KirillYatsenko/tbd/PCB/README.md

Kiсad 9.0 is used

Board status:

STM32MP157 Reviews are required:
  Unit A -  MG Power symbol (Unit A) review done, One more look from another person is required.

  Unit B -

  Unit C -

  Unit D -

  Unit E -

  Unit F -
