KirillYatsenko/tbd/PCB/DOC/Seeed NPi - STM32MP157C v1.0_191212 (3).pdf

# Initial Release

03 | 1000M Ethernet

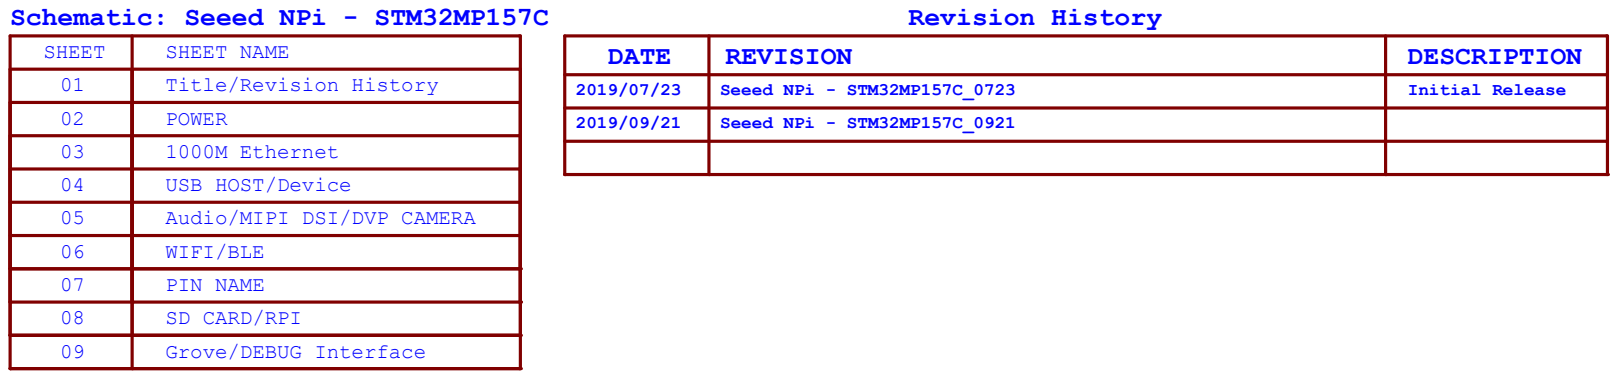
[picture p5: page 1]
Seeed NPi - STM32MP157C_0723; DESCRIPTION; DATE; Revision History; SHEET; SHEET NAME; REVISION; Schematic: Seeed NPi - STM32MP157C; Seeed NPi - STM32MP157C_0921; Title: Size:; Document Number:; Rev: Draw By:; Date:; Sheet:; https://www.seeedstudio.com A3; v1.01 weifeng; Monday, December 16, 2019; 9 Seeed NPi - STM32MP157C; 01 Title / Revision History Title: Size:

Title/Revision History
POWER

04 | USB HOST/Device
05 | Audio/MIPI DSI/DVP CAMERA
06 | WIFI/BLE
07 PIN NAME
08 SD CARD/RPI
09 Grove/DEBUG Interface

01 Title / Revision History

# Input Current:2A

# Output Current:3A

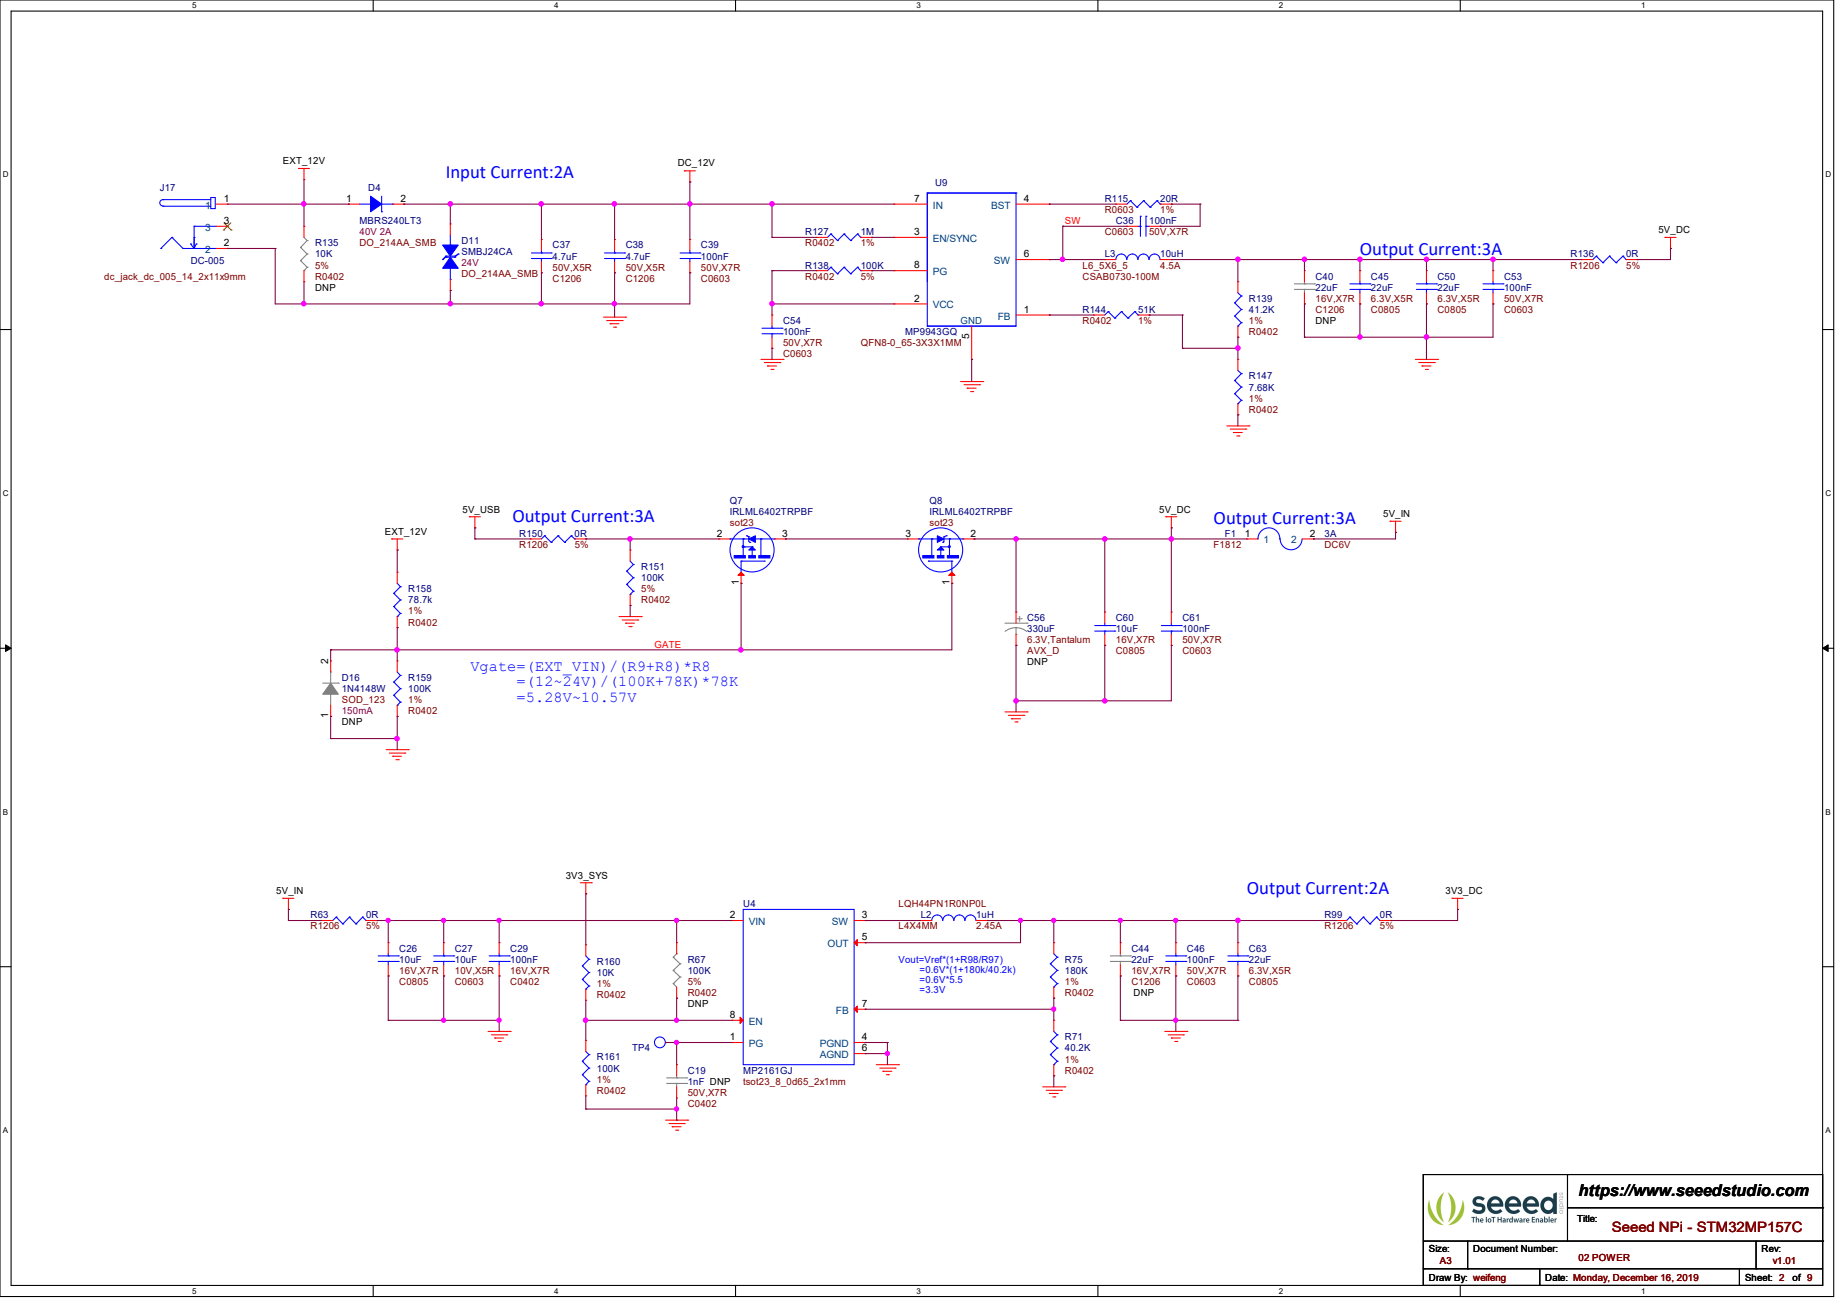
[picture p6: page 2]

# Pin33 PHY Address: 0 (Default) Dis 125MHz Output

# impedance. CLK125_EN:

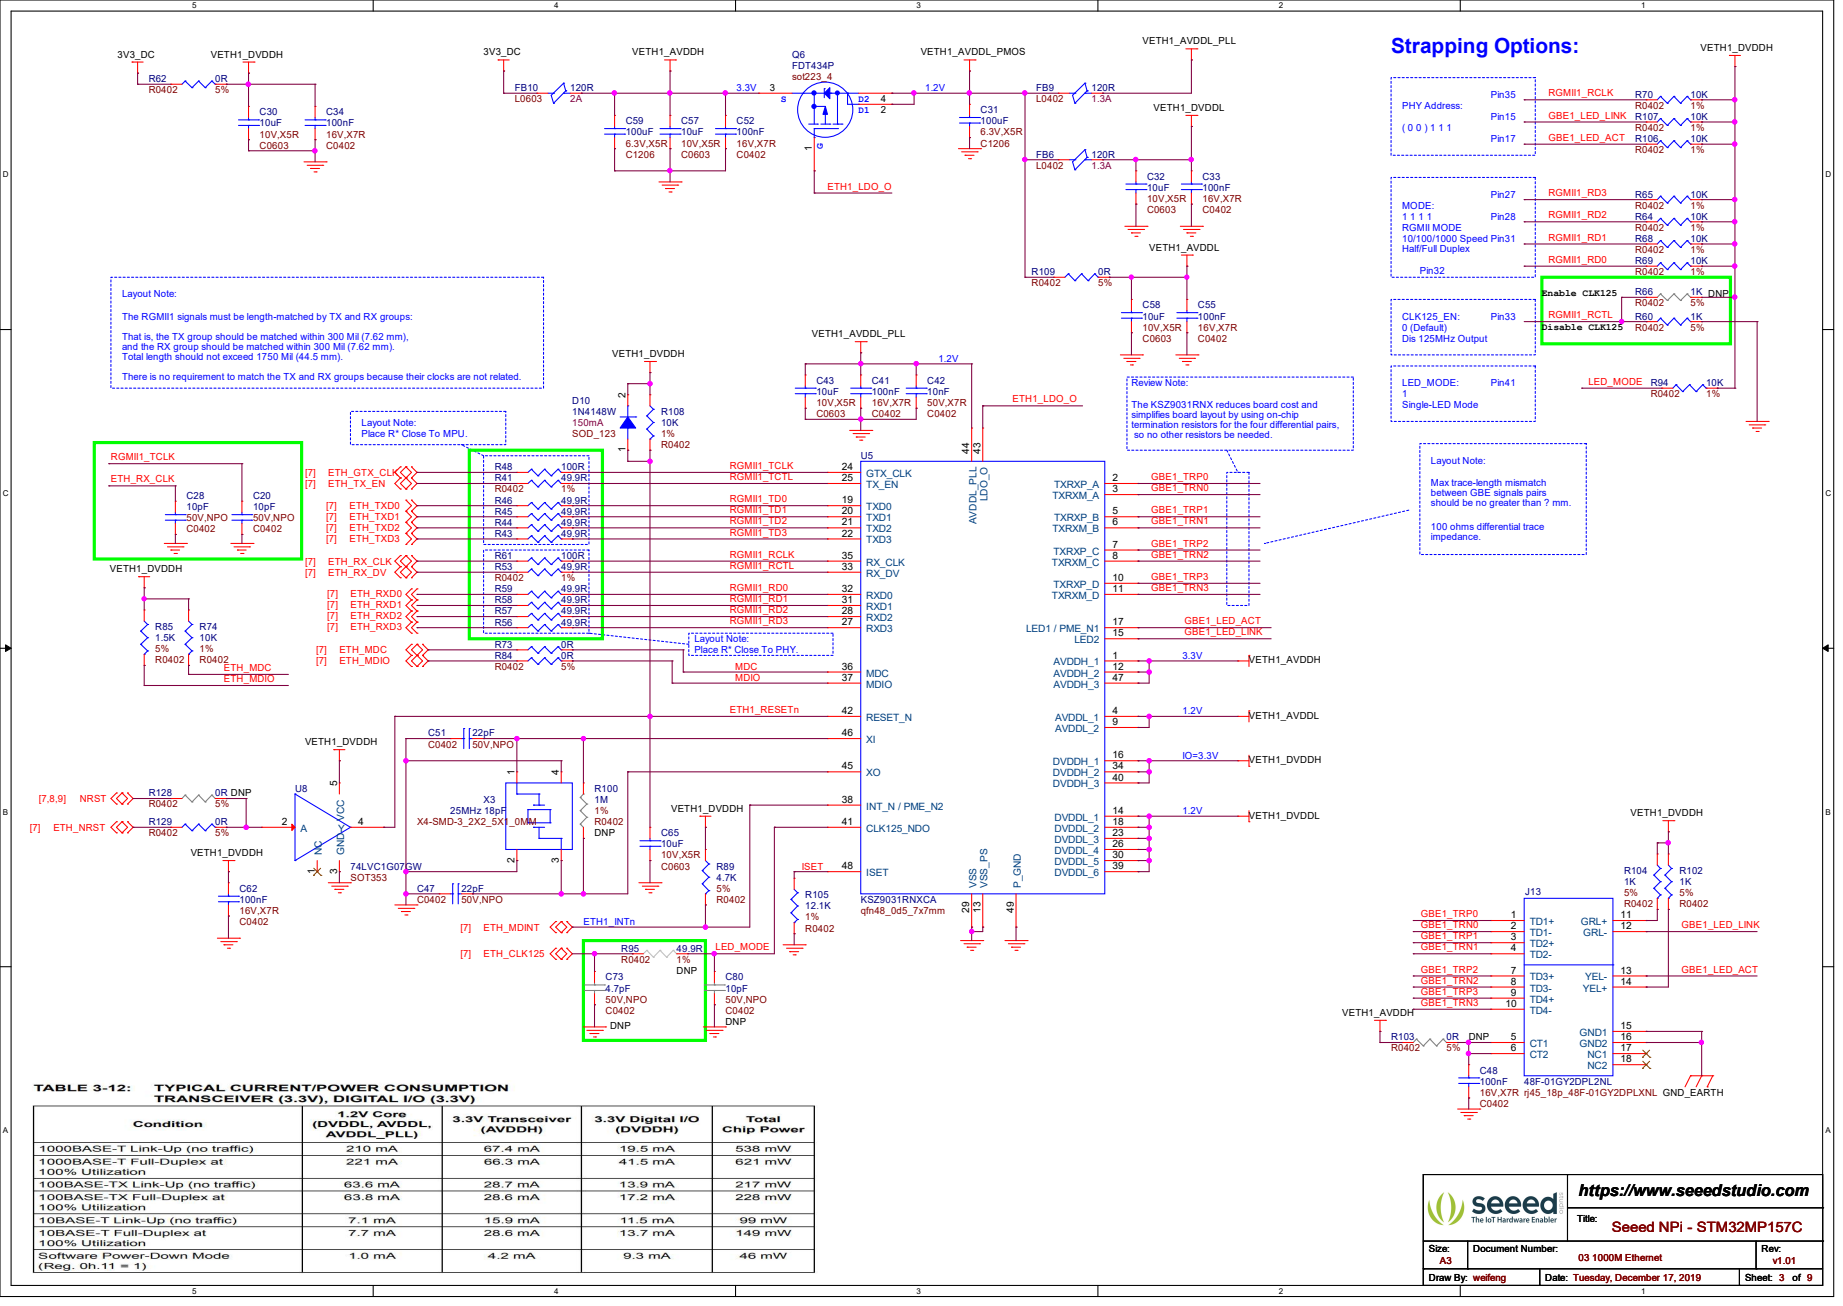
[picture p7: page 3]

LED_MODE: The KSZ9031RNX reduces board cost and

simplifies board layout by using on-chip
termination resistors for the four differential pairs,

between GBE signals pairs
should be no greater than ? mm.

# USB HOST

USB_A_Upper | USB_B_Lower

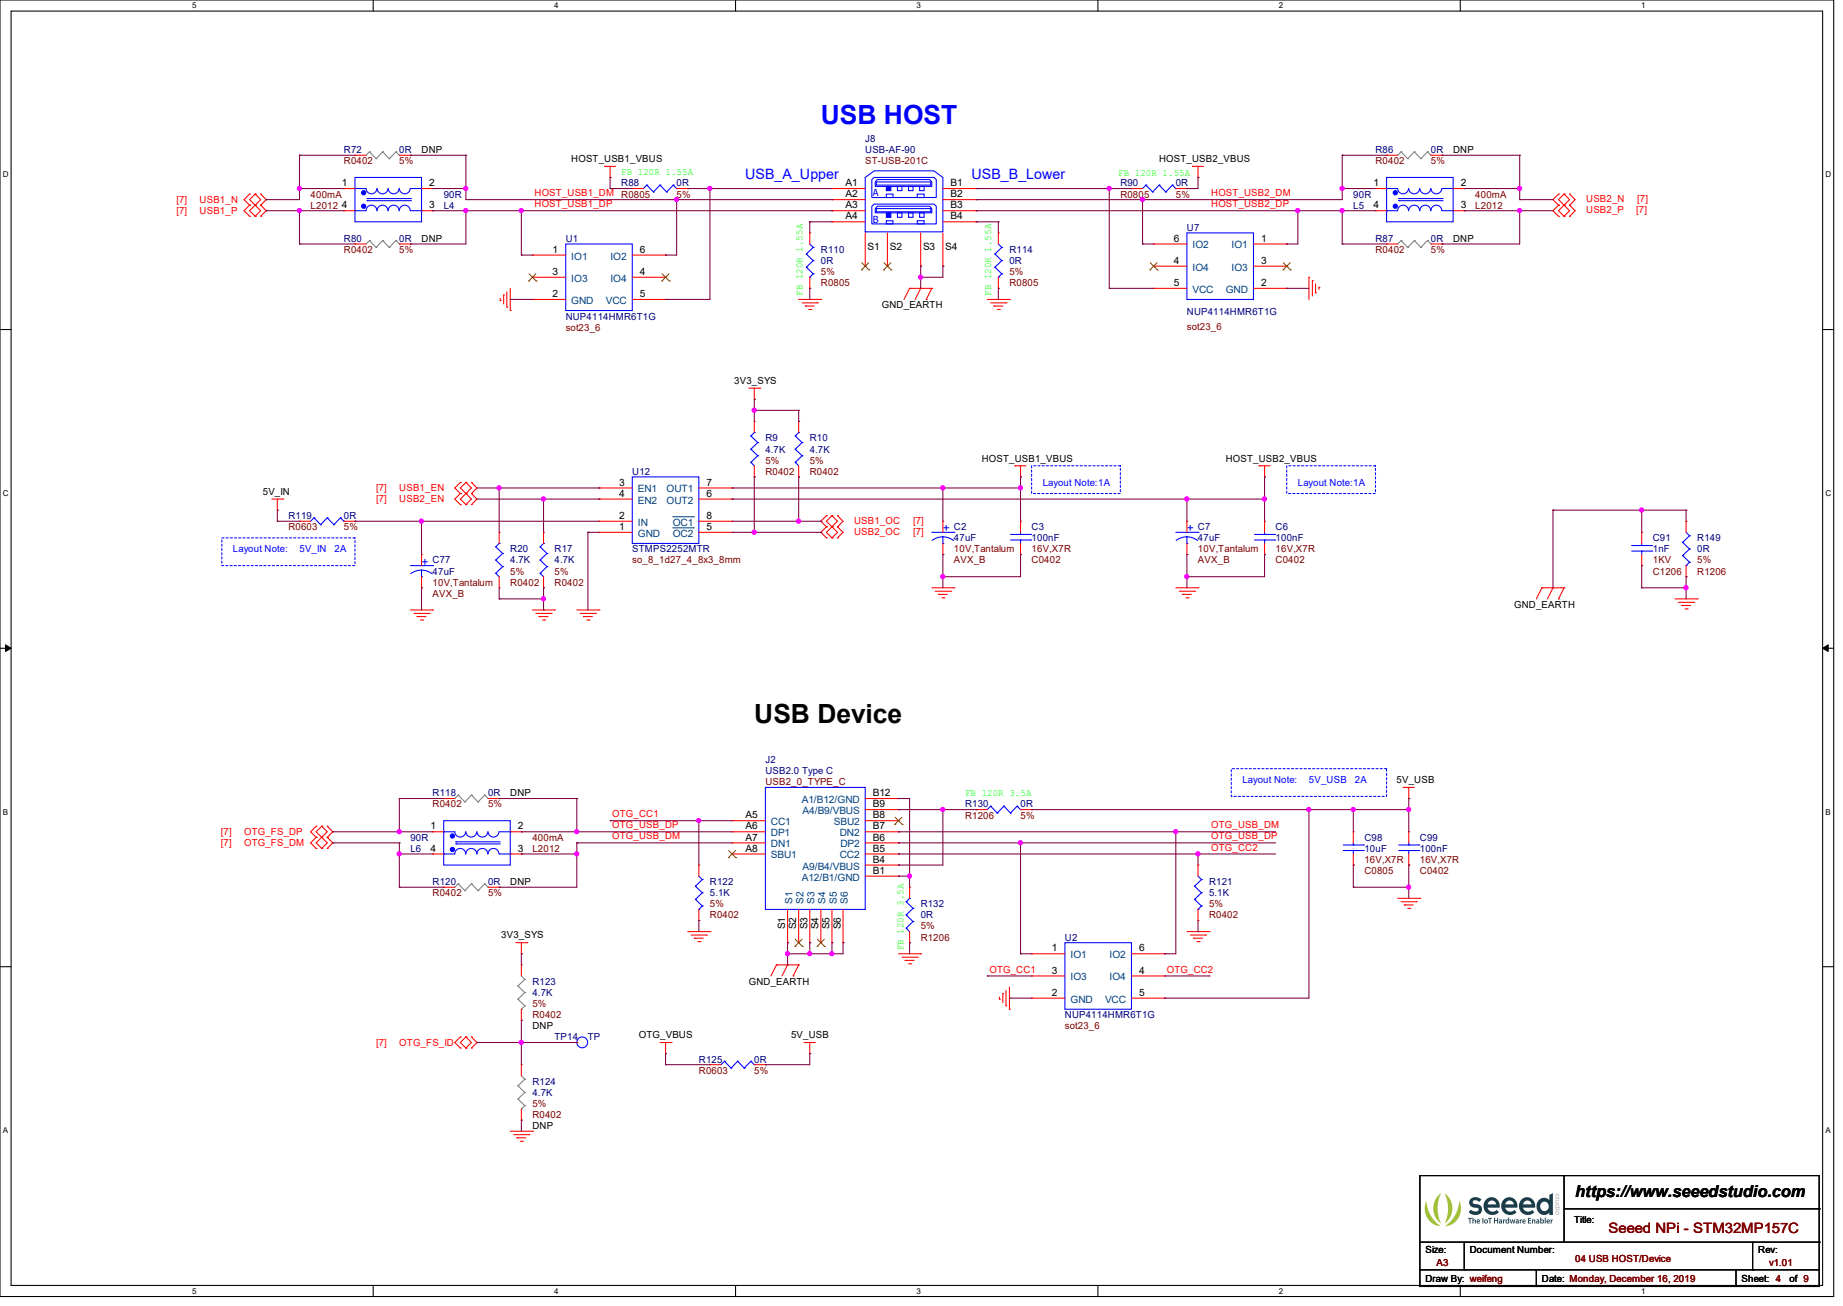
[picture p8: page 4]

# Serial Audio Interface (SAI)

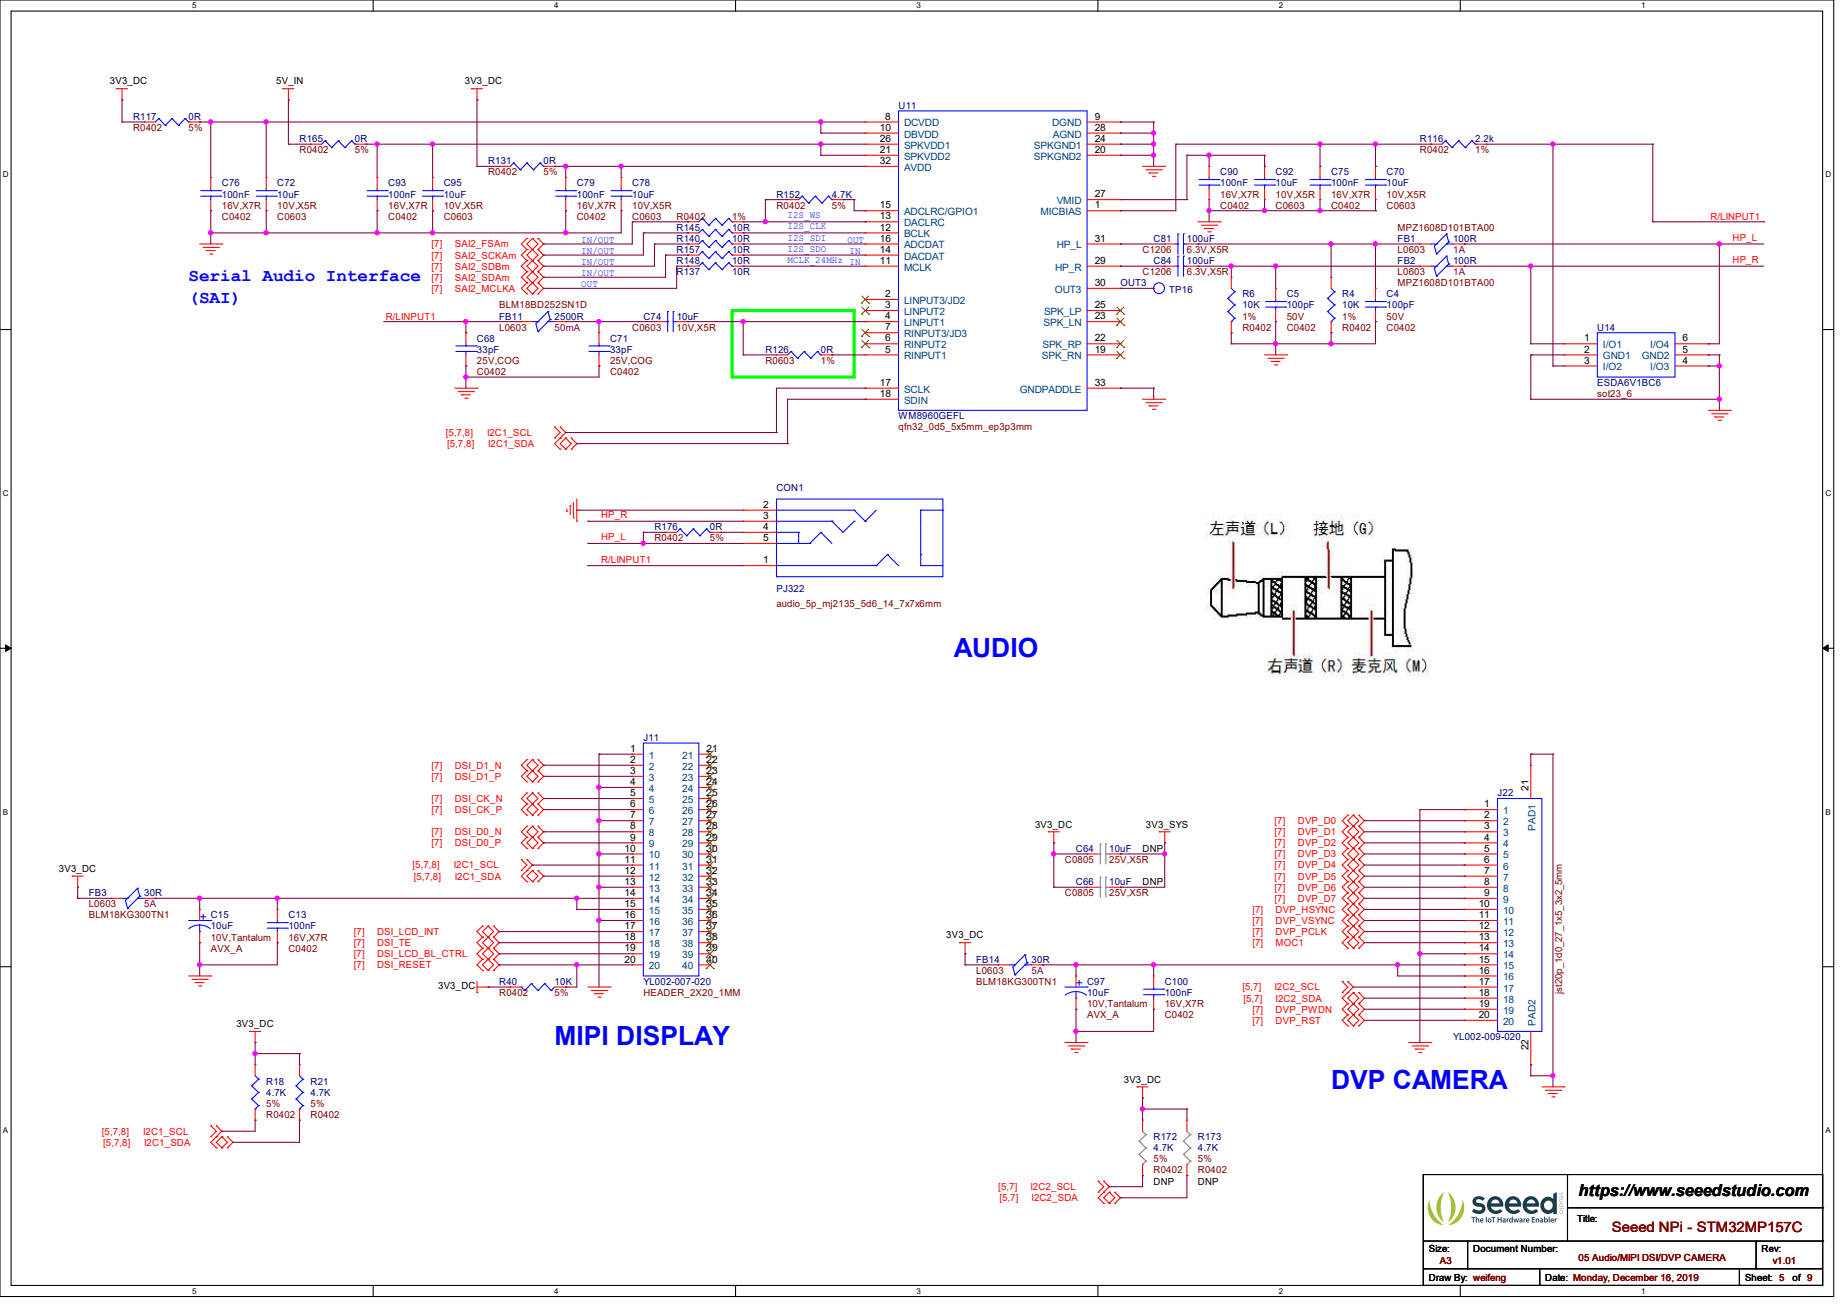
[picture p9: page 5]

U11 WM8960GEFL
DCVDD 8 DBVDD 10 SPKVDD1 26 SPKVDD2 21 AVDD 32 ADCLRC/GPIO1 15 DACLRC 13 BCLK 12 ADCDAT 16 DACDAT 14 MCLK 11

05 Audio/MIPI DSI/DVP CAMERA

# U3 AP6236 Module44-0_9-12X12X1_5MM

GND 1 | WL_BT_ANT 2 | GND_1 3 | FM_RX 4 | NC 5 | BT_WAKE 6 | BT_HOST_WAKE 7 | NC_1 8 | VBAT 9 | XTAL_IN 10 | XTAL_OUT 11 | WL_REG_ON 12 | WL_HOST_WAKE 13 | SDIO_DATA_2 14 | SDIO_DATA_3 15 | SDIO_DATA_CMD 16 | SDIO_DATA_CLK 17 | SDIO_DATA_0 18 | SDIO_DATA_1 19 | GND_2 20 | VIN_LDO_OUT 21 | VDDIO 22 | VIN_LDO | 23 LPO | 24 PCM_OUT | 25 PCM_CLK | 26 PCM_IN | 27 PCM_SYNC | 28 NC_2 | 29 NC_3 | 30 GND_3 | 31 NC_4 | 32 GND_4 | 33 BT_RST_N ³⁴ NC_5 35 GND_5 36 GPIO⁴ ³⁷ GPIO³ ³⁸ GPIO² ³⁹ GPIO¹ ⁴⁰ UART_RTS_N ⁴¹ UART_TXD ⁴² UART_RXD ⁴³ UART_CTS_N ⁴⁴ TP¹ ⁴⁵ TP² ⁴⁶ TP³ ⁴⁷ | FB7 | 120R

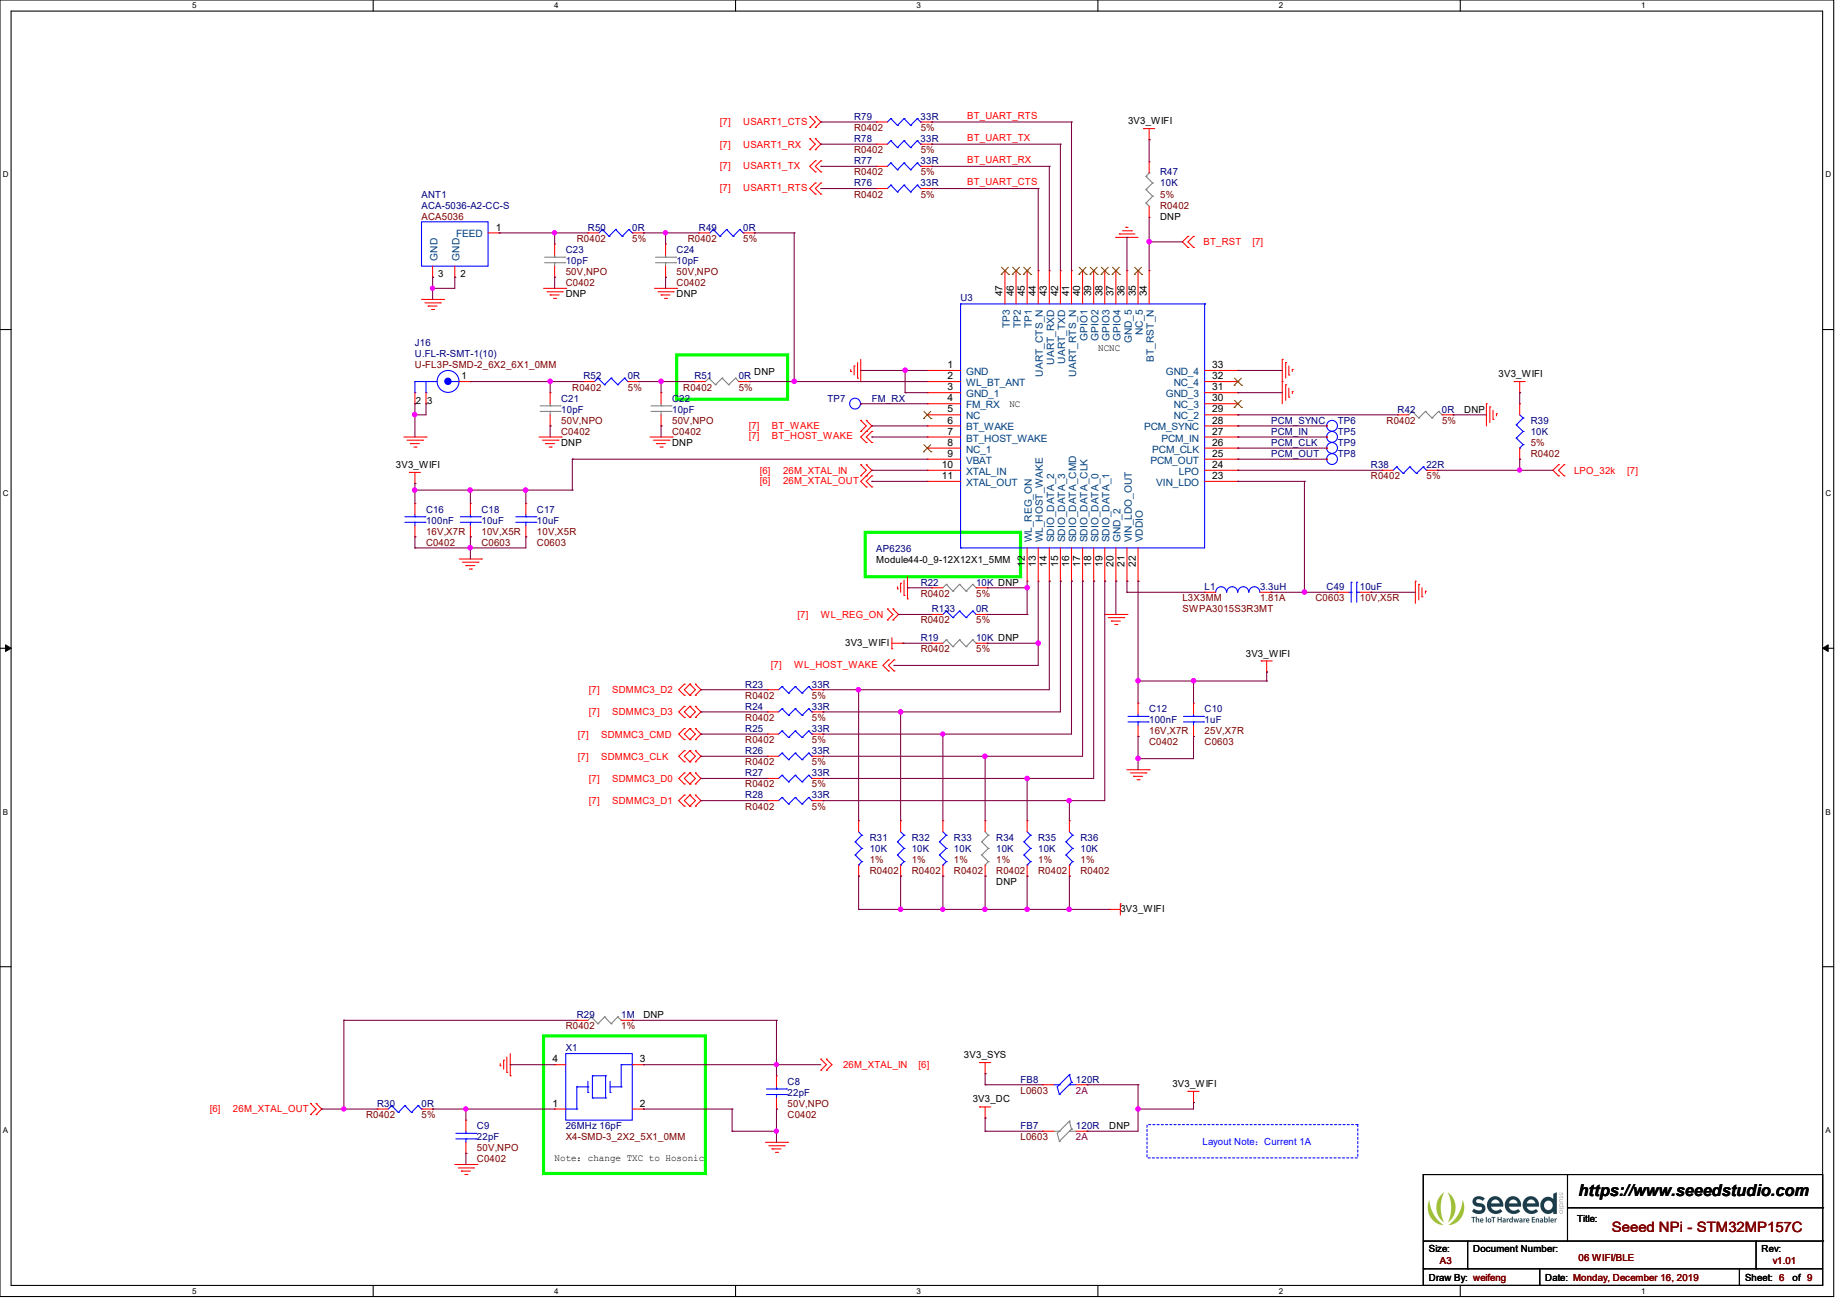
[picture p10: page 6]

Note：change TXC to Hosonic

# LTDC_G1HDMI_CEC

ETH_RX_DV [3] ETH_CLK125 [3] ETH_RX_CLK [3] ETH_GTX_CLK [3] ETH_TX_EN [3] ETH_MDC [3] ETH_MDIO [3] ETH_NRST [3] ETH_MDINT [3] DVP_D0 [5] DVP_D1 [5] DVP_D2 [5] DVP_D3 [5] DVP_D4 [5] DVP_D5 [5] DVP_D6 [5] DVP_D7 [5] DVP_HSYNC | [5] DVP_VSYNC | [5] DVP_PCLK [5] MOC1 [5] DVP_PWDN | [5]

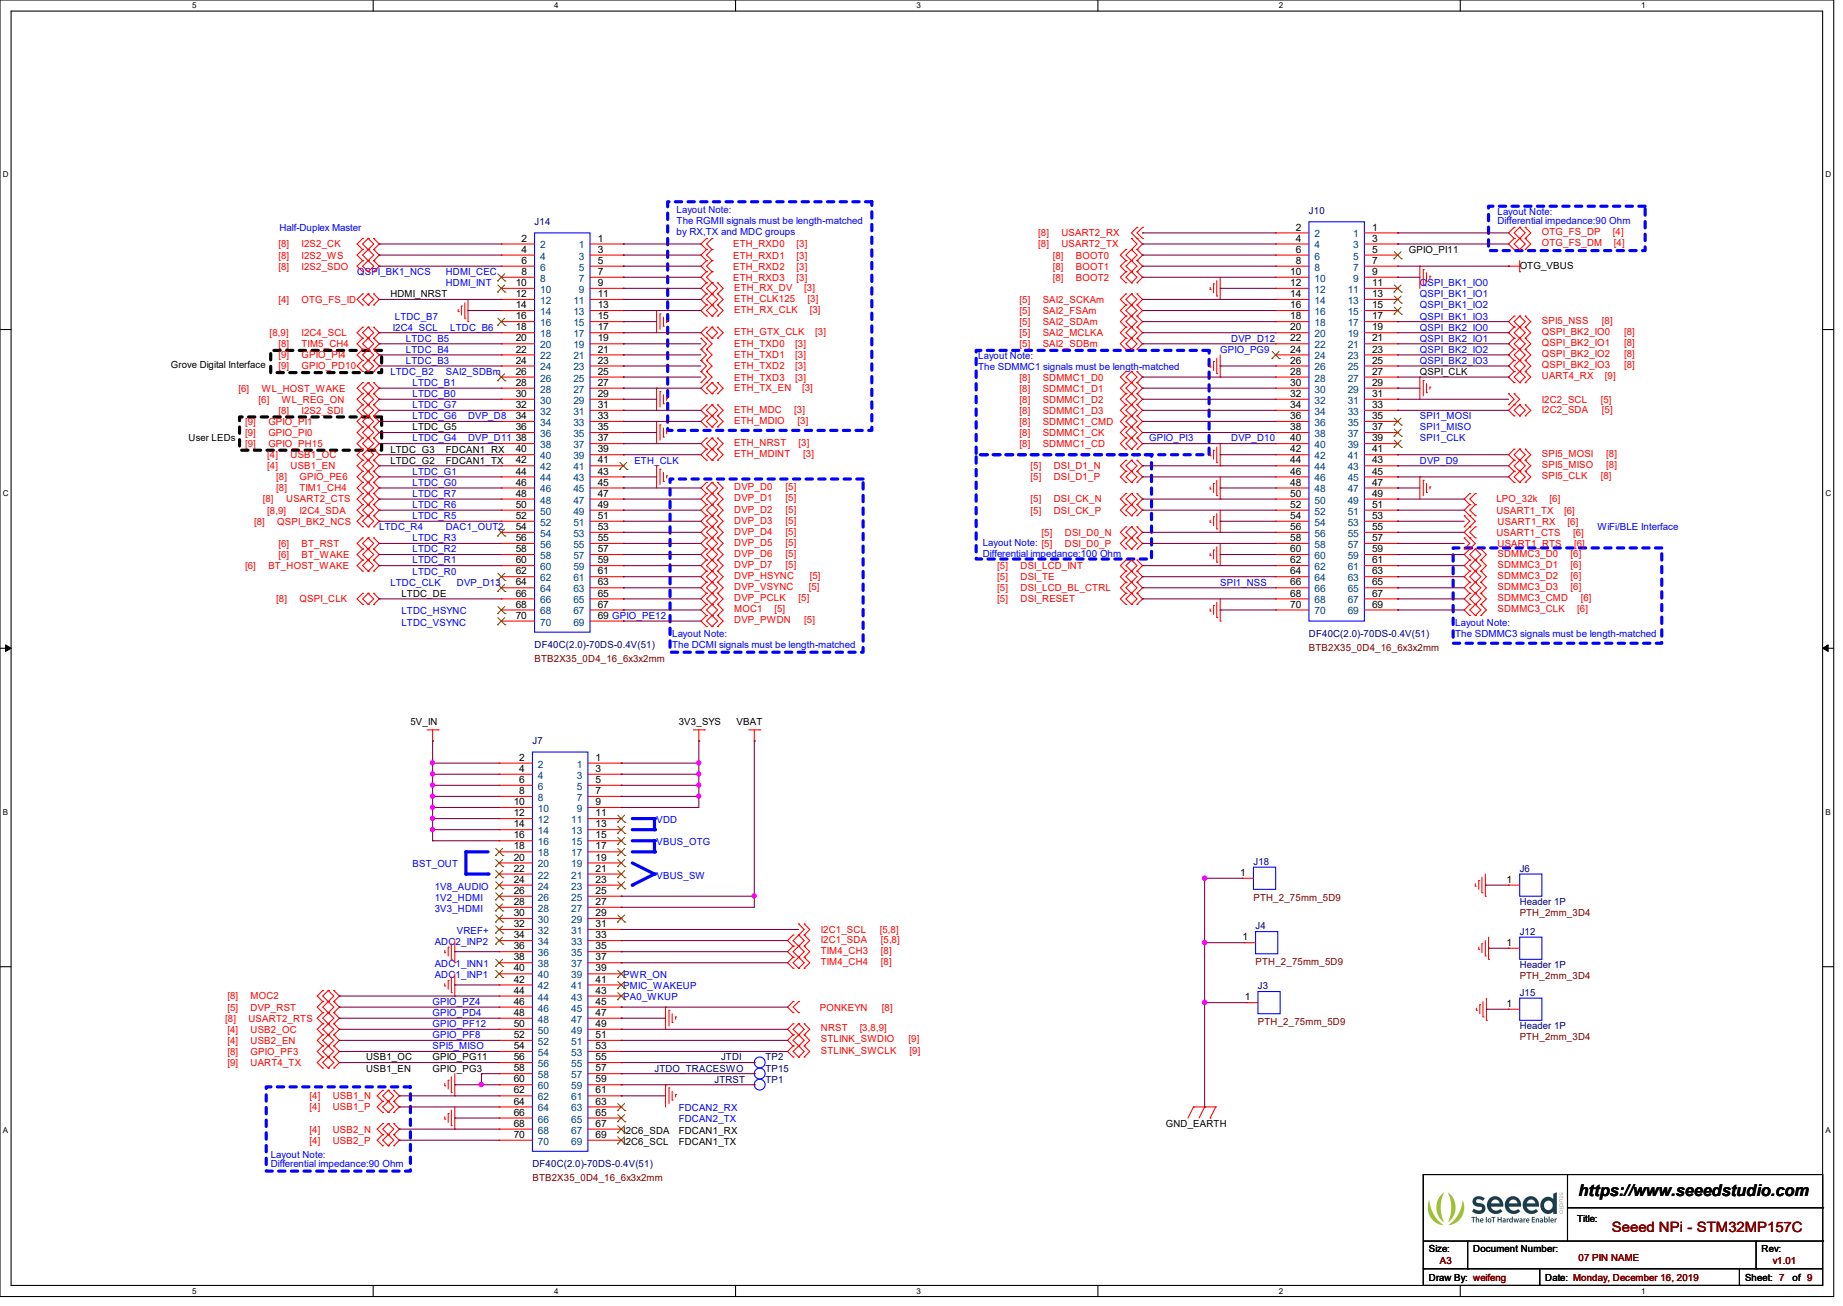
[picture p11: page 7]

Differential impedance:90 Ohm Layout Note: LTDC_B6

Layout Note:
The RGMII signals must be length-matched
by RX,TX and MDC groups
LTDC_G7DVP_D13 SAI2_SDBm
LTDC_B1
LTDC_B0

The SDMMC3 signals must be length-matched

The DCMI signals must be length-matched

# RPI Interface

# J19 Header 2x20 2.54mm

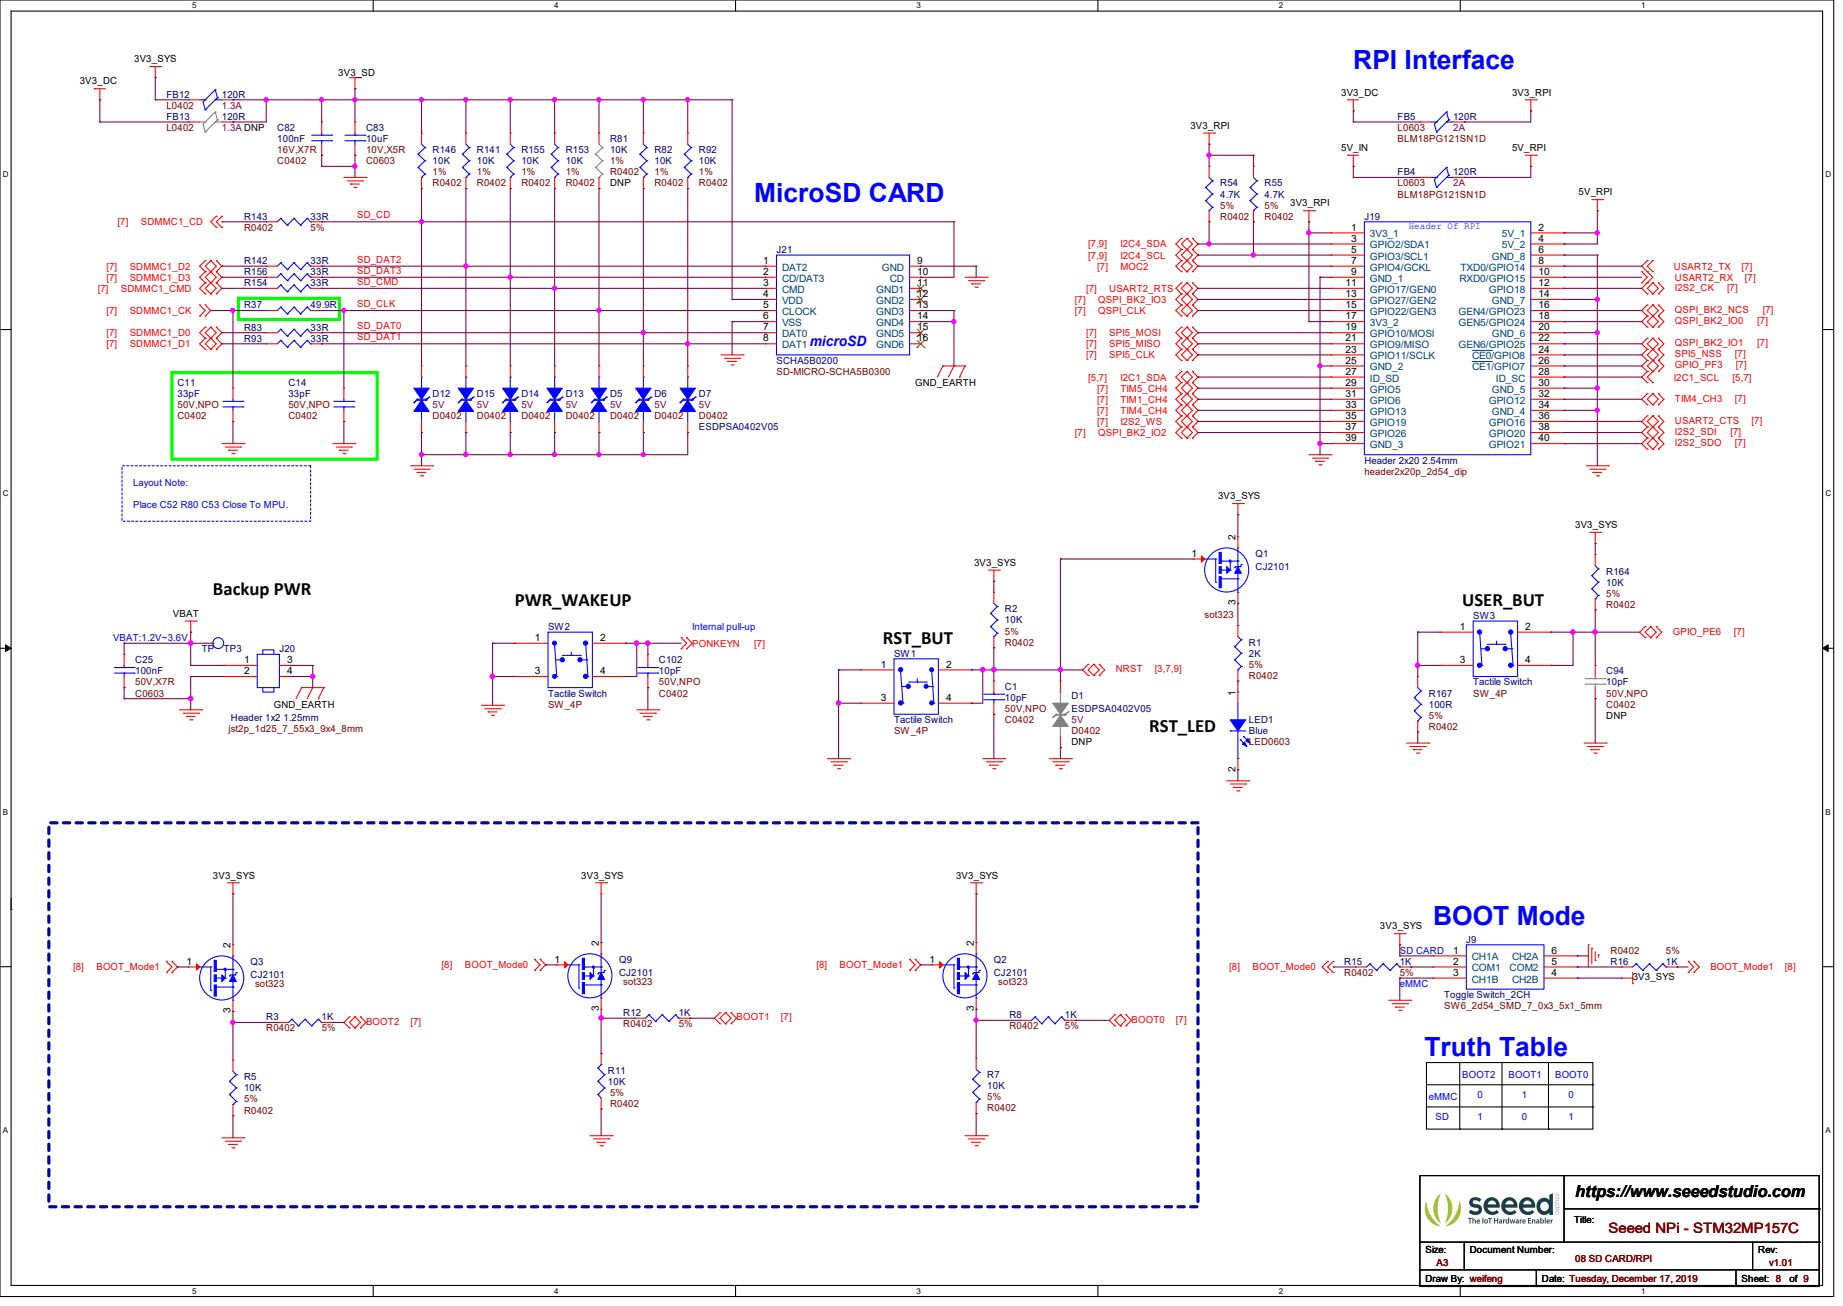
[picture p12: page 8]

MicroSD CARD Layout Note: Place C52 R80 C53 Close To MPU. VBAT:1.2V~3.6V

# USER_LED

USR1 | USR2 | USR0

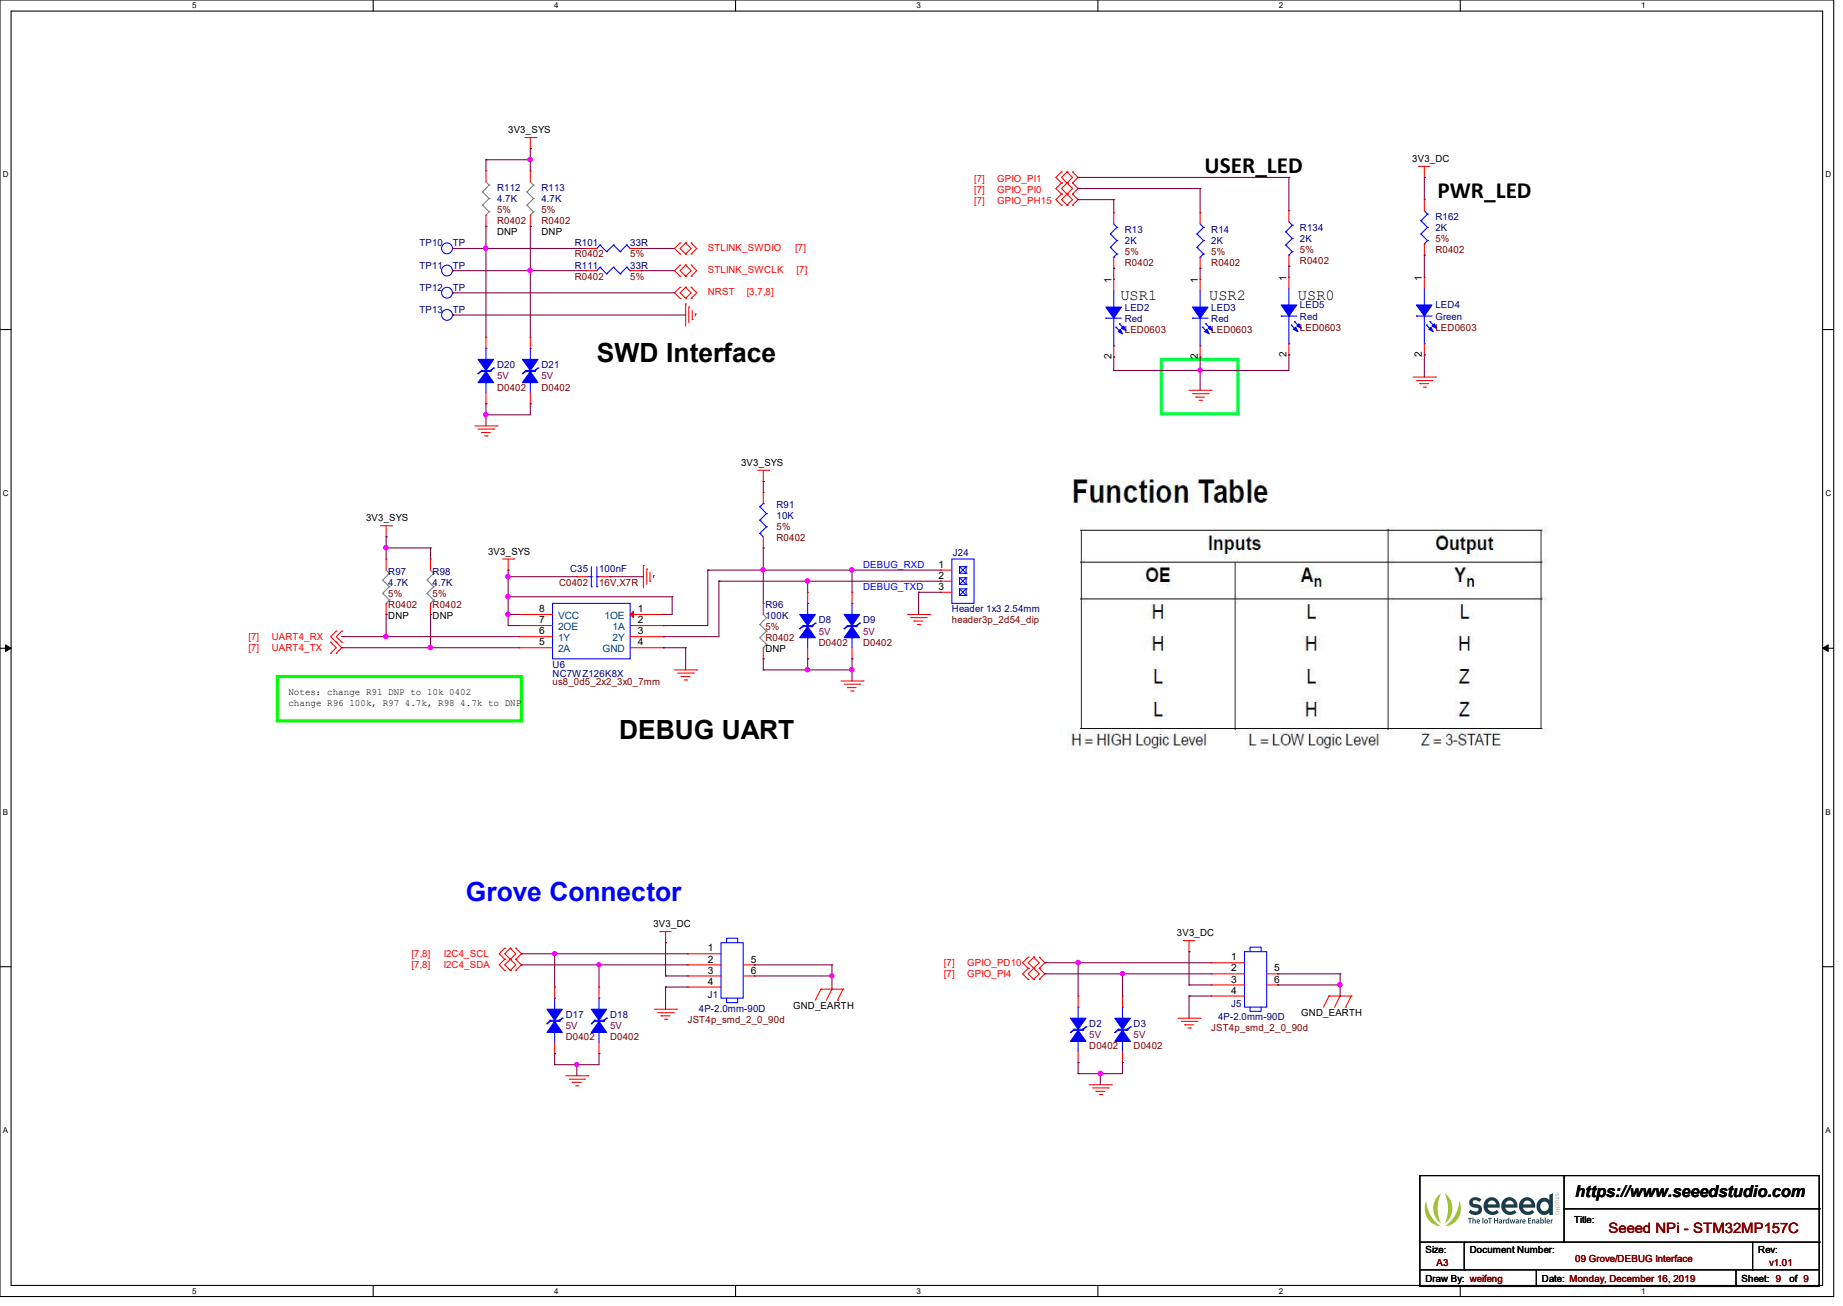
[picture p13: page 9]

Notes：change R91 DNP to 10k 0402
change R96 100k, R97 4.7k, R98 4.7k to DNP
