KirillYatsenko/tbd/PCB/DOC/Seeed SoM - STM32MP157C v1.0_191212 (1).pdf

# Initial Release

03

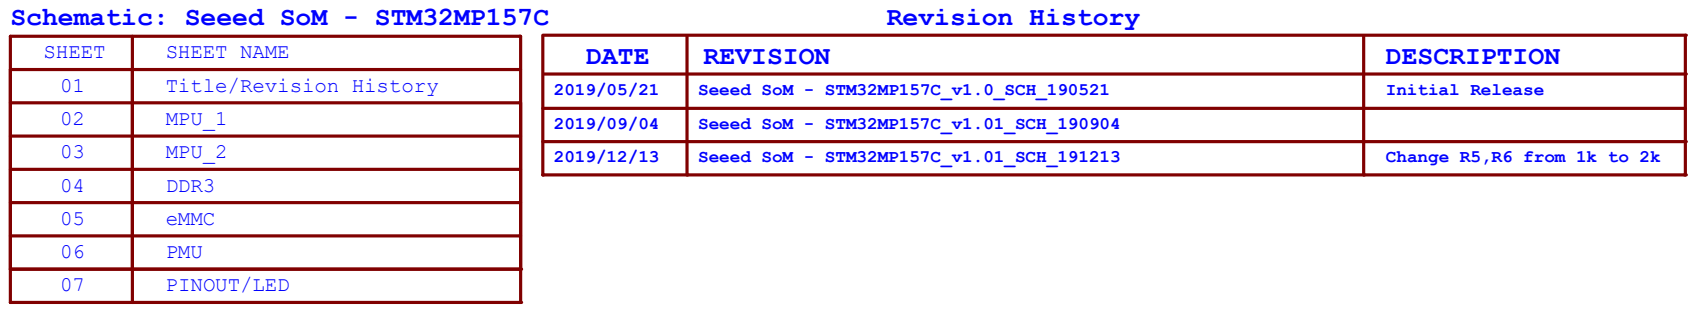
[picture p14: page 1]
Seeed SoM - STM32MP157C_v1.0_SCH_190521; DESCRIPTION; MPU_2; DATE; Title/Revision History; Revision History; SHEET; SHEET NAME; REVISION; Schematic: Seeed SoM - STM32MP157C; MPU_1; Seeed SoM - STM32MP157C_v1.01_SCH_190904; Seeed SoM - STM32MP157C_v1.01_SCH_191213; Change R5,R6 from 1k to 2k; Title: Size:; Document Number:; Rev: Draw By:; Date:; Sheet:; https://www.seeedstudio.com A3; v1.01 weifeng; Friday, December 13, 2019; 7 Seeed SoM - STM32MP157C; 01 Title / Revision History Title: Size:

04 | DDR3
05 | eMMC
06 | PMU
07 PINOUT/LED

01 Title / Revision History

I2S2_SDO | [7] DVP_D0 [7] SDMMC1_D0 [7] SDMMC1_D1 [7] SDMMC1_D2 [7] SDMMC1_D3 [7] SDMMC1_CK [7] SDMMC1_CMD [7] DVP_D5 [7] GPIO_PD4 | [7] SDMMC3_D2 [7] SDMMC3_D3 [7] LTDC_B7 [7] LTDC_B0 [7] LTDC_B3 [7] QSPI_BK1_IO0 | [7] QSPI_BK1_IO1 | [7] STLINK_SWDIO | [7] STLINK_SWCLK | [7] JTDI [7] JTDO_TRACESWO [7] JTRST [7]
ETH_RXD0 [7] ETH_RXD1 [7] FDCAN1_RX | [7] USART2_RX [7] ETH_TXD2 [7] FDCAN1_TX [7] DSI_TE [7]

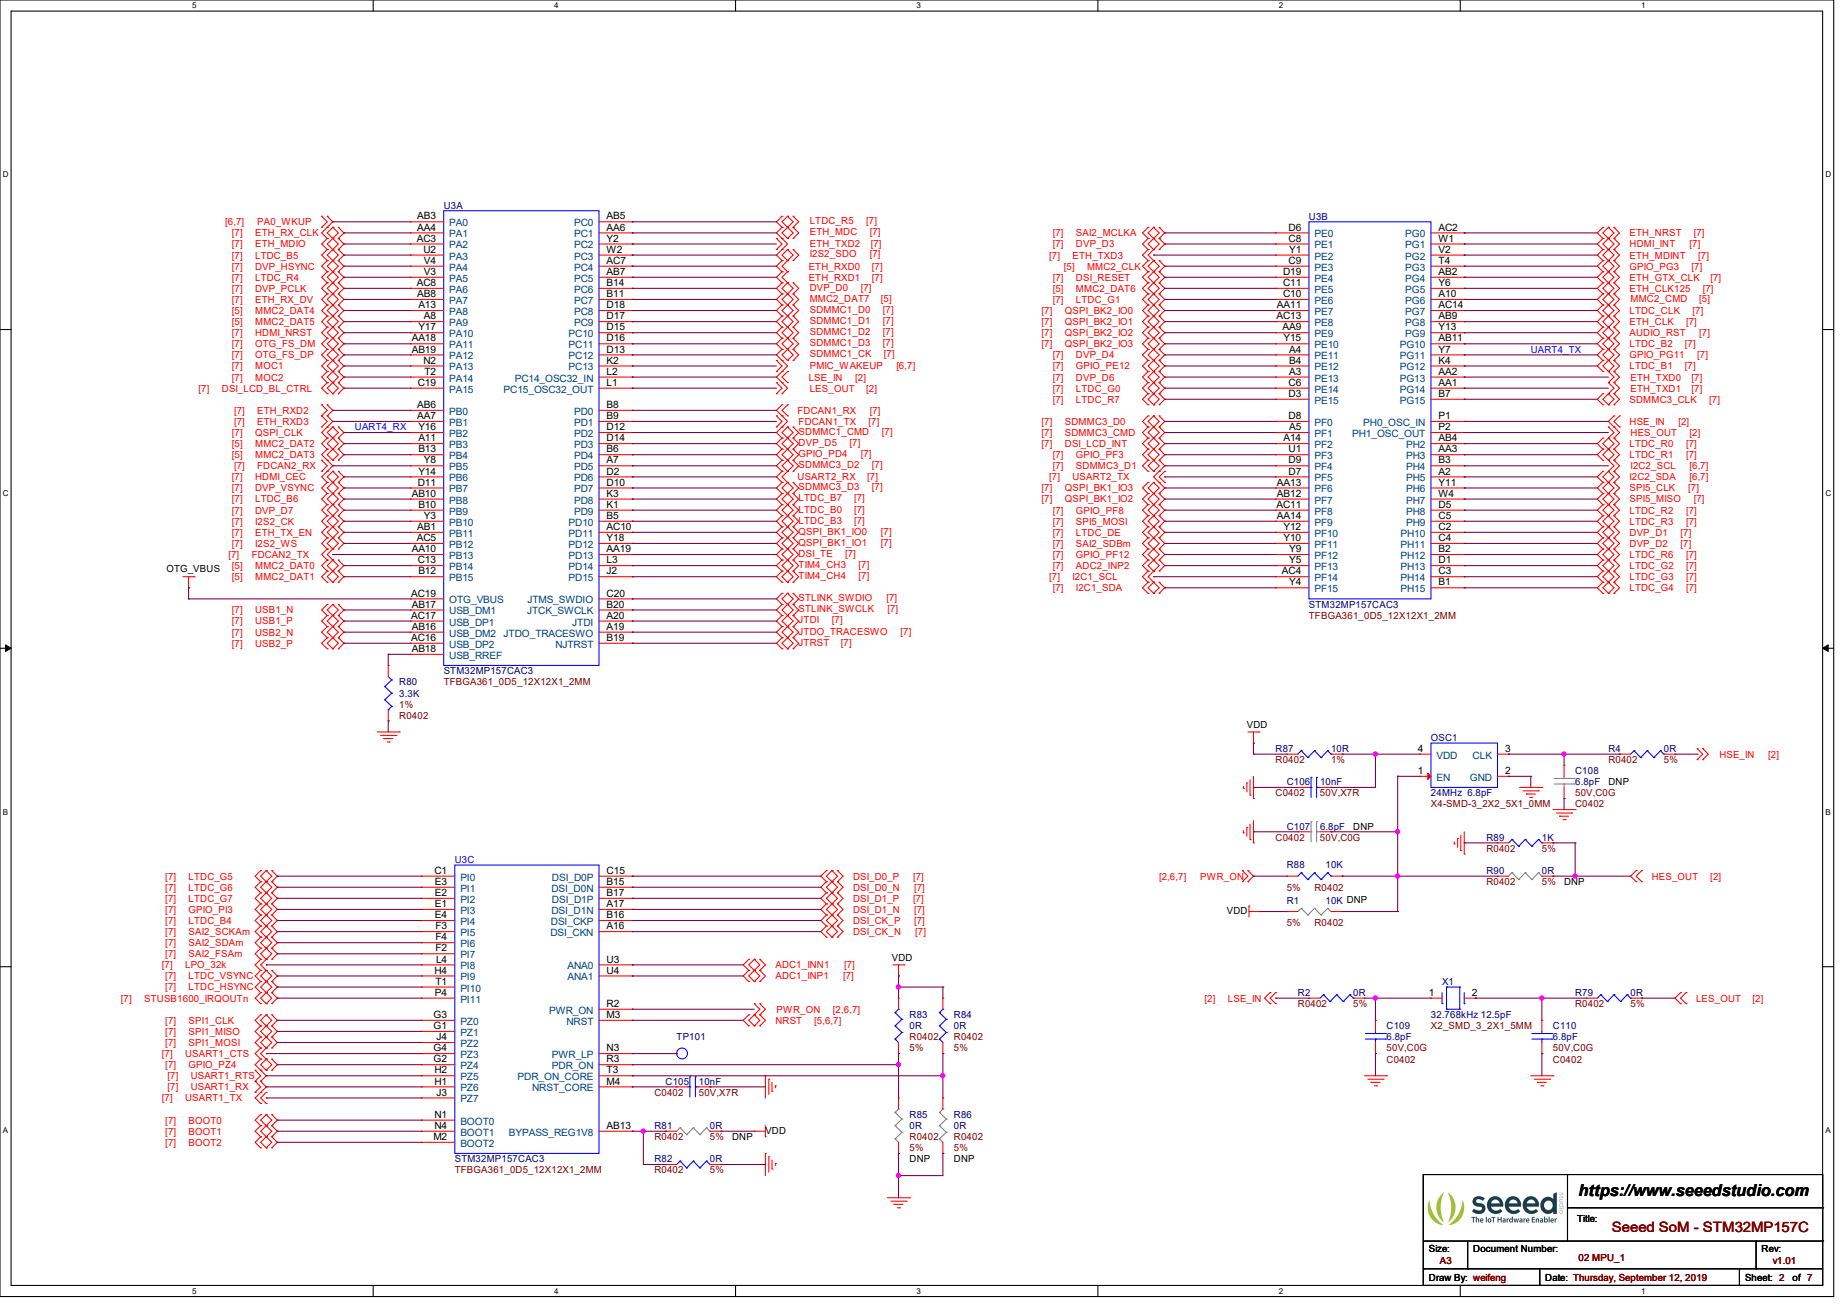
[picture p15: page 2]

VDDCORE1 1A2 VDDCORE2 1A4 VDDCORE3 1A6 VDDCORE4 1B1 VDDCORE5 1B3 VDDCORE6 1B5 VDDCORE7 1C2 VDDCORE8 1C4 VDDCORE9 1C6 VDDCORE10 1D1 VDDCORE11 1D3 VDDCORE12 1D5 VDDCORE13 1D7 VDDCORE14 1E2 VDDCORE15 1E4 VDDCORE16 1E6 VDDCORE17 1F5 VDDCORE18 1F7 VDDCORE19 1G6 VDDCORE20 1H7 VDD1 1F3 VDD2 1G4 VDD3 1H3 VDD4 1H5 VDD5 1J4 VDD6 1J6 VDDQ_DDR1 1A8 VDDQ_DDR2 1B7 VDDQ_DDR3 1B9 VDDQ_DDR4 1C8 VDDQ_DDR5 1D9 VDDQ_DDR6 1E8 VDDQ_DDR7 1F9 VDDQ_DDR8 1G8 VDDQ_DDR9 1H9 VDDQ_DDR10 1J8 VBAT 1F1 VDD_OTP 1J2 VDDA 1H1 VREF+ R4 VSSA 1H2 VDD_ANA 1G2 VDD_DSI B18 VDDA1V1_REG AB15 VDDA1V8_REG AB14 VDDA1V8_DSI C14 VDD1V2_DSI_PHY C17 VDD1V2_DSI_REG C18 VDD3V3_USBHS AA15 VDD3V3_USBFS AA17 VSS_USBHS AA16 VSS_DSI C16 VSS_ANA 1G1

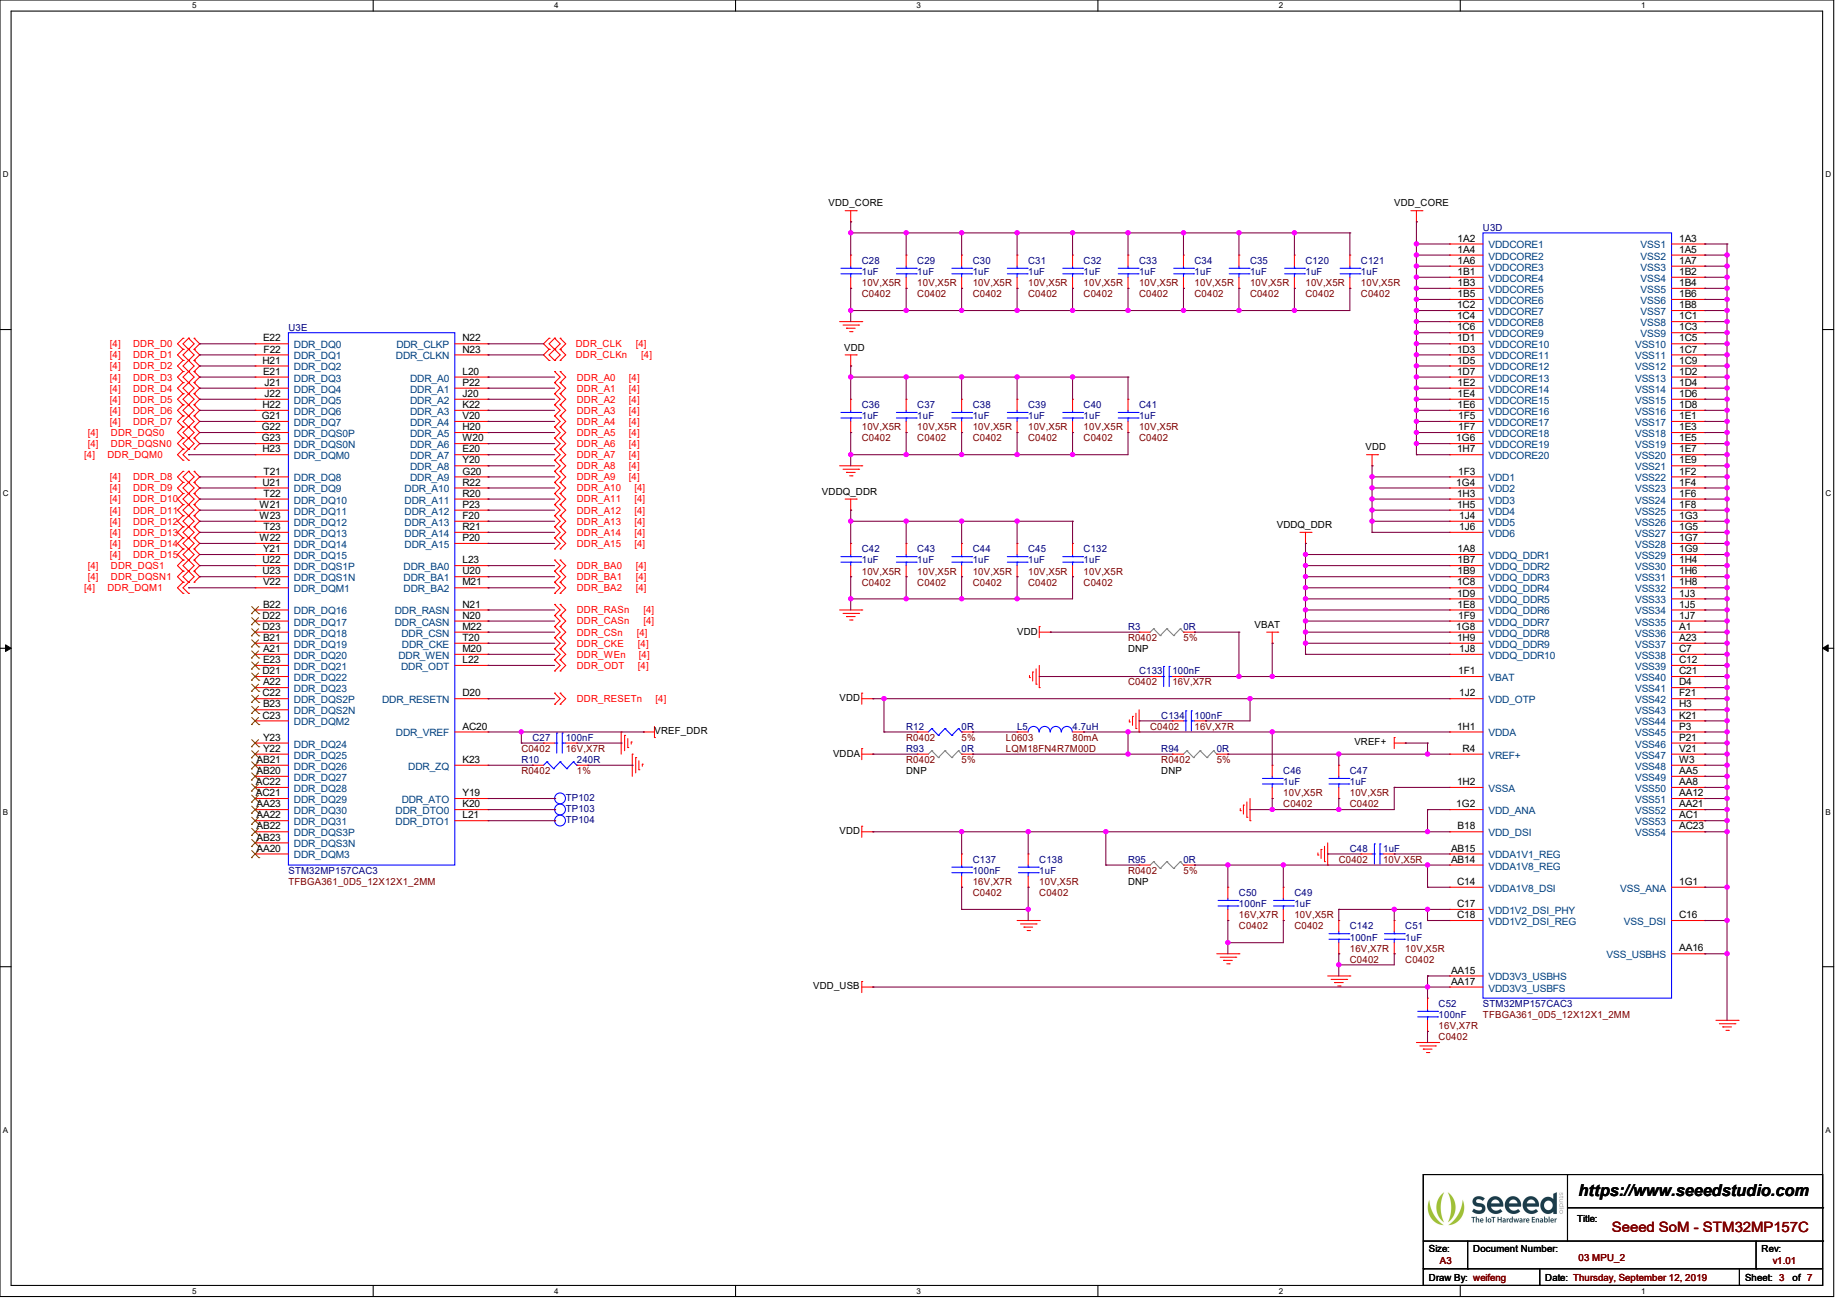
[picture p16: page 3]

# DDR3L SDRAM

CK J7 CKn K7 CKE K9 CSn L2 RASn J3 CASn K3 WEn L3 | A0 N3 A1 P7 A2 P3 A3 N2 A4 P8 A5 P2 A6 R8 A7 R2 A8 T8 A9 R3 A10 L7 A11 R7 A12 N7 A13 T3 A14 T7 BA0 M2 BA1 N8 BA2 M3 DQ0 E3 DQ1 F7 DQ2 F2 DQ3 F8 DQ4 H3 DQ5 H8 DQ6 G2 DQ7 H7 | ODT K1 VSS1 A9 VSS2 B3 VSS3 E1 VSS4 G8 VSSQ4 D8 VSSQ3 D1 VSSQ2 B9 VSSQ1 B1 VSSQ5 E2 VDDQ1 A1 VDDQ2 A8 VDDQ3 C1 VDDQ4 C9 VDDQ5 D2 | VDD1 B2 VDD2 G7 UDQSn B7 UDM D3

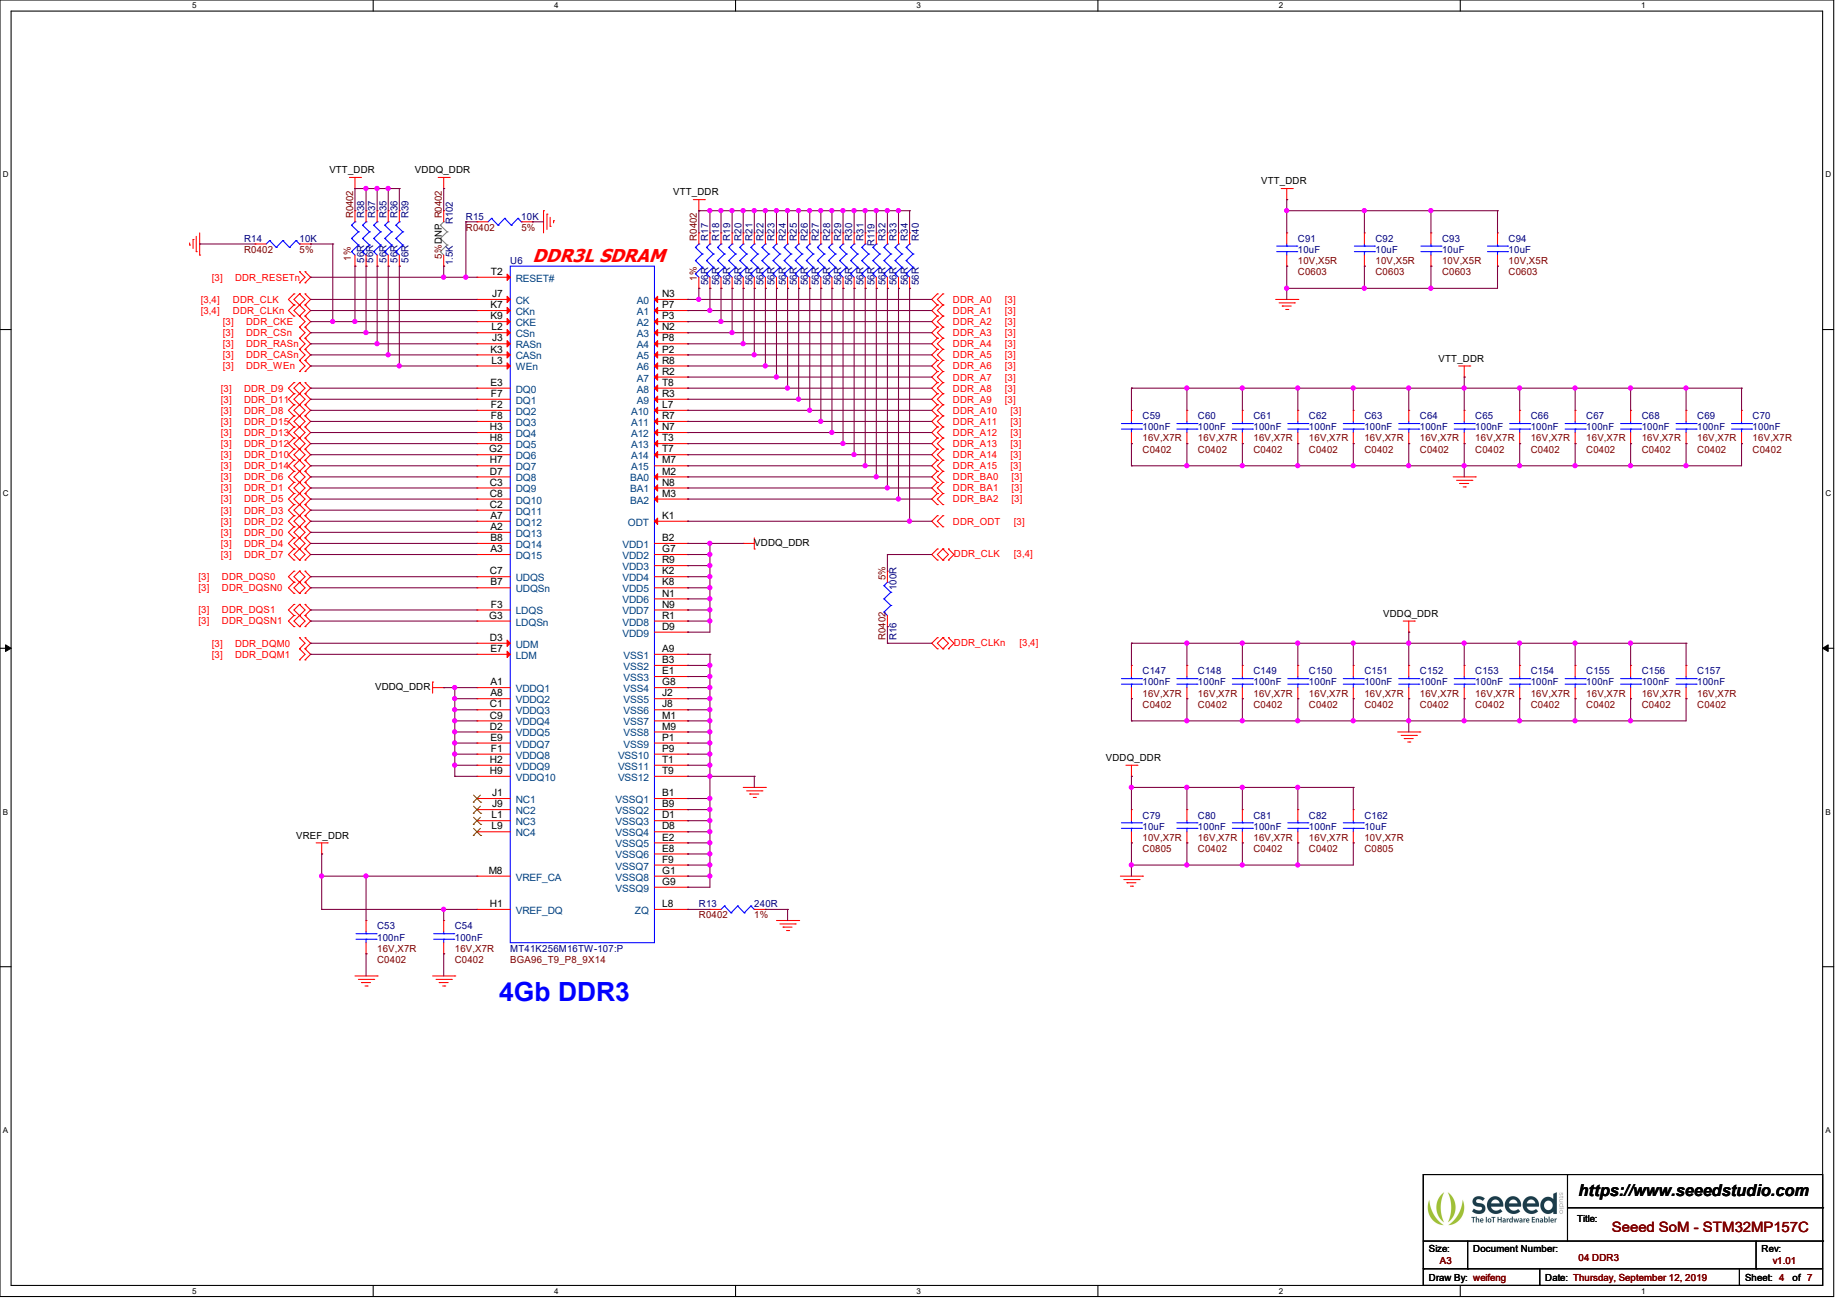
[picture p17: page 4]

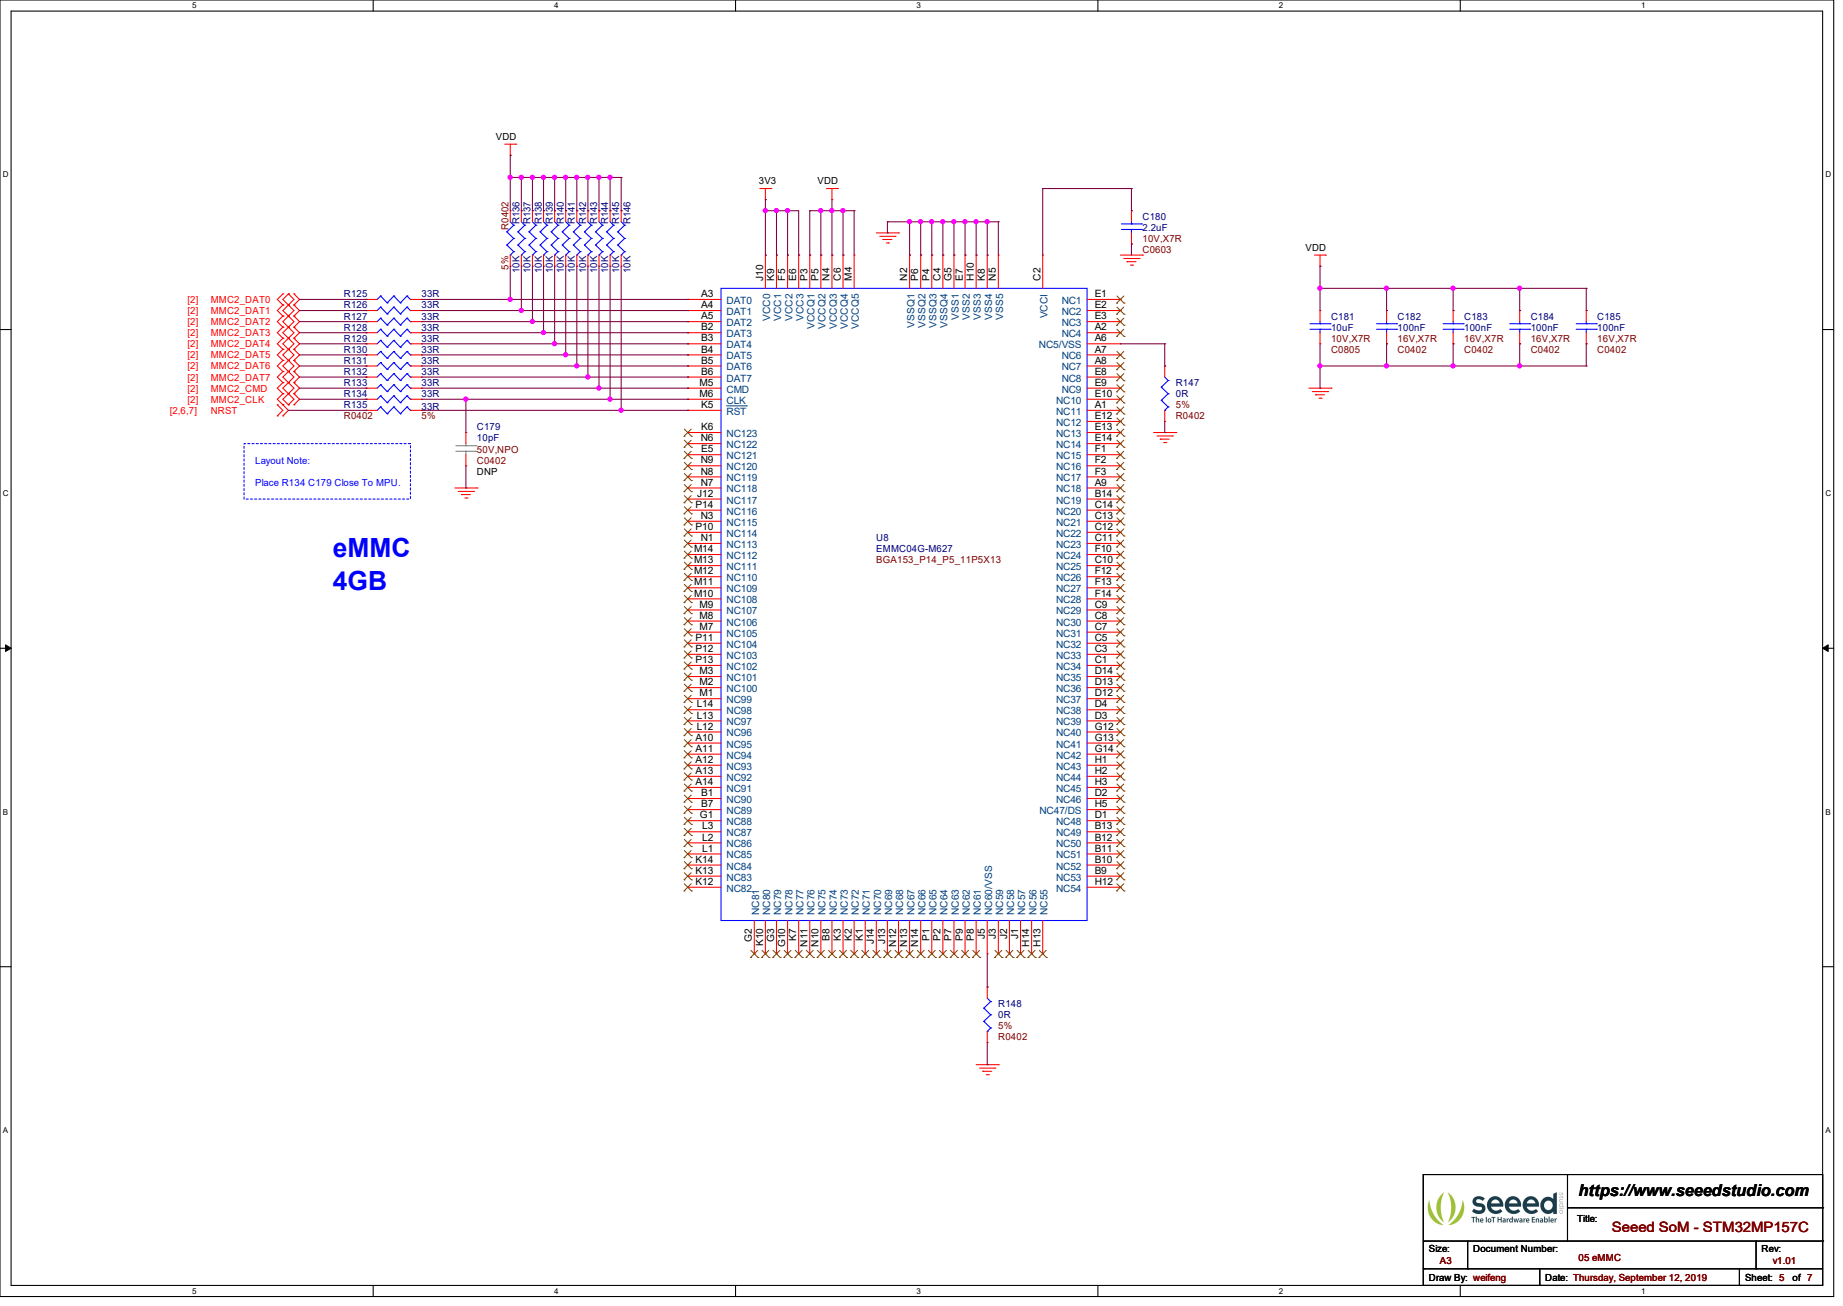
[picture p18: page 5]

eMMC Place R134 C179 Close To MPU.

## Defaut Output:1.2V

## Defaut Output:1.1V

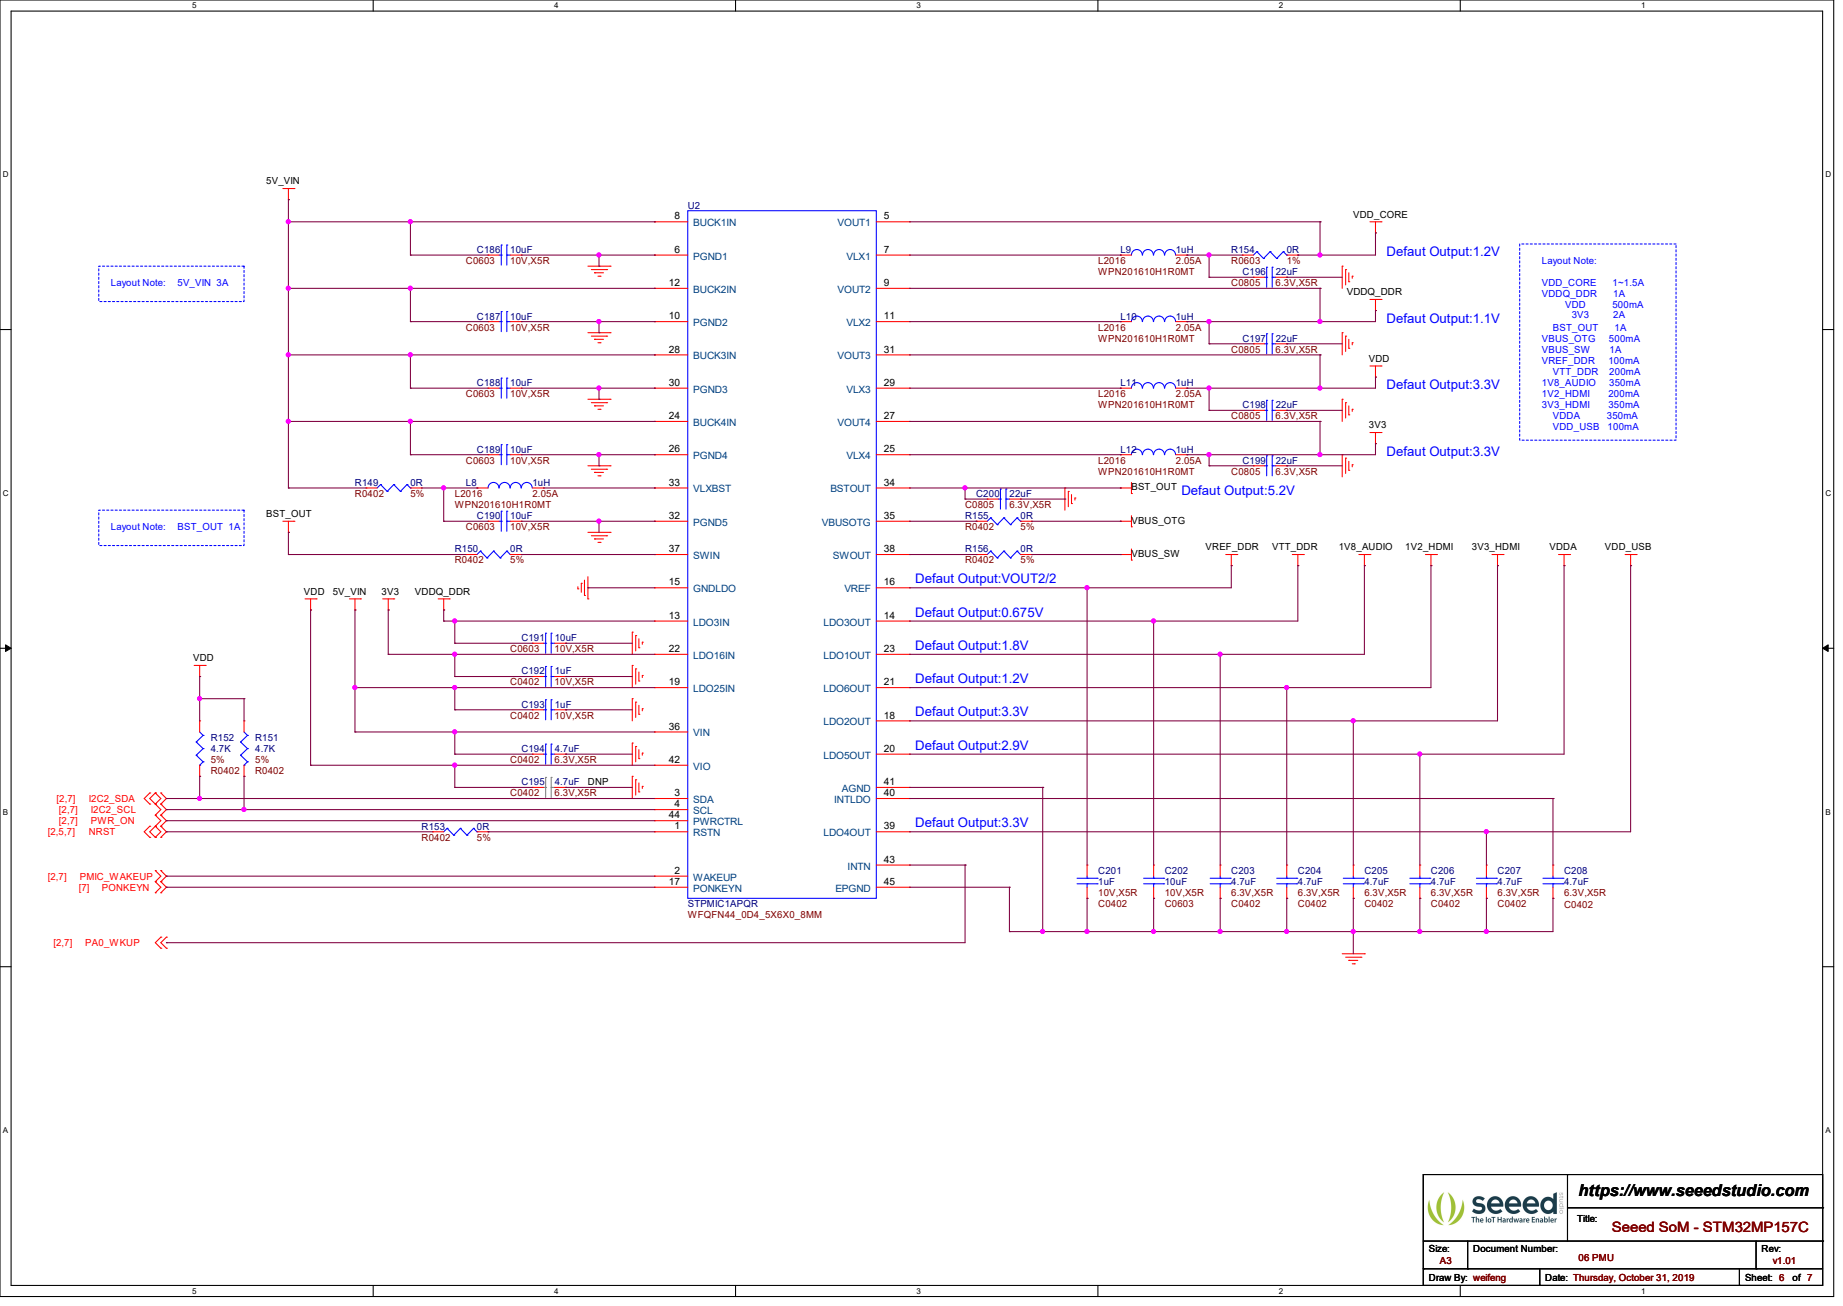
[picture p19: page 6]

VOUT1 5 VLX1 7 VOUT2 9 VLX2 11 VOUT3 31 VLX3 29 VOUT4 27 VLX4 25 BSTOUT 34 VBUSOTG 35 SWOUT 38 VREF 16

# I2C4_SCL DAC1_OUT2

# OTG_FS_ID QSPI_CLK

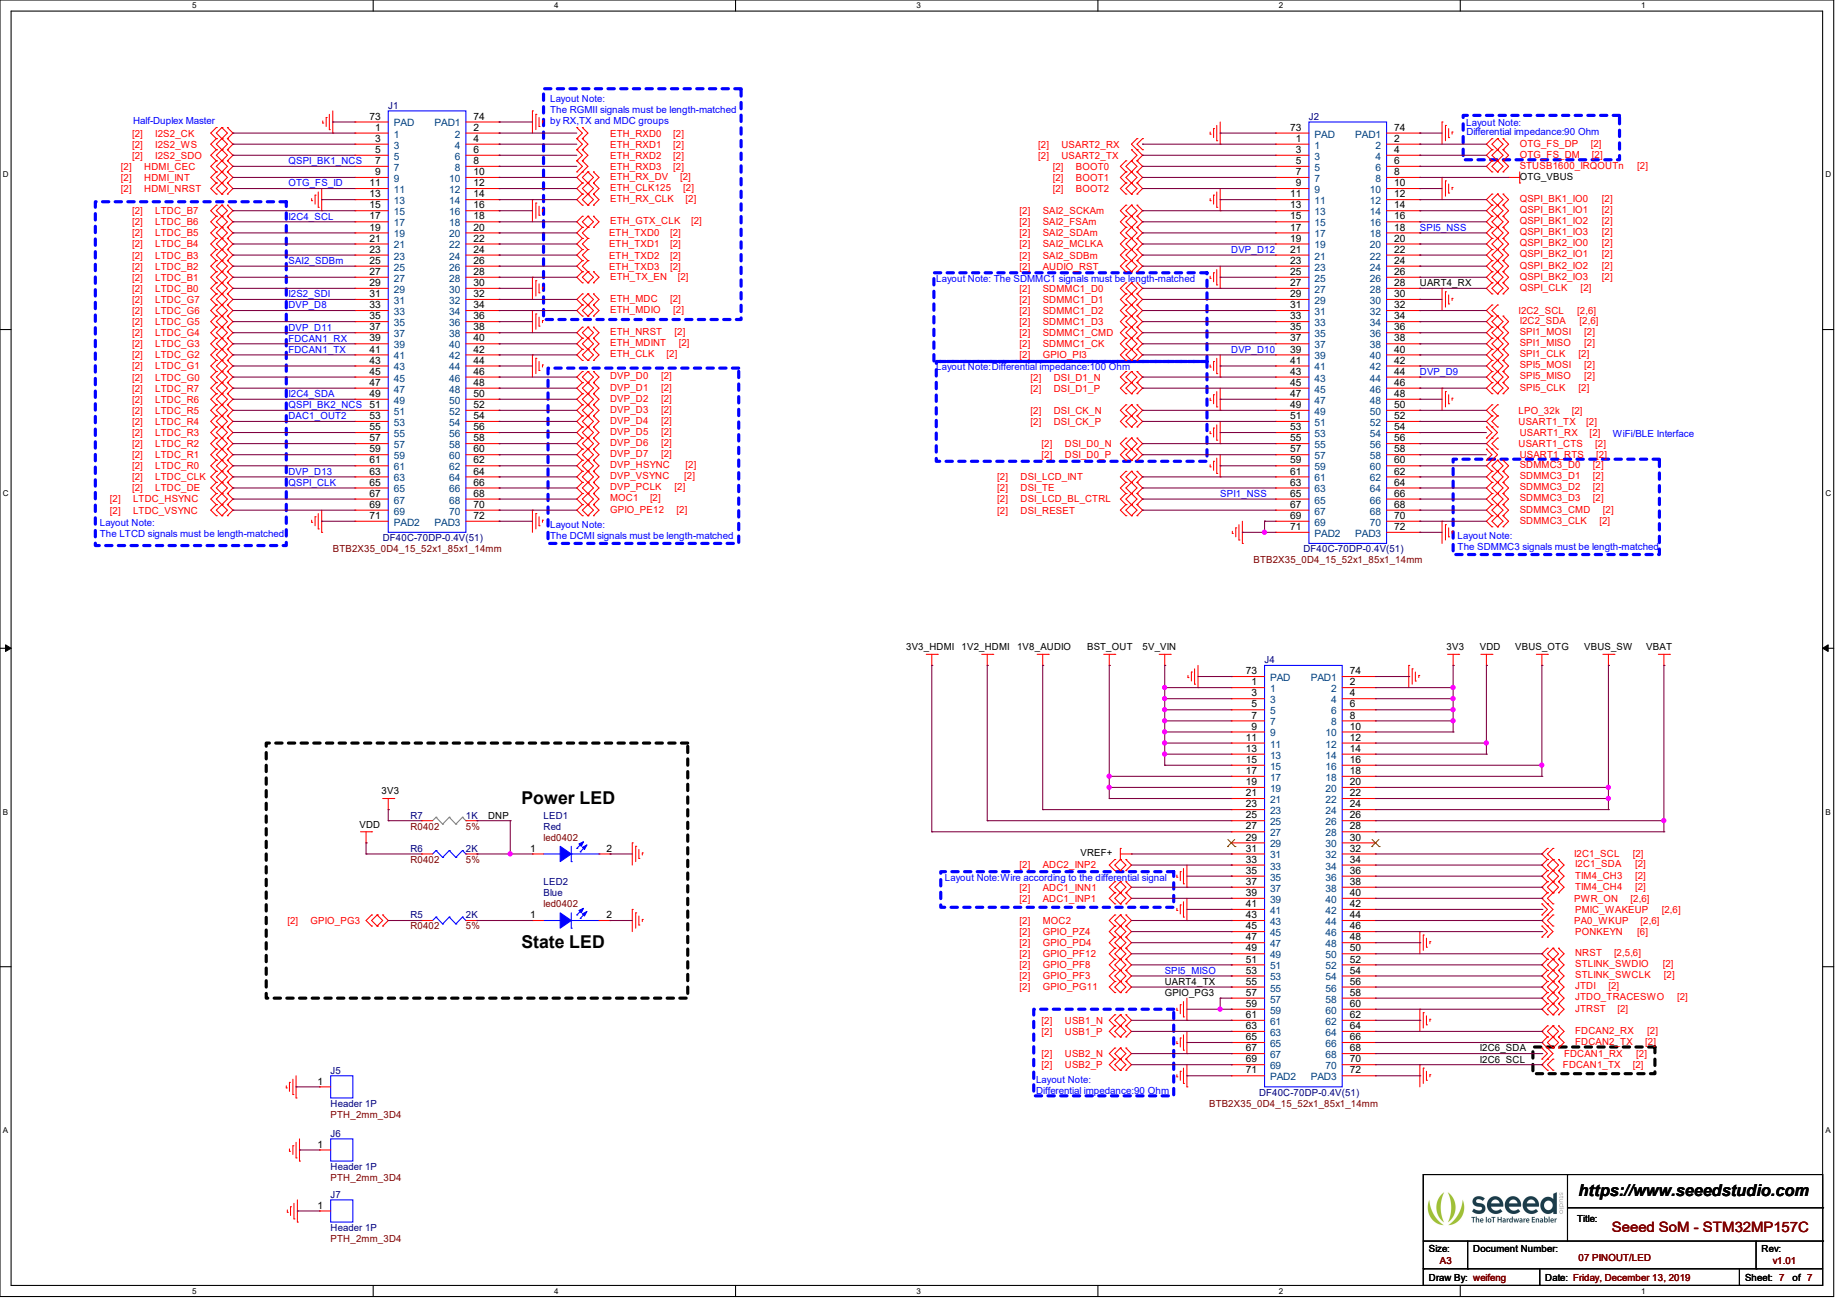
[picture p20: page 7]

Layout Note:
The RGMII signals must be length-matched
by RX,TX and MDC groups
ETH_GTX_CLK [2] ETH_TXD0 [2] ETH_TXD1 [2] ETH_TXD2 [2] ETH_TXD3 [2] ETH_RX_CLK [2] ETH_RXD0 [2] ETH_RXD1 [2] ETH_RXD2 [2] ETH_RXD3 [2] ETH_MDC [2] ETH_MDIO [2] ETH_NRST [2] ETH_MDINT [2] ETH_CLK125 [2] ETH_CLK [2] ETH_TX_EN [2] ETH_RX_DV [2]

Layout Note: The SDMMC1 signals must be length-matched

The DCMI signals must be length-matched

The SDMMC3 signals must be length-matched Layout Note:

Layout Note:Wire according to the differential signalUART4_TX
