KirillYatsenko/tbd/(list of files, drawings)

Other design files:
STM32_RAM_CUBE_PCB/1DDR3L_16bits.SchDoc
STM32_RAM_CUBE_PCB/eMMC.SchDoc
STM32_RAM_CUBE_PCB/Power_MPU.SchDoc
STM32_RAM_CUBE_PCB/Power_PMIC.SchDoc
STM32_RAM_CUBE_PCB/STM32_MPU_IOs.SchDoc
STM32_RAM_CUBE_PCB/STM32MP15XXAB_1DDR3Lx16-Project.SchDoc
STM32_RAM_CUBE_PCB/STM32MP15XXAB_1DDR3Lx16-Top.SchDoc
STM32_RAM_CUBE_PCB/STM32MP15XXAB_1DDR3Lx16.PrjPcb
STM32DEV BOARD_DK2/AUDIO.SchDoc
STM32DEV BOARD_DK2/DDR3_16bits.SchDoc
STM32DEV BOARD_DK2/DSI_LCD.SchDoc
STM32DEV BOARD_DK2/Ethernet.SchDoc
STM32DEV BOARD_DK2/GPIO_&_Arduino_ Connectors.SchDoc
STM32DEV BOARD_DK2/HDMI.SchDoc
STM32DEV BOARD_DK2/MB1272.PrjPcb
STM32DEV BOARD_DK2/MPU_12x12.SchDoc
STM32DEV BOARD_DK2/Peripherals.SchDoc
STM32DEV BOARD_DK2/Power_MPU.SchDoc
STM32DEV BOARD_DK2/Power_PMIC.SchDoc
STM32DEV BOARD_DK2/Project_Overview.SchDoc
STM32DEV BOARD_DK2/ST_LINK_V2-1.SCHDOC
STM32DEV BOARD_DK2/Top.SchDoc
STM32DEV BOARD_DK2/USB_Host_Hub&TypeC_DRP.SchDoc
STM32DEV BOARD_DK2/WLAN_BLUETOOTH.SchDoc
