KirillYatsenko/tbd/LCD_Adapter/LCD_Adapter/LCD_Adapter.kicad_pcb

## KiCad design LCD_Adapter/LCD_Adapter/LCD_Adapter.kicad_pcb (2025-06-14)

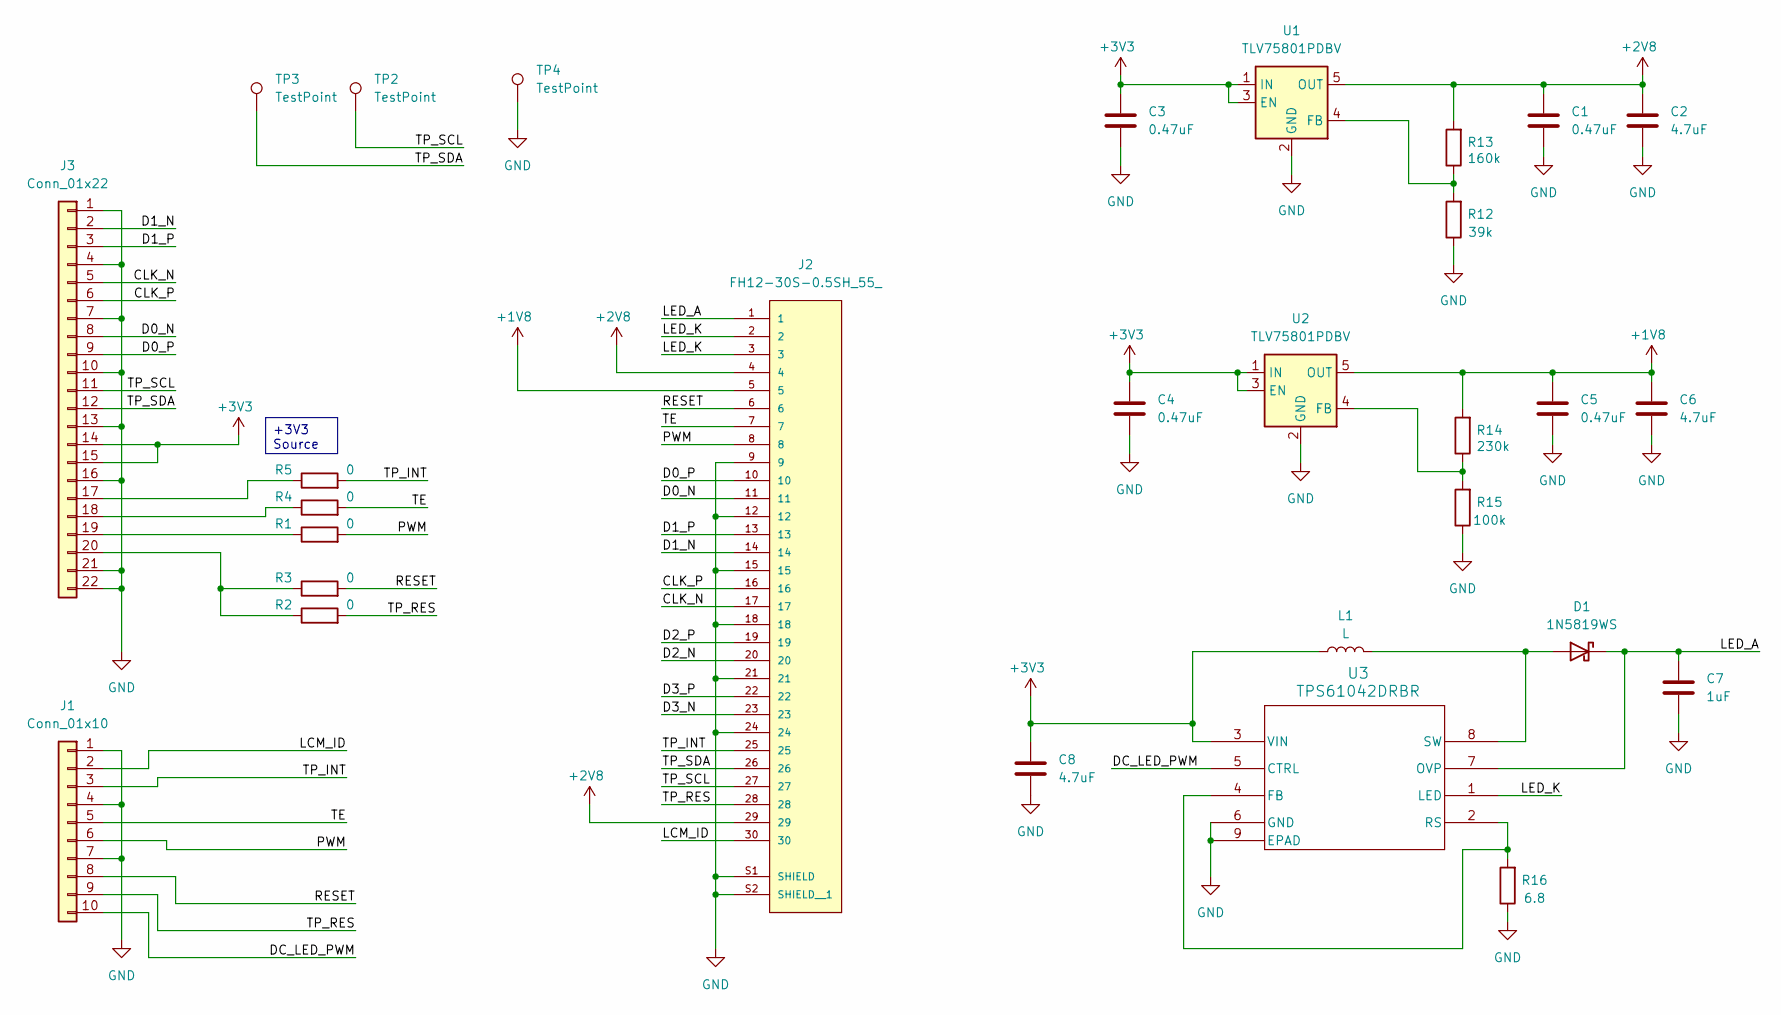
[picture p21: schematic LCD_Adapter.kicad_sch]

Parts:
C1, C3, C4, C5: 0.47uF; C_0603_1608Metric
C2, C6, C8: 4.7uF; C_0603_1608Metric
C7: 1uF; C_0603_1608Metric
D1: 1N5819WS; D_SOD-323
J1: Conn_01x10; PinHeader_1x10_P2.54mm_Vertical
J2: FH12-30S-0.5SH_55_; HIROSE_FH12-30S-0.5SH_55_
J3: Conn_01x22; FC-10A20P11H20; LCSC # C23397376
L1: L; L_1210_3225Metric; LCSC # C703083
R1, R2, R3, R4, R5: 0; R_0603_1608Metric
R12: 39k; R_0603_1608Metric
R13: 160k; R_0603_1608Metric
R14: 230k; R_0603_1608Metric
R15: 100k; R_0603_1608Metric
R16: 6.8; R_0603_1608Metric
TP2, TP3, TP4: TestPoint; TestPoint_Pad_D1.0mm
U1, U2: TLV75801PDBV; SOT-23-5
U3: TPS61042DRBR; DRB8_1P75X1P5

Connections:
+1V8: C5.1, C6.1, J2.5, R14.2, U2.5 (OUT)
+2V8: C1.1, C2.1, J2.4, J2.29, R13.2, U1.5 (OUT)
+3V3: C3.1, C4.1, C8.1, J3.14, J3.15, L1.1, U1.1 (IN), U1.3 (EN), U2.1 (IN), U2.3 (EN), U3.3 (VIN)
/ LED_A: C7.1, D1.1 (K), J2.1, U3.7 (OVP)
/ LED_K: J2.2, J2.3, U3.1 (LED)
/CLK_N: J2.17, J3.5
/CLK_P: J2.16, J3.6
/D0_N: J2.11, J3.8
/D0_P: J2.10, J3.9
/D1_N: J2.14, J3.2
/D1_P: J2.13, J3.3
/D2_N: J2.20
/D2_P: J2.19
/D3_N: J2.23
/D3_P: J2.22
/DC_LED_PWM: J1.10, U3.5 (CTRL)
/LCM_ID: J1.2, J2.30
/PWM: J1.6, J2.8, R1.2
/RESET: J1.8, J2.6, R3.2
/TE: J1.5, J2.7, R4.2
/TP_INT: J1.3, J2.25, R5.2
/TP_RES: J1.9, J2.28, R2.2
/TP_SCL: J2.27, J3.11, TP2.1
/TP_SDA: J2.26, J3.12, TP3.1
GND: C1.2, C2.2, C3.2, C4.2, C5.2, C6.2, C7.2, C8.2, J1.1, J1.4, J1.7, J2.9, J2.12, J2.15, J2.18, J2.21, J2.24, J2.S1 (SHIELD), J2.S2 (SHIELD__1), J3.1, J3.4, J3.7, J3.10, J3.13, J3.16, J3.21, J3.22, R12.1, R15.1, R16.1, TP4.1, U1.2 (GND), U2.2 (GND), U3.6 (GND), U3.9 (EPAD)
unnamed: D1.2 (A), L1.2, U3.8 (SW)
unnamed: J3.17, R5.1
unnamed: J3.18, R4.1
unnamed: J3.19, R1.1
unnamed: J3.20, R2.1, R3.1
unnamed: R12.2, R13.1, U1.4 (FB)
unnamed: R14.1, R15.2, U2.4 (FB)
unnamed: R16.2, U3.2 (RS), U3.4 (FB)

Notes on the sheet:
+3V3 Source

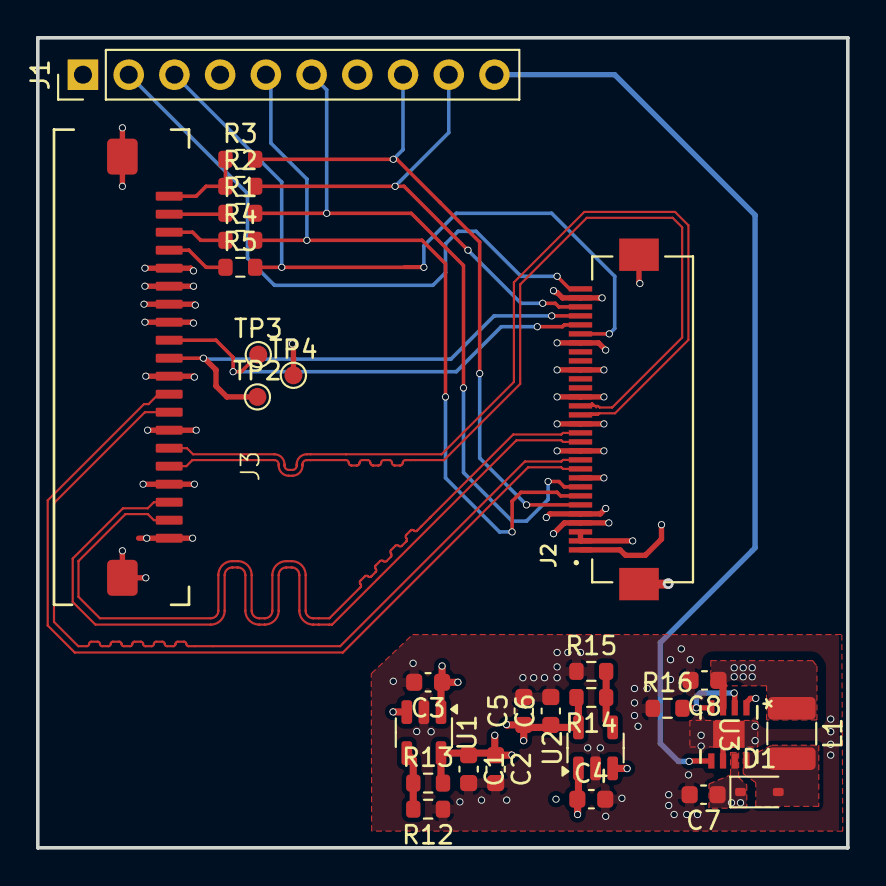
[picture p22: board LCD_Adapter.kicad_pcb from above]

Board: 4 copper layers, 45.0 x 45.0 mm, 29 parts (0 on the bottom side), 29 nets.
