KirillYatsenko/tbd/PCB/MPU_MOD.kicad_pcb

## KiCad design PCB/MPU_MOD.kicad_pcb (2025-06-10)

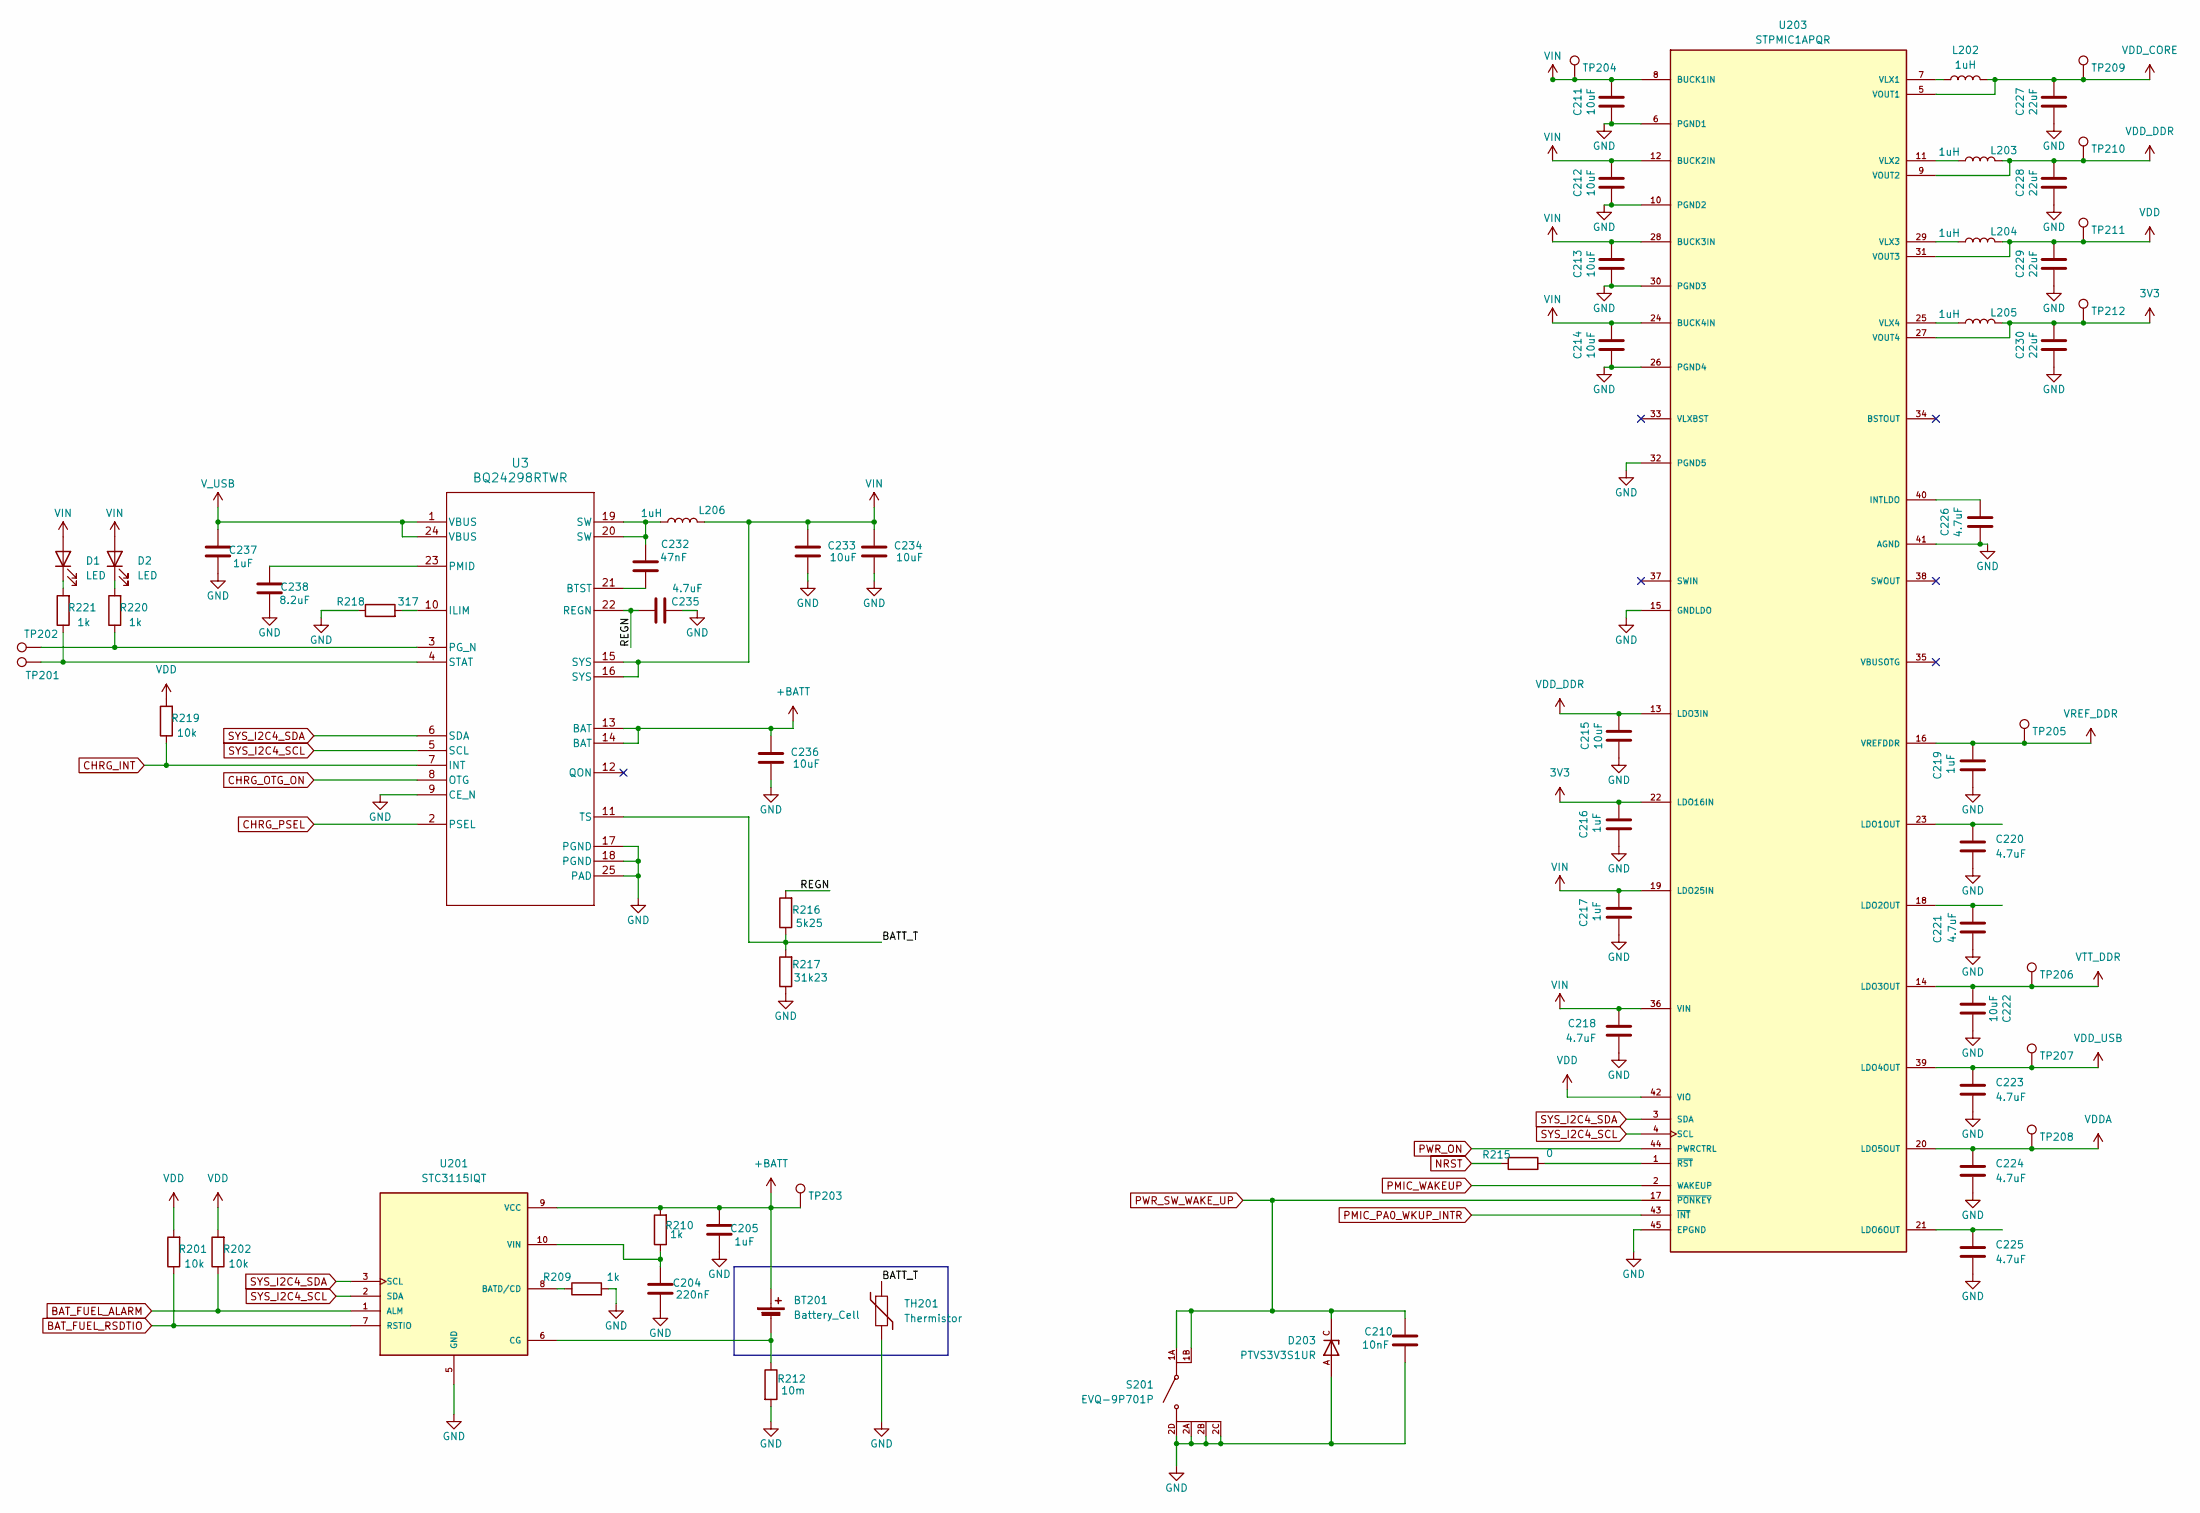
[picture p23: schematic PWR.kicad_sch]

Parts:
BT201: Battery_Cell; PinHeader_1x02_P1.00mm_Vertical
C204: 220nF; C_0402_1005Metric
C205, C216, C217, C219, C237: 1uF; C_0402_1005Metric; Mouser P/N 81-GRM155R61E105KA2D
C210: 10nF; C_0402_1005Metric; Mouser P/N 81-GRM155R71C103KA1J
C211, C212, C213, C214, C215, C222, C233, C234, C236: 10uF; C_0603_1608Metric; Mouser P/N 81-GRT188R61A106KE3D
C218, C220, C221, C223, C224, C225, C226, C235: 4.7uF; C_0402_1005Metric; Mouser P/N 81-GRM155R60J475ME7J
C227, C228, C229, C230: 22uF; C_0603_1608Metric; Mouser P/N 81-GRM188R60J226ME0J
C232: 47nF; C_0402_1005Metric
C238: 8.2uF; C_0402_1005Metric
D1, D2: LED; LED_0402_1005Metric
D203: PTVS3V3S1UR; TVS_PTVS3V3S1UR; PARTREV Rev. 3
L202, L203, L204, L205, L206: 1uH; L_1008_2520Metric; Mouser P/N 81-DFE252012P-1R0MP2
R201, R202, R219: 10k; R_0402_1005Metric; Mouser P/N 667-ERJ-3LWFR010V
R209, R210: 1k; R_0402_1005Metric; Mouser P/N 667-ERJ-3LWFR010V
R212: 10m; R_0603_1608Metric; Mouser P/N 667-ERJ-3LWFR010V
R215: 0; R_0402_1005Metric
R216: 5k25; R_0402_1005Metric
R217: 31k23; R_0402_1005Metric
R218: 317; R_0402_1005Metric
R220, R221: 1k; R_0402_1005Metric
S201: EVQ-9P701P; SW_EVQ-9P701P; PARTREV N/A
TH201: Thermistor; PinHeader_1x02_P1.00mm_Vertical
TP201, TP202, TP203, TP204, TP205, TP206, TP207, TP208, TP209, TP210, TP211, TP212: TestPoint; TP_0.5mm
U3: BQ24298RTWR; RTW0024H
U201: STC3115IQT; SON50P300X200X60-10N; PARTREV 9
U203: STPMIC1APQR; QFN40P600X500X80-45N; Mouser P/N 511-STPMIC1APQR

Connections:
3V3: C216.2, C230.2, L205.2, TP212.1, U203.22 (LDO16IN), U203.27 (VOUT4); also elsewhere on the board
+BATT: BT201.1 (+), C205.2, C236.2, R210.2, TP203.1, U3.13 (BAT), U3.14 (BAT), U201.9 (VCC)
/PWR/BATT_T: R216.1, R217.2, TH201.1, U3.11 (TS)
/PWR/REGN: C235.2, R216.2, U3.22 (REGN)
BAT_FUEL_ALARM: R202.1, U201.1 (ALM)
BAT_FUEL_RSDTIO: R201.1, U201.7 (RSTIO)
CHRG_INT: R219.1, U3.7 (INT)
CHRG_OTG_ON: U3.8 (OTG)
CHRG_PSEL: U3.2 (PSEL)
GND: C204.2, C205.1, C210.1, C211.1, C212.1, C213.1, C214.1, C215.1, C216.1, C217.1, C218.1, C219.1, C220.1, C221.1, C222.2, C223.1, C224.1, C225.1, C226.1, C227.1, C228.1, C229.1, C230.1, C233.1, C234.1, C235.1, C236.1, C237.1, C238.1, D203.A, R209.2, R212.2, R217.1, R218.1, S201.2A, S201.2B, S201.2C, S201.2D, TH201.2, U3.9 (CE_N), U3.17 (PGND), U3.18 (PGND), U3.25 (PAD), U201.5 (GND), U203.6 (PGND1), U203.10 (PGND2), U203.15 (GNDLDO), U203.26 (PGND4), U203.30 (PGND3), U203.32 (PGND5), U203.41 (AGND), U203.45 (EPGND); also elsewhere on the board
NRST: R215.2; also elsewhere on the board
unnamed: BT201.2 (-), R212.1, U201.6 (CG)
unnamed: C232.1, L206.1, U3.19 (SW), U3.20 (SW)
unnamed: D1.1 (K), R221.2
unnamed: D2.1 (K), R220.2
unnamed: C232.2, U3.21 (BTST)
unnamed: R218.2, U3.10 (ILIM)
unnamed: R220.1, TP202.1, U3.3 (PG_N)
unnamed: C238.2, U3.23 (PMID)
unnamed: R221.1, TP201.1, U3.4 (STAT)
unnamed: R209.1, U201.8 (BATD/CD)
unnamed: C204.1, R210.1, U201.10 (VIN)
unnamed: C226.2, U203.40 (INTLDO)
unnamed: C220.2, U203.23 (LDO1OUT)
unnamed: C221.2, U203.18 (LDO2OUT)
unnamed: C225.2, U203.21 (LDO6OUT)
unnamed: L202.1, U203.7 (VLX1)
unnamed: L203.1, U203.11 (VLX2)
unnamed: L204.1, U203.29 (VLX3)
unnamed: L205.1, U203.25 (VLX4)
unnamed: R215.1, U203.1 (~RST)
PMIC_PA0_WKUP_INTR: U203.43 (~INT); also elsewhere on the board
PMIC_WAKEUP: U203.2 (WAKEUP)
PWR_ON: U203.44 (PWRCTRL); also elsewhere on the board
PWR_SW_WAKE_UP: C210.2, D203.C, S201.1A, S201.1B, U203.17 (~PONKEY); also elsewhere on the board
SYS_I2C4_SCL: U3.5 (SCL), U201.2 (SDA), U203.4 (SCL); also elsewhere on the board
SYS_I2C4_SDA: U3.6 (SDA), U201.3 (SCL), U203.3 (SDA); also elsewhere on the board
VDD: C229.2, L204.2, R201.2, R202.2, R219.2, TP211.1, U203.31 (VOUT3), U203.42 (VIO); also elsewhere on the board
VDDA: C224.2, TP208.1, U203.20 (LDO5OUT)
VDD_CORE: C227.2, L202.2, TP209.1, U203.5 (VOUT1); also elsewhere on the board
VDD_DDR: C215.2, C228.2, L203.2, TP210.1, U203.9 (VOUT2), U203.13 (LDO3IN); also elsewhere on the board
VDD_USB: C223.2, TP207.1, U203.39 (LDO4OUT); also elsewhere on the board
VIN: C211.2, C212.2, C213.2, C214.2, C217.2, C218.2, C233.2, C234.2, D1.2 (A), D2.2 (A), L206.2, TP204.1, U3.15 (SYS), U3.16 (SYS), U203.8 (BUCK1IN), U203.12 (BUCK2IN), U203.19 (LDO25IN), U203.24 (BUCK4IN), U203.28 (BUCK3IN), U203.36 (VIN)
VREF_DDR: C219.2, TP205.1, U203.16 (VREFDDR); also elsewhere on the board
VTT_DDR: C222.1, TP206.1, U203.14 (LDO3OUT); also elsewhere on the board
V_USB: C237.2, U3.1 (VBUS), U3.24 (VBUS); also elsewhere on the board

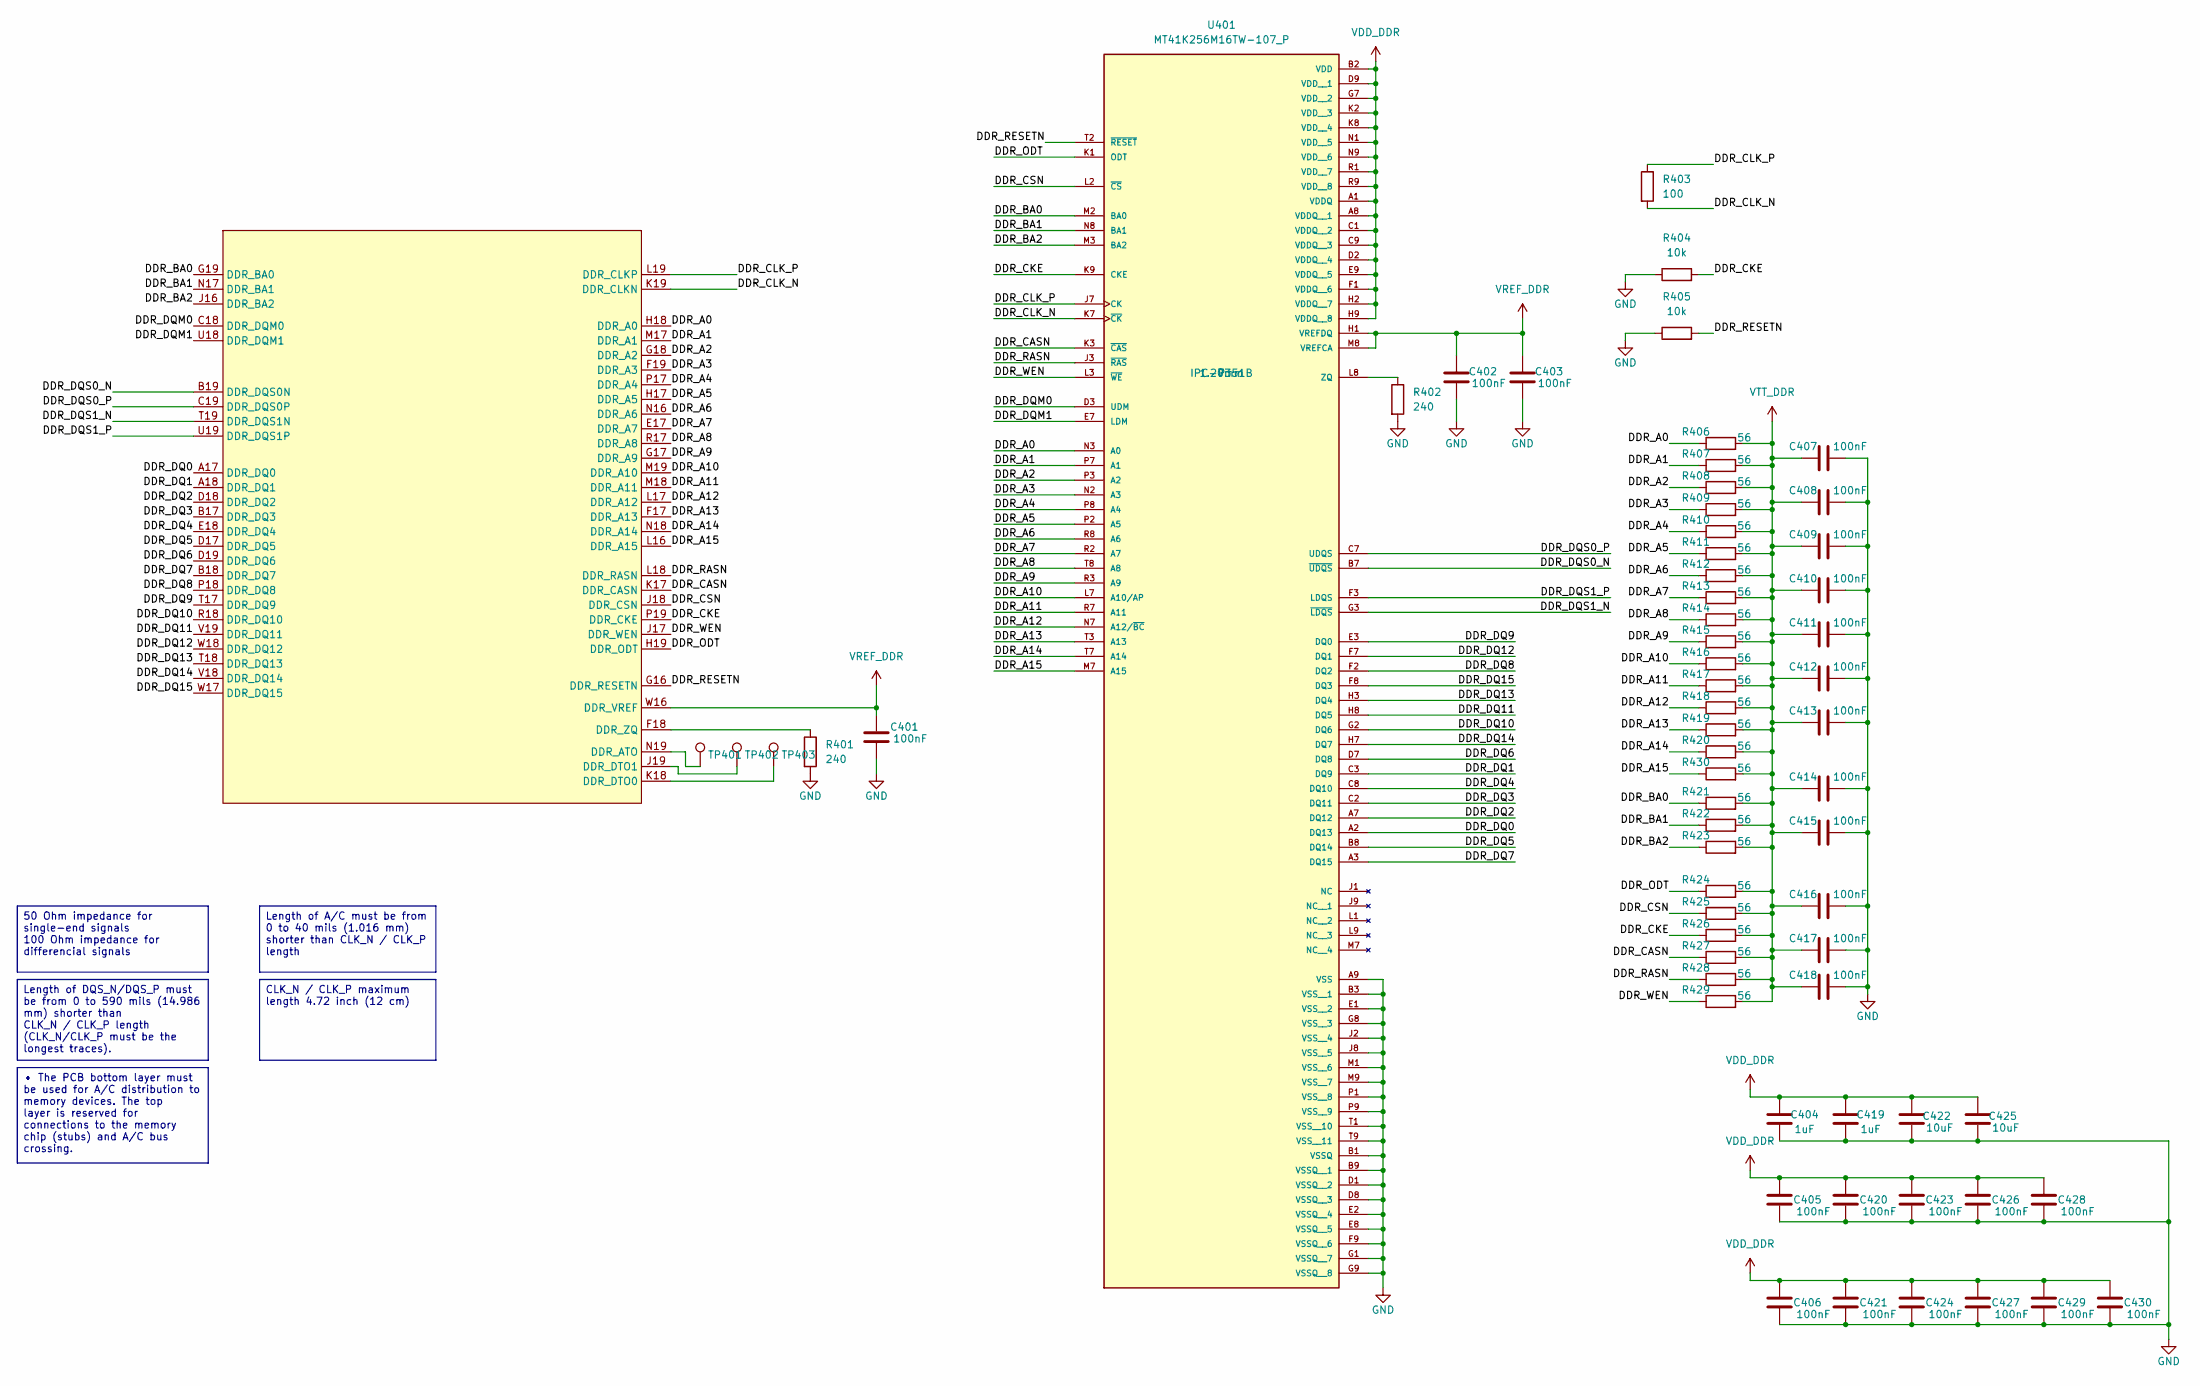
[picture p24: schematic DDR.kicad_sch]

Parts:
C401, C402, C403, C405, C406, C407, C408, C409, C410, C411, C412, C413, C414, C415, C416, C417, C418, C420, C421, C423, C424, C426, C427, C428, C429, C430: 100nF; C_0402_1005Metric; Mouser P/N 81-GRM155R61E104KA7J
C404, C419: 1uF; C_0402_1005Metric; Mouser P/N 81-GRM155R61E105KA2D
C422, C425: 10uF; C_0603_1608Metric; Mouser P/N 81-GRT188R61A106KE3D
R401, R402: 240; R_0402_1005Metric
R403: 100; R_0402_1005Metric
R404, R405: 10k; R_0402_1005Metric
R406, R407, R408, R409, R410, R411, R412, R413, R414, R415, R416, R417, R418, R419, R420, R421, R422, R423, R424, R425, R426, R427, R428, R429, R430: 56; R_0402_1005Metric
TP401, TP402, TP403: TestPoint; TP_0.5mm
U301: STM32MP157FABx; ST_LFBGA-354_16x16mm_Layout19x19_P0.8mm
U401: MT41K256M16TW-107_P; BGA96C80P9X16_1400X800X120; Mouser P/N 340-265846-TRAY

Connections:
/DDR/DDR_A0: R406.1, U301.H18 (DDR_A0), U401.N3 (A0)
/DDR/DDR_A1: R407.1, U301.M17 (DDR_A1), U401.P7 (A1)
/DDR/DDR_A2: R408.1, U301.G18 (DDR_A2), U401.P3 (A2)
/DDR/DDR_A3: R409.1, U301.F19 (DDR_A3), U401.N2 (A3)
/DDR/DDR_A4: R410.1, U301.P17 (DDR_A4), U401.P8 (A4)
/DDR/DDR_A5: R411.1, U301.H17 (DDR_A5), U401.P2 (A5)
/DDR/DDR_A6: R412.1, U301.N16 (DDR_A6), U401.R8 (A6)
/DDR/DDR_A7: R413.1, U301.E17 (DDR_A7), U401.R2 (A7)
/DDR/DDR_A8: R414.1, U301.R17 (DDR_A8), U401.T8 (A8)
/DDR/DDR_A9: R415.1, U301.G17 (DDR_A9), U401.R3 (A9)
/DDR/DDR_A10: R416.1, U301.M19 (DDR_A10), U401.L7 (A10/AP)
/DDR/DDR_A11: R417.1, U301.M18 (DDR_A11), U401.R7 (A11)
/DDR/DDR_A12: R418.1, U301.L17 (DDR_A12), U401.N7 (A12/~BC)
/DDR/DDR_A13: R419.1, U301.F17 (DDR_A13), U401.T3 (A13)
/DDR/DDR_A14: R420.1, U301.N18 (DDR_A14), U401.T7 (A14)
/DDR/DDR_A15: R430.1, U301.L16 (DDR_A15), U401.M7 (A15)
/DDR/DDR_BA0: R421.1, U301.G19 (DDR_BA0), U401.M2 (BA0)
/DDR/DDR_BA1: R422.1, U301.N17 (DDR_BA1), U401.N8 (BA1)
/DDR/DDR_BA2: R423.1, U301.J16 (DDR_BA2), U401.M3 (BA2)
/DDR/DDR_CASN: R427.1, U301.K17 (DDR_CASN), U401.K3 (~CAS)
/DDR/DDR_CKE: R404.2, R426.1, U301.P19 (DDR_CKE), U401.K9 (CKE)
/DDR/DDR_CLK_N: R403.2, U301.K19 (DDR_CLKN), U401.K7 (~CK)
/DDR/DDR_CLK_P: R403.1, U301.L19 (DDR_CLKP), U401.J7 (CK)
/DDR/DDR_CSN: R425.1, U301.J18 (DDR_CSN), U401.L2 (~CS)
/DDR/DDR_DQ0: U301.A17 (DDR_DQ0), U401.A2 (DQ13)
/DDR/DDR_DQ1: U301.A18 (DDR_DQ1), U401.C3 (DQ9)
/DDR/DDR_DQ2: U301.D18 (DDR_DQ2), U401.A7 (DQ12)
/DDR/DDR_DQ3: U301.B17 (DDR_DQ3), U401.C2 (DQ11)
/DDR/DDR_DQ4: U301.E18 (DDR_DQ4), U401.C8 (DQ10)
/DDR/DDR_DQ5: U301.D17 (DDR_DQ5), U401.B8 (DQ14)
/DDR/DDR_DQ6: U301.D19 (DDR_DQ6), U401.D7 (DQ8)
/DDR/DDR_DQ7: U301.B18 (DDR_DQ7), U401.A3 (DQ15)
/DDR/DDR_DQ8: U301.P18 (DDR_DQ8), U401.F2 (DQ2)
/DDR/DDR_DQ9: U301.T17 (DDR_DQ9), U401.E3 (DQ0)
/DDR/DDR_DQ10: U301.R18 (DDR_DQ10), U401.G2 (DQ6)
/DDR/DDR_DQ11: U301.V19 (DDR_DQ11), U401.H8 (DQ5)
/DDR/DDR_DQ12: U301.W18 (DDR_DQ12), U401.F7 (DQ1)
/DDR/DDR_DQ13: U301.T18 (DDR_DQ13), U401.H3 (DQ4)
/DDR/DDR_DQ14: U301.V18 (DDR_DQ14), U401.H7 (DQ7)
/DDR/DDR_DQ15: U301.W17 (DDR_DQ15), U401.F8 (DQ3)
/DDR/DDR_DQM0: U301.C18 (DDR_DQM0), U401.D3 (UDM)
/DDR/DDR_DQM1: U301.U18 (DDR_DQM1), U401.E7 (LDM)
/DDR/DDR_DQS0_N: U301.B19 (DDR_DQS0N), U401.B7 (~UDQS)
/DDR/DDR_DQS0_P: U301.C19 (DDR_DQS0P), U401.C7 (UDQS)
/DDR/DDR_DQS1_N: U301.T19 (DDR_DQS1N), U401.G3 (~LDQS)
/DDR/DDR_DQS1_P: U301.U19 (DDR_DQS1P), U401.F3 (LDQS)
/DDR/DDR_ODT: R424.1, U301.H19 (DDR_ODT), U401.K1 (ODT)
/DDR/DDR_RASN: R428.1, U301.L18 (DDR_RASN), U401.J3 (~RAS)
/DDR/DDR_RESETN: R405.2, U301.G16 (DDR_RESETN), U401.T2 (~RESET)
/DDR/DDR_WEN: R429.1, U301.J17 (DDR_WEN), U401.L3 (~WE)
GND: C401.1, C402.2, C403.2, C404.2, C405.1, C406.1, C407.2, C408.2, C409.2, C410.2, C411.2, C412.2, C413.2, C414.2, C415.2, C416.2, C417.2, C418.2, C419.2, C420.1, C421.1, C422.1, C423.1, C424.1, C425.1, C426.1, C427.1, C428.1, C429.1, C430.1, R401.2, R402.2, R404.1, R405.1, U401.A9 (VSS), U401.B1 (VSSQ), U401.B3 (VSS__1), U401.B9 (VSSQ__1), U401.D1 (VSSQ__2), U401.D8 (VSSQ__3), U401.E1 (VSS__2), U401.E2 (VSSQ__4), U401.E8 (VSSQ__5), U401.F9 (VSSQ__6), U401.G1 (VSSQ__7), U401.G8 (VSS__3), U401.G9 (VSSQ__8), U401.J2 (VSS__4), U401.J8 (VSS__5), U401.M1 (VSS__6), U401.M9 (VSS__7), U401.P1 (VSS__8), U401.P9 (VSS__9), U401.T1 (VSS__10), U401.T9 (VSS__11); also elsewhere on the board
unnamed: TP401.1, U301.N19 (DDR_ATO)
unnamed: TP403.1, U301.K18 (DDR_DTO0)
unnamed: TP402.1, U301.J19 (DDR_DTO1)
unnamed: R401.1, U301.F18 (DDR_ZQ)
unnamed: R402.1, U401.L8 (ZQ)
VDD_DDR: C404.1, C405.2, C406.2, C419.1, C420.2, C421.2, C422.2, C423.2, C424.2, C425.2, C426.2, C427.2, C428.2, C429.2, C430.2, U401.A1 (VDDQ), U401.A8 (VDDQ__1), U401.B2 (VDD), U401.C1 (VDDQ__2), U401.C9 (VDDQ__3), U401.D2 (VDDQ__4), U401.D9 (VDD__1), U401.E9 (VDDQ__5), U401.F1 (VDDQ__6), U401.G7 (VDD__2), U401.H2 (VDDQ__7), U401.H9 (VDDQ__8), U401.K2 (VDD__3), U401.K8 (VDD__4), U401.N1 (VDD__5), U401.N9 (VDD__6), U401.R1 (VDD__7), U401.R9 (VDD__8); also elsewhere on the board
VREF_DDR: C401.2, C402.1, C403.1, U301.W16 (DDR_VREF), U401.H1 (VREFDQ), U401.M8 (VREFCA); also elsewhere on the board
VTT_DDR: C407.1, C408.1, C409.1, C410.1, C411.1, C412.1, C413.1, C414.1, C415.1, C416.1, C417.1, C418.1, R406.2, R407.2, R408.2, R409.2, R410.2, R411.2, R412.2, R413.2, R414.2, R415.2, R416.2, R417.2, R418.2, R419.2, R420.2, R421.2, R422.2, R423.2, R424.2, R425.2, R426.2, R427.2, R428.2, R429.2, R430.2; also elsewhere on the board

Notes on the sheet:
Length of DQS_N/DQS_P must be from 0 to 590 mils (14.986 mm) shorter than CLK_N / CLK_P length (CLK_N/CLK_P must be the longest traces).
• The PCB bottom layer must be used for A/C distribution to memory devices. The top layer is reserved for connections to the memory chip (stubs) and A/C bus crossing.
CLK_N / CLK_P maximum length 4.72 inch (12 cm)
50 Ohm impedance for single-end signals 100 Ohm impedance for differencial signals
Length of A/C must be from 0 to 40 mils (1.016 mm) shorter than CLK_N / CLK_P length

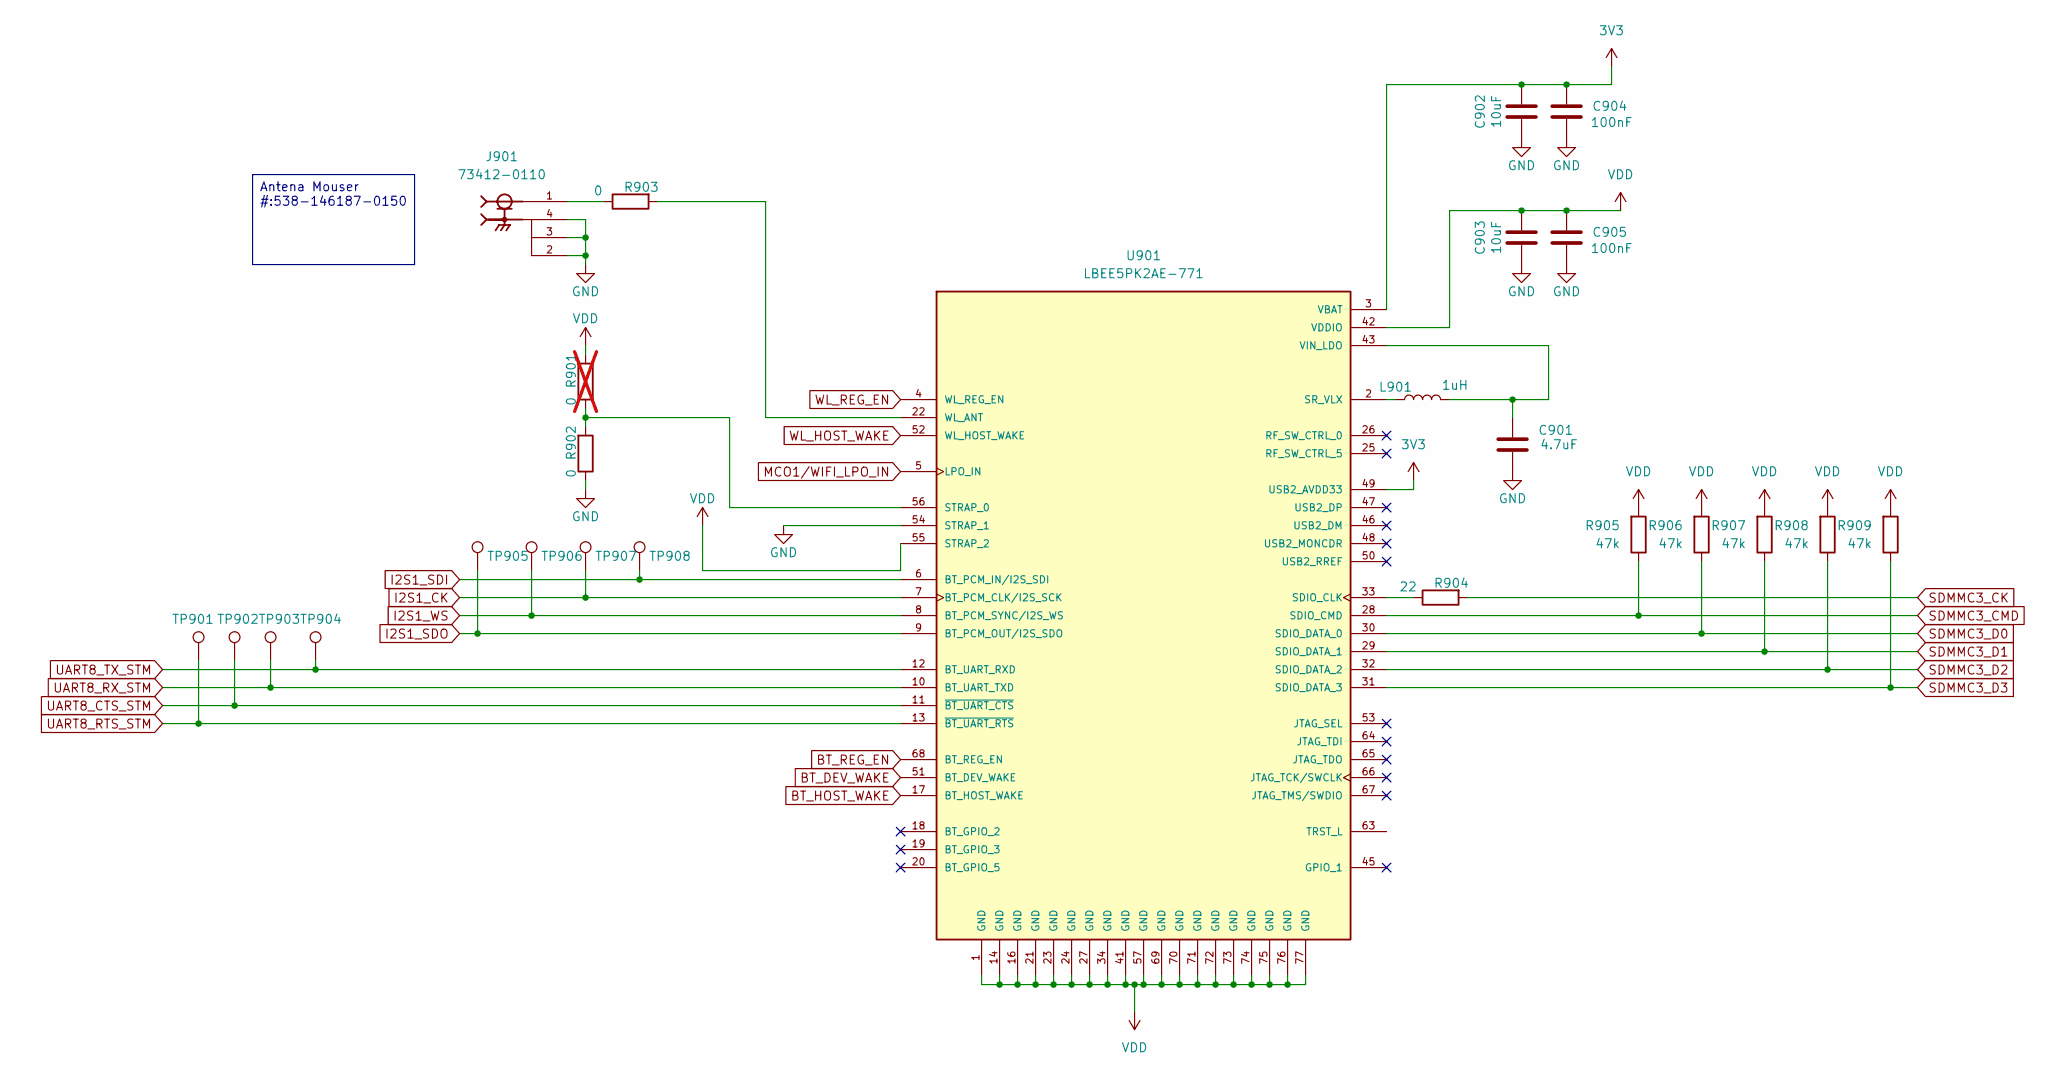
[picture p25: schematic WIFI_BLE.kicad_sch]

Parts:
C901: 4.7uF; C_0402_1005Metric; Mouser P/N 81-GRM155R60J475ME7J
C902, C903: 10uF; C_0603_1608Metric; Mouser P/N 81-GRT188R61A106KE3D
C904, C905: 100nF; C_0402_1005Metric; Mouser P/N 81-GRM155R61E104KA7J
J901: 73412-0110; MOLEX_73412-0110; PARTREV D
L901: 1uH; L_Murata_DFE201610P; Mouser P/N 81-DFE201612E-2R2MP2
R901: 0; R_0402_1005Metric; not fitted
R902, R903: 0; R_0402_1005Metric
R904: 22; R_0402_1005Metric
R905, R906, R907, R908, R909: 47k; R_0402_1005Metric
TP901, TP902, TP903, TP904, TP905, TP906, TP907, TP908: TestPoint; TP_0.5mm
U901: LBEE5PK2AE-771; XCVR_LBEE5PK2AE-771; PARTREV E

Connections:
3V3: C902.2, C904.2, U901.3 (VBAT), U901.49 (USB2_AVDD33); also elsewhere on the board
BT_DEV_WAKE: U901.51 (BT_DEV_WAKE)
BT_HOST_WAKE: U901.17 (BT_HOST_WAKE)
BT_REG_EN: U901.68 (BT_REG_EN)
GND: C901.1, C902.1, C903.1, C904.1, C905.1, J901.2, J901.3, J901.4, R902.1, U901.54 (STRAP_1); also elsewhere on the board
I2S1_CK: TP907.1, U901.7 (BT_PCM_CLK/I2S_SCK); also elsewhere on the board
I2S1_SDI: TP908.1, U901.6 (BT_PCM_IN/I2S_SDI); also elsewhere on the board
I2S1_SDO: TP905.1, U901.9 (BT_PCM_OUT/I2S_SDO); also elsewhere on the board
I2S1_WS: TP906.1, U901.8 (BT_PCM_SYNC/I2S_WS); also elsewhere on the board
MCO1/WIFI_LPO_IN: U901.5 (LPO_IN)
unnamed: J901.1, R903.1
unnamed: R904.1, U901.33 (SDIO_CLK)
unnamed: L901.1, U901.2 (SR_VLX)
unnamed: R901.1, R902.2, U901.56 (STRAP_0)
unnamed: C901.2, L901.2, U901.43 (VIN_LDO)
unnamed: R903.2, U901.22 (WL_ANT)
SDMMC3_CK: R904.2; also elsewhere on the board
SDMMC3_CMD: R905.1, U901.28 (SDIO_CMD); also elsewhere on the board
SDMMC3_D0: R906.1, U901.30 (SDIO_DATA_0); also elsewhere on the board
SDMMC3_D1: R907.1, U901.29 (SDIO_DATA_1); also elsewhere on the board
SDMMC3_D2: R908.1, U901.32 (SDIO_DATA_2); also elsewhere on the board
SDMMC3_D3: R909.1, U901.31 (SDIO_DATA_3); also elsewhere on the board
UART8_CTS_STM: TP902.1, U901.11 (~BT_UART_CTS); also elsewhere on the board
UART8_RTS_STM: TP901.1, U901.13 (~BT_UART_RTS); also elsewhere on the board
UART8_RX_STM: TP903.1, U901.10 (BT_UART_TXD); also elsewhere on the board
UART8_TX_STM: TP904.1, U901.12 (BT_UART_RXD); also elsewhere on the board
VDD: C903.2, C905.2, R901.2, R905.2, R906.2, R907.2, R908.2, R909.2, U901.1 (GND), U901.14 (GND), U901.16 (GND), U901.21 (GND), U901.23 (GND), U901.24 (GND), U901.27 (GND), U901.34 (GND), U901.41 (GND), U901.42 (VDDIO), U901.55 (STRAP_2), U901.57 (GND), U901.69 (GND), U901.70 (GND), U901.71 (GND), U901.72 (GND), U901.73 (GND), U901.74 (GND), U901.75 (GND), U901.76 (GND), U901.77 (GND); also elsewhere on the board
WL_HOST_WAKE: U901.52 (WL_HOST_WAKE)
WL_REG_EN: U901.4 (WL_REG_EN)

Notes on the sheet:
Antena Mouser #:538-146187-0150
