KirillYatsenko/tbd/PCB/MPU_MOD.kicad_pcb

## KiCad design PCB/MPU_MOD.kicad_pcb (continued)

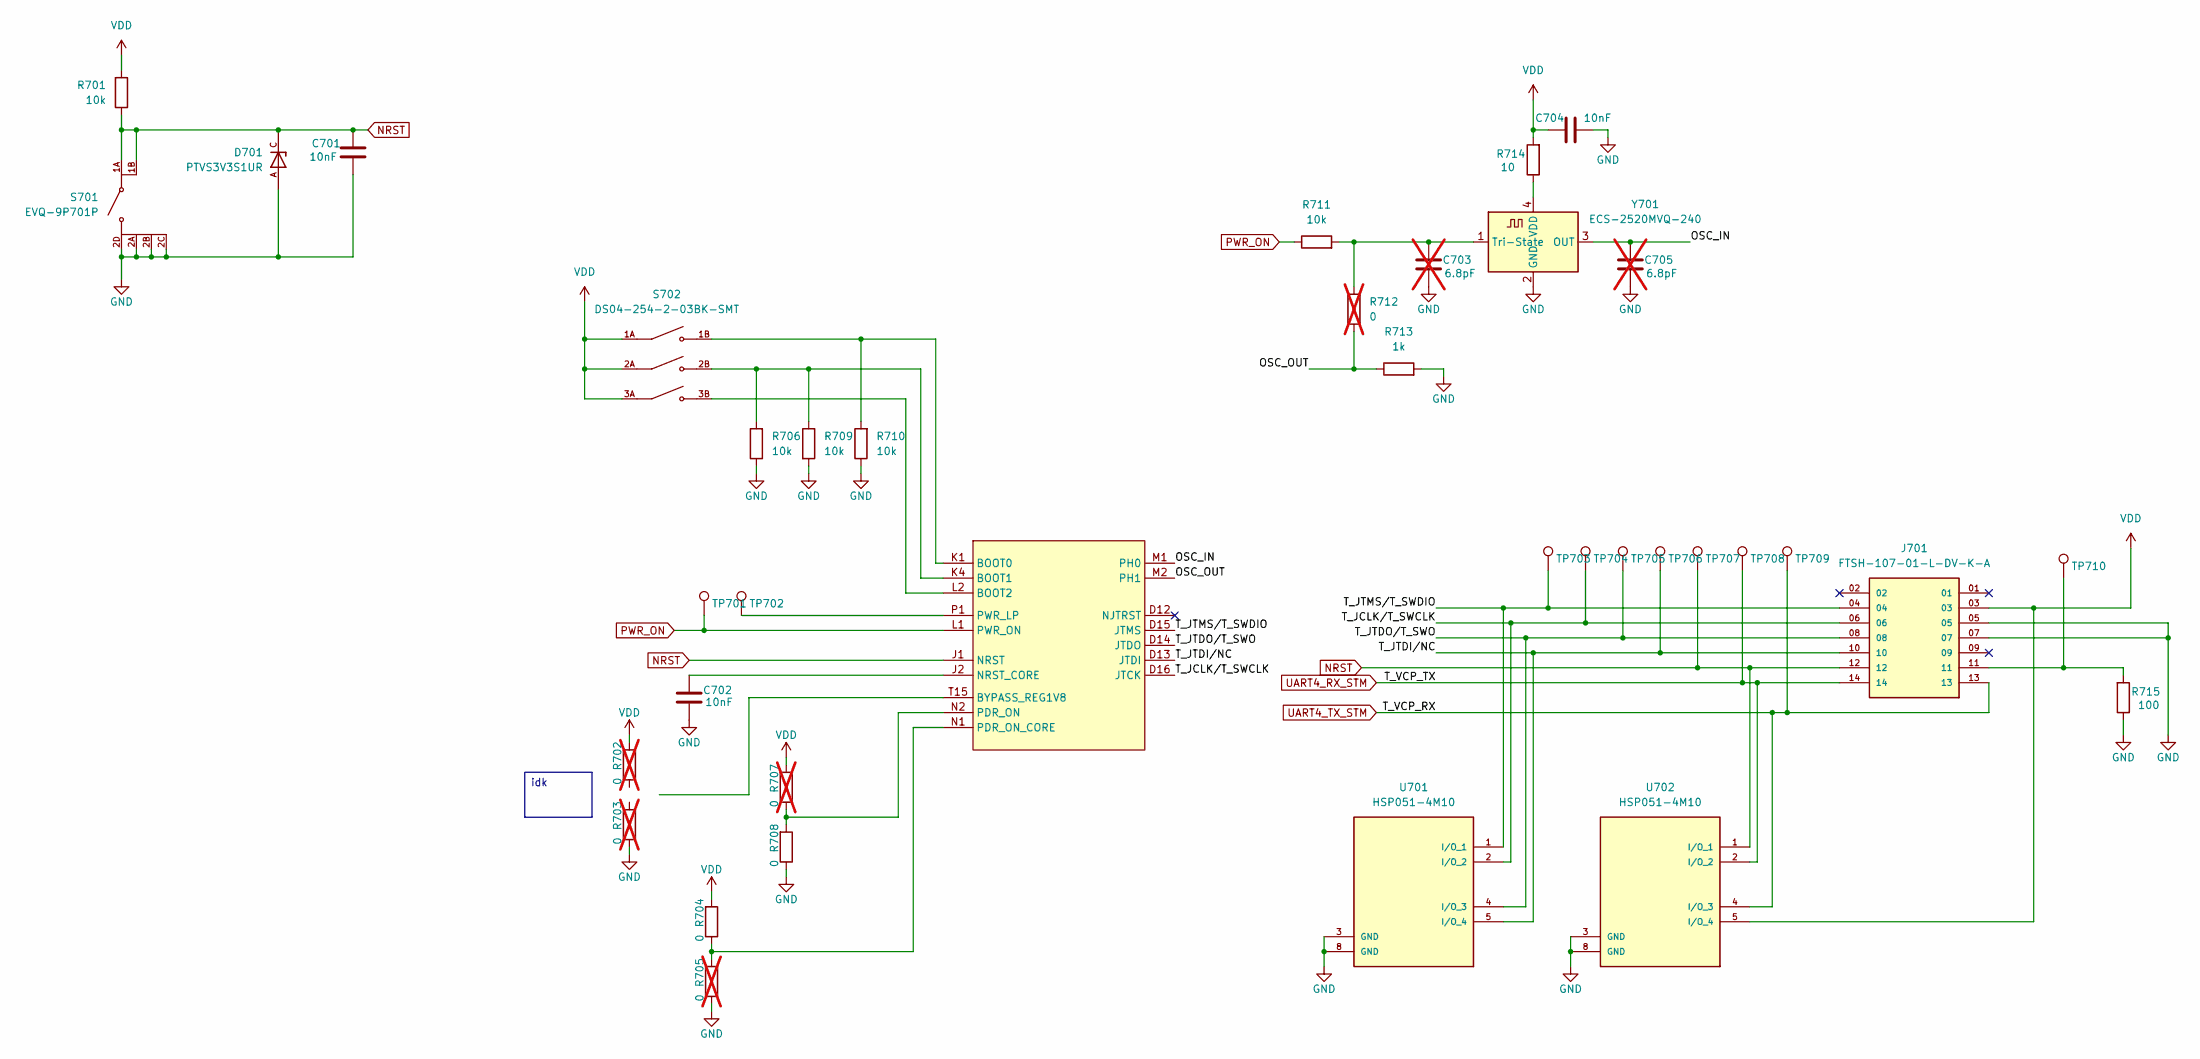
[picture p26: schematic RCC_BOOT_RST_DEBUG.kicad_sch]

Parts:
C701, C702, C704: 10nF; C_0402_1005Metric; Mouser P/N 81-GRM155R71C103KA1J
C703, C705: 6.8pF; C_0402_1005Metric; not fitted
D701: PTVS3V3S1UR; TVS_PTVS3V3S1UR; PARTREV Rev. 3
J701: FTSH-107-01-L-DV-K-A; SAMTEC_FTSH-107-01-L-DV-K-A; PARTREV H
R701, R706, R709, R710, R711: 10k; R_0402_1005Metric
R702, R703, R705, R707, R712: 0; R_0402_1005Metric; not fitted
R704, R708: 0; R_0402_1005Metric
R713: 1k; R_0402_1005Metric
R714: 10; R_0402_1005Metric
R715: 100; R_0402_1005Metric
S701: EVQ-9P701P; SW_EVQ-9P701P; PARTREV N/A
S702: DS04-254-2-03BK-SMT; SW_DS04-254-2-03BK-SMT; PARTREV V0.0
TP701, TP702, TP703, TP704, TP705, TP706, TP707, TP708, TP709, TP710: TestPoint; TP_0.5mm
U301: STM32MP157FABx; ST_LFBGA-354_16x16mm_Layout19x19_P0.8mm
U701, U702: HSP051-4M10; IC_HSP051-4M10; Mouser P/N 511-HSP051-4M10
Y701: ECS-2520MVQ-240; Oscillator_SMD_ECS_2520MV-xxx-xx-4Pin_2.5x2.0mm; Mouser P/N 520-E2520MVQ240BSTR

Connections:
/RCC_BOOT_RST_DEBUG/OSC_IN: C705.2, U301.M1 (PH0), Y701.3 (OUT)
/RCC_BOOT_RST_DEBUG/OSC_OUT: R712.1, R713.1, U301.M2 (PH1)
/RCC_BOOT_RST_DEBUG/T_JCLK/T_SWCLK: J701.06, TP704.1, U301.D16 (JTCK), U701.2 (I/O_2), U701.9 (NC)
/RCC_BOOT_RST_DEBUG/T_JTDI/NC: J701.10, TP706.1, U301.D13 (JTDI), U701.5 (I/O_4), U701.6 (NC)
/RCC_BOOT_RST_DEBUG/T_JTDO/T_SWO: J701.08, TP705.1, U301.D14 (JTDO), U701.4 (I/O_3), U701.7 (NC)
/RCC_BOOT_RST_DEBUG/T_JTMS/T_SWDIO: J701.04, TP703.1, U301.D15 (JTMS), U701.1 (I/O_1), U701.10 (NC)
GND: C701.1, C702.1, C703.1, C704.2, C705.1, D701.A, J701.05, J701.07, R703.1, R705.1, R706.1, R708.1, R709.2, R710.1, R713.2, R715.1, S701.2A, S701.2B, S701.2C, S701.2D, U701.3 (GND), U701.8 (GND), U702.3 (GND), U702.8 (GND), Y701.2 (GND); also elsewhere on the board
NRST: C701.2, D701.C, J701.12, R701.1, S701.1A, S701.1B, TP707.1, U301.J1 (NRST), U702.1 (I/O_1), U702.10 (NC); also elsewhere on the board
unnamed: J701.11, R715.2, TP710.1
unnamed: R710.2, S702.1B, U301.K1 (BOOT0)
unnamed: R706.2, R709.1, S702.2B, U301.K4 (BOOT1)
unnamed: S702.3B, U301.L2 (BOOT2)
unnamed: C702.2, U301.J2 (NRST_CORE)
unnamed: R707.1, R708.2, U301.N2 (PDR_ON)
unnamed: R704.1, R705.2, U301.N1 (PDR_ON_CORE)
unnamed: TP702.1, U301.P1 (PWR_LP)
unnamed: C703.2, R711.2, R712.2, Y701.1 (Tri-State)
unnamed: R714.1, Y701.4 (VDD)
PWR_ON: R711.1, TP701.1, U301.L1 (PWR_ON); also elsewhere on the board
UART4_RX_STM: J701.14, TP708.1, U702.2 (I/O_2), U702.9 (NC); also elsewhere on the board
UART4_TX_STM: J701.13, TP709.1, U702.4 (I/O_3), U702.7 (NC); also elsewhere on the board
VDD: C704.1, J701.03, R701.2, R702.2, R704.2, R707.2, R714.2, S702.1A, S702.2A, S702.3A, U702.5 (I/O_4), U702.6 (NC); also elsewhere on the board

Notes on the sheet:
idk

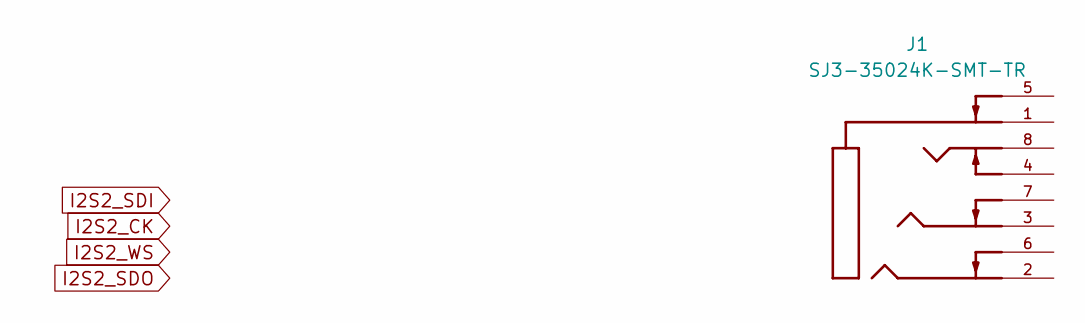
[picture p27: schematic DAC.kicad_sch]

Parts:
J1: SJ3-35024K-SMT-TR; SAMESKY_SJ3-35024K-SMT-TR; PARTREV 1.0

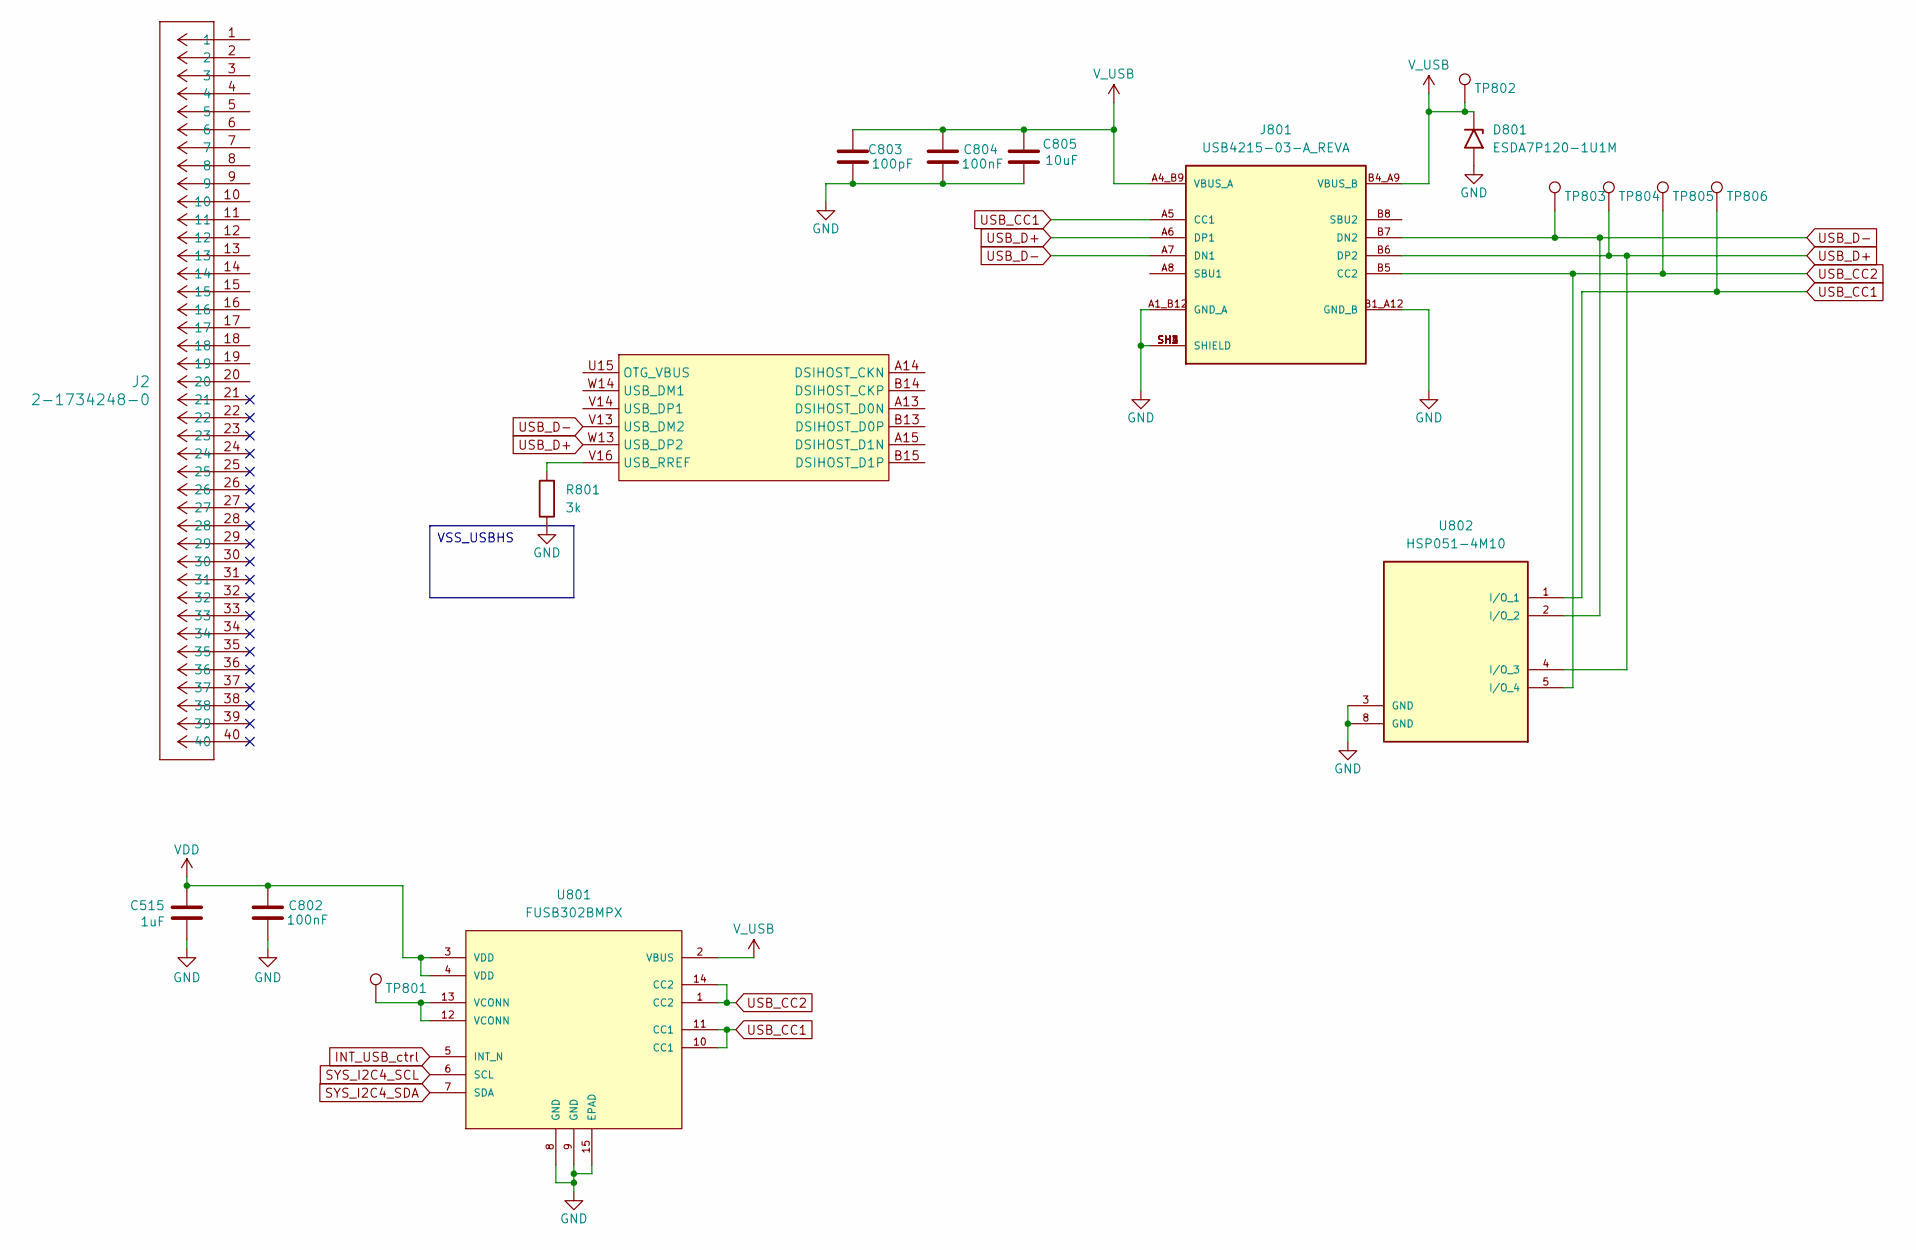
[picture p28: schematic HS_intrf.kicad_sch]

Parts:
C515: 1uF; C_0402_1005Metric; Mouser P/N 81-GRM155R61E105KA2D
C802, C804: 100nF; C_0402_1005Metric; Mouser P/N 81-GRM155R61E104KA7J
C803: 100pF; C_0402_1005Metric
C805: 10uF; C_0603_1608Metric; Mouser P/N 81-GRT188R61A106KE3D
D801: ESDA7P120-1U1M; DIODE_ESDA7P120-1U1M_STM
J2: 2-1734248-0; CONN_2-1734248-0_TYCO
J801: USB4215-03-A_REVA; GCT_USB4215-03-A_REVA; PARTREV A
R801: 3k; R_0402_1005Metric
TP801, TP802, TP803, TP804, TP805, TP806: TestPoint; TP_0.5mm
U301: STM32MP157FABx; ST_LFBGA-354_16x16mm_Layout19x19_P0.8mm
U801: FUSB302BMPX; MLP14_2P5X2P5_ONS; MANUFACTURER_PART_NUMBER FUSB302BMPX
U802: HSP051-4M10; IC_HSP051-4M10; Mouser P/N 511-HSP051-4M10

Connections:
GND: C515.2, C802.1, C803.2, C804.1, C805.1, D801.2 (A2), J801.A1_B12 (GND_A), J801.B1_A12 (GND_B), J801.SH1 (SHIELD), J801.SH2 (SHIELD), J801.SH3 (SHIELD), J801.SH4 (SHIELD), R801.1, U801.8 (GND), U801.9 (GND), U801.15 (EPAD), U802.3 (GND), U802.8 (GND); also elsewhere on the board
INT_USB_ctrl: U801.5 (INT_N)
unnamed: TP801.1, U801.12 (VCONN), U801.13 (VCONN)
unnamed: R801.2, U301.V16 (USB_RREF)
SYS_I2C4_SCL: U801.6 (SCL); also elsewhere on the board
SYS_I2C4_SDA: U801.7 (SDA); also elsewhere on the board
USB_CC1: J801.A5 (CC1), TP806.1, U801.10 (CC1), U801.11 (CC1), U802.1 (I/O_1), U802.10 (NC)
USB_CC2: J801.B5 (CC2), TP805.1, U801.1 (CC2), U801.14 (CC2), U802.5 (I/O_4), U802.6 (NC)
USB_D+: J801.A6 (DP1), J801.B6 (DP2), TP804.1, U301.W13 (USB_DP2), U802.4 (I/O_3), U802.7 (NC)
USB_D-: J801.A7 (DN1), J801.B7 (DN2), TP803.1, U301.V13 (USB_DM2), U802.2 (I/O_2), U802.9 (NC)
VDD: C515.1, C802.2, U801.3 (VDD), U801.4 (VDD); also elsewhere on the board
V_USB: C803.1, C804.2, C805.2, D801.1 (A1), J801.A4_B9 (VBUS_A), J801.B4_A9 (VBUS_B), TP802.1, U801.2 (VBUS); also elsewhere on the board

Notes on the sheet:
VSS_USBHS

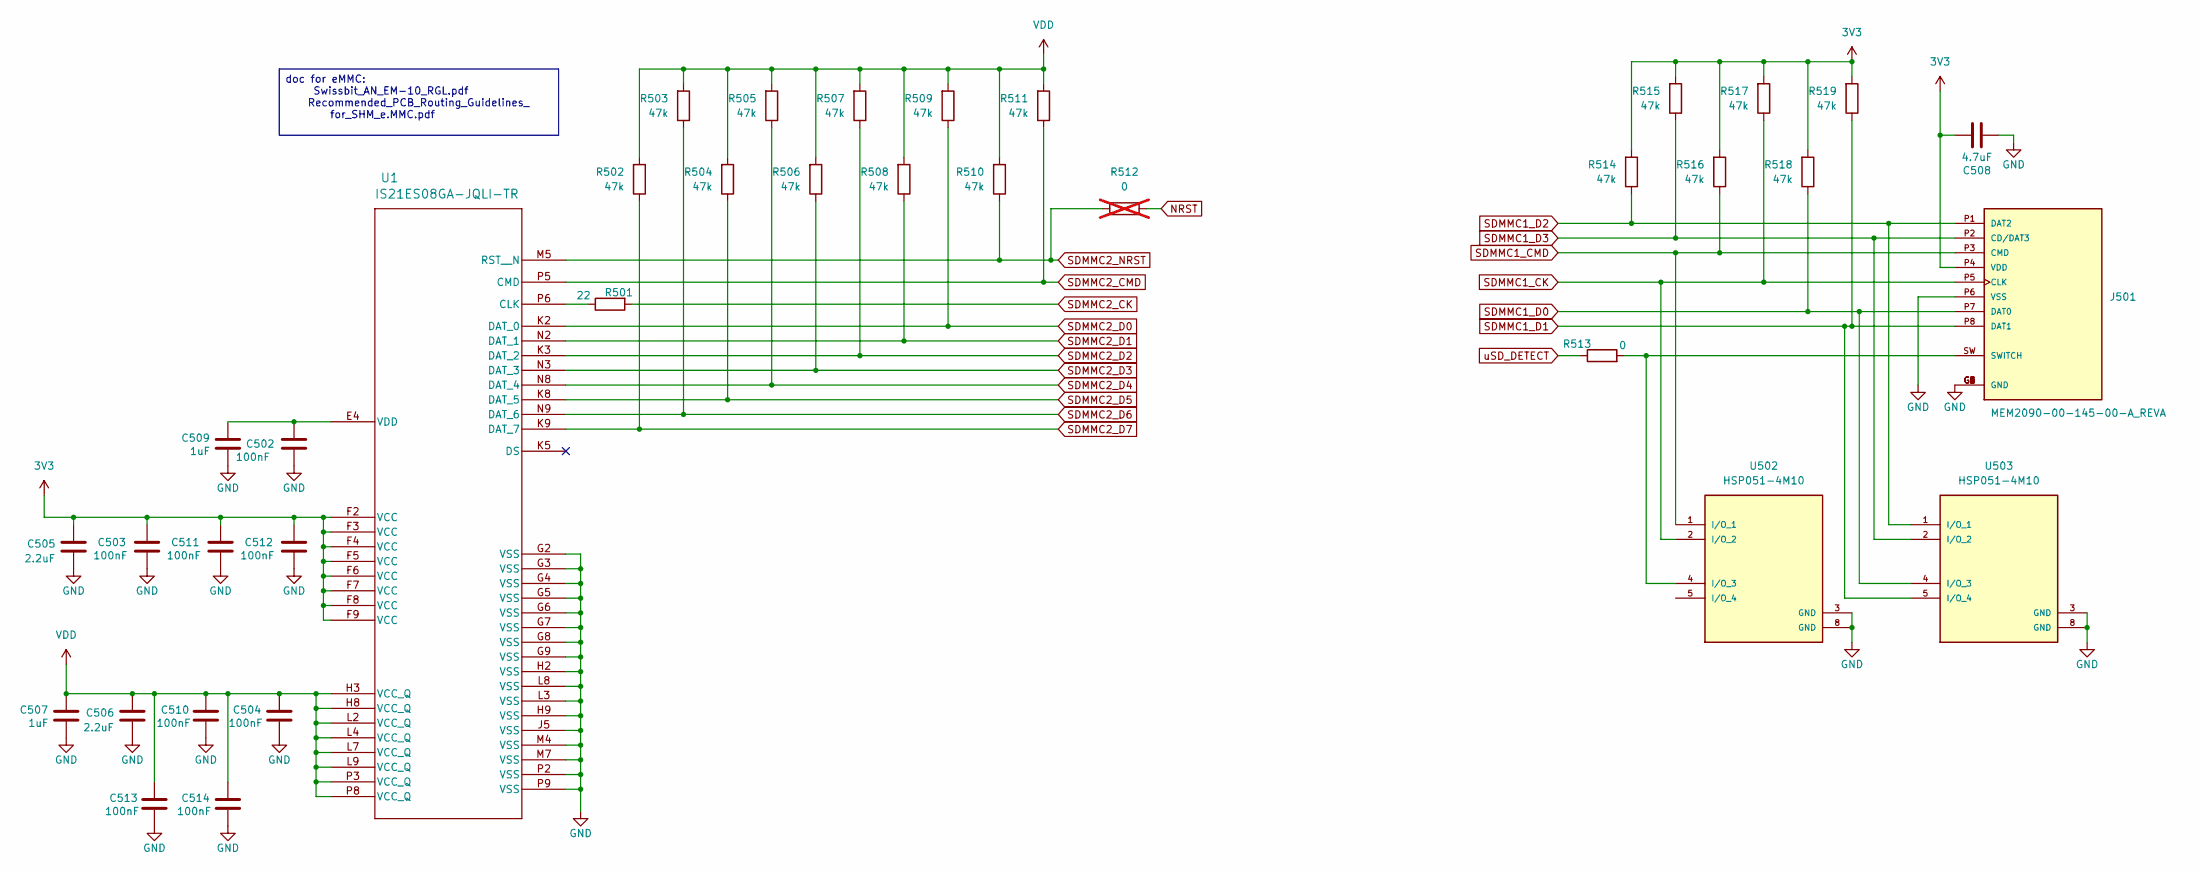
[picture p29: schematic FLASH_SD.kicad_sch]

Parts:
C502, C503, C504, C510, C511, C512, C513, C514: 100nF; C_0402_1005Metric; Mouser P/N 81-GRM155R61E104KA7J
C505, C506: 2.2uF; C_0402_1005Metric; Mouser P/N 81-GRT153R60J225ME3D
C507, C509: 1uF; C_0402_1005Metric; Mouser P/N 81-GRM155R61E105KA2D
C508: 4.7uF; C_0402_1005Metric; Mouser P/N 81-GRM155R60J475ME7J
J501: MEM2090-00-145-00-A_REVA; GCT_MEM2090-00-145-00-A_REVA; Mouser P/N 640-MEM20900014500A
R501: 22; R_0402_1005Metric
R502, R503, R504, R505, R506, R507, R508, R509, R510, R511, R514, R515, R516, R517, R518, R519: 47k; R_0402_1005Metric
R512: 0; R_0402_1005Metric; not fitted
R513: 0; R_0402_1005Metric
U1: IS21ES08GA-JQLI-TR; FBGA100_ISI
U502, U503: HSP051-4M10; IC_HSP051-4M10; Mouser P/N 511-HSP051-4M10

Connections:
3V3: C503.2, C505.1, C508.2, C511.2, C512.2, J501.P4 (VDD), R514.2, R515.2, R516.2, R517.2, R518.2, R519.2, U1.F2 (VCC), U1.F3 (VCC), U1.F4 (VCC), U1.F5 (VCC), U1.F6 (VCC), U1.F7 (VCC), U1.F8 (VCC), U1.F9 (VCC); also elsewhere on the board
GND: C502.1, C503.1, C504.1, C505.2, C506.2, C507.2, C508.1, C509.2, C510.1, C511.1, C512.1, C513.1, C514.1, J501.G1 (GND), J501.G2 (GND), J501.G3 (GND), J501.G4 (GND), J501.G5 (GND), J501.G6 (GND), J501.P6 (VSS), U1.G2 (VSS), U1.G3 (VSS), U1.G4 (VSS), U1.G5 (VSS), U1.G6 (VSS), U1.G7 (VSS), U1.G8 (VSS), U1.G9 (VSS), U1.H2 (VSS), U1.H9 (VSS), U1.J5 (VSS), U1.L3 (VSS), U1.L8 (VSS), U1.M4 (VSS), U1.M7 (VSS), U1.P2 (VSS), U1.P9 (VSS), U502.3 (GND), U502.8 (GND), U503.3 (GND), U503.8 (GND); also elsewhere on the board
NRST: R512.1; also elsewhere on the board
unnamed: J501.SW (SWITCH), R513.2, U502.4 (I/O_3), U502.7 (NC)
unnamed: R501.1, U1.P6 (CLK)
unnamed: C502.2, C509.1, U1.E4 (VDD)
unnamed: U502.5 (I/O_4), U502.6 (NC)
SDMMC1_CK: J501.P5 (CLK), R517.1, U502.2 (I/O_2), U502.9 (NC); also elsewhere on the board
SDMMC1_CMD: J501.P3 (CMD), R516.1, U502.1 (I/O_1), U502.10 (NC); also elsewhere on the board
SDMMC1_D0: J501.P7 (DAT0), R518.1, U503.4 (I/O_3), U503.7 (NC); also elsewhere on the board
SDMMC1_D1: J501.P8 (DAT1), R519.1, U503.5 (I/O_4), U503.6 (NC); also elsewhere on the board
SDMMC1_D2: J501.P1 (DAT2), R514.1, U503.1 (I/O_1), U503.10 (NC); also elsewhere on the board
SDMMC1_D3: J501.P2 (CD/DAT3), R515.1, U503.2 (I/O_2), U503.9 (NC); also elsewhere on the board
SDMMC2_CK: R501.2; also elsewhere on the board
SDMMC2_CMD: R511.1, U1.P5 (CMD); also elsewhere on the board
SDMMC2_D0: R509.1, U1.K2 (DAT_0); also elsewhere on the board
SDMMC2_D1: R508.1, U1.N2 (DAT_1); also elsewhere on the board
SDMMC2_D2: R507.1, U1.K3 (DAT_2); also elsewhere on the board
SDMMC2_D3: R506.1, U1.N3 (DAT_3); also elsewhere on the board
SDMMC2_D4: R505.1, U1.N8 (DAT_4); also elsewhere on the board
SDMMC2_D5: R504.1, U1.K8 (DAT_5); also elsewhere on the board
SDMMC2_D6: R503.1, U1.N9 (DAT_6); also elsewhere on the board
SDMMC2_D7: R502.1, U1.K9 (DAT_7); also elsewhere on the board
SDMMC2_NRST: R510.1, R512.2, U1.M5 (RST__N)
VDD: C504.2, C506.1, C507.1, C510.2, C513.2, C514.2, R502.2, R503.2, R504.2, R505.2, R506.2, R507.2, R508.2, R509.2, R510.2, R511.2, U1.H3 (VCC_Q), U1.H8 (VCC_Q), U1.L2 (VCC_Q), U1.L4 (VCC_Q), U1.L7 (VCC_Q), U1.L9 (VCC_Q), U1.P3 (VCC_Q), U1.P8 (VCC_Q); also elsewhere on the board
uSD_DETECT: R513.1; also elsewhere on the board

Notes on the sheet:
doc for eMMC: Swissbit_AN_EM-10_RGL.pdf Recommended_PCB_Routing_Guidelines_ for_SHM_e.MMC.pdf

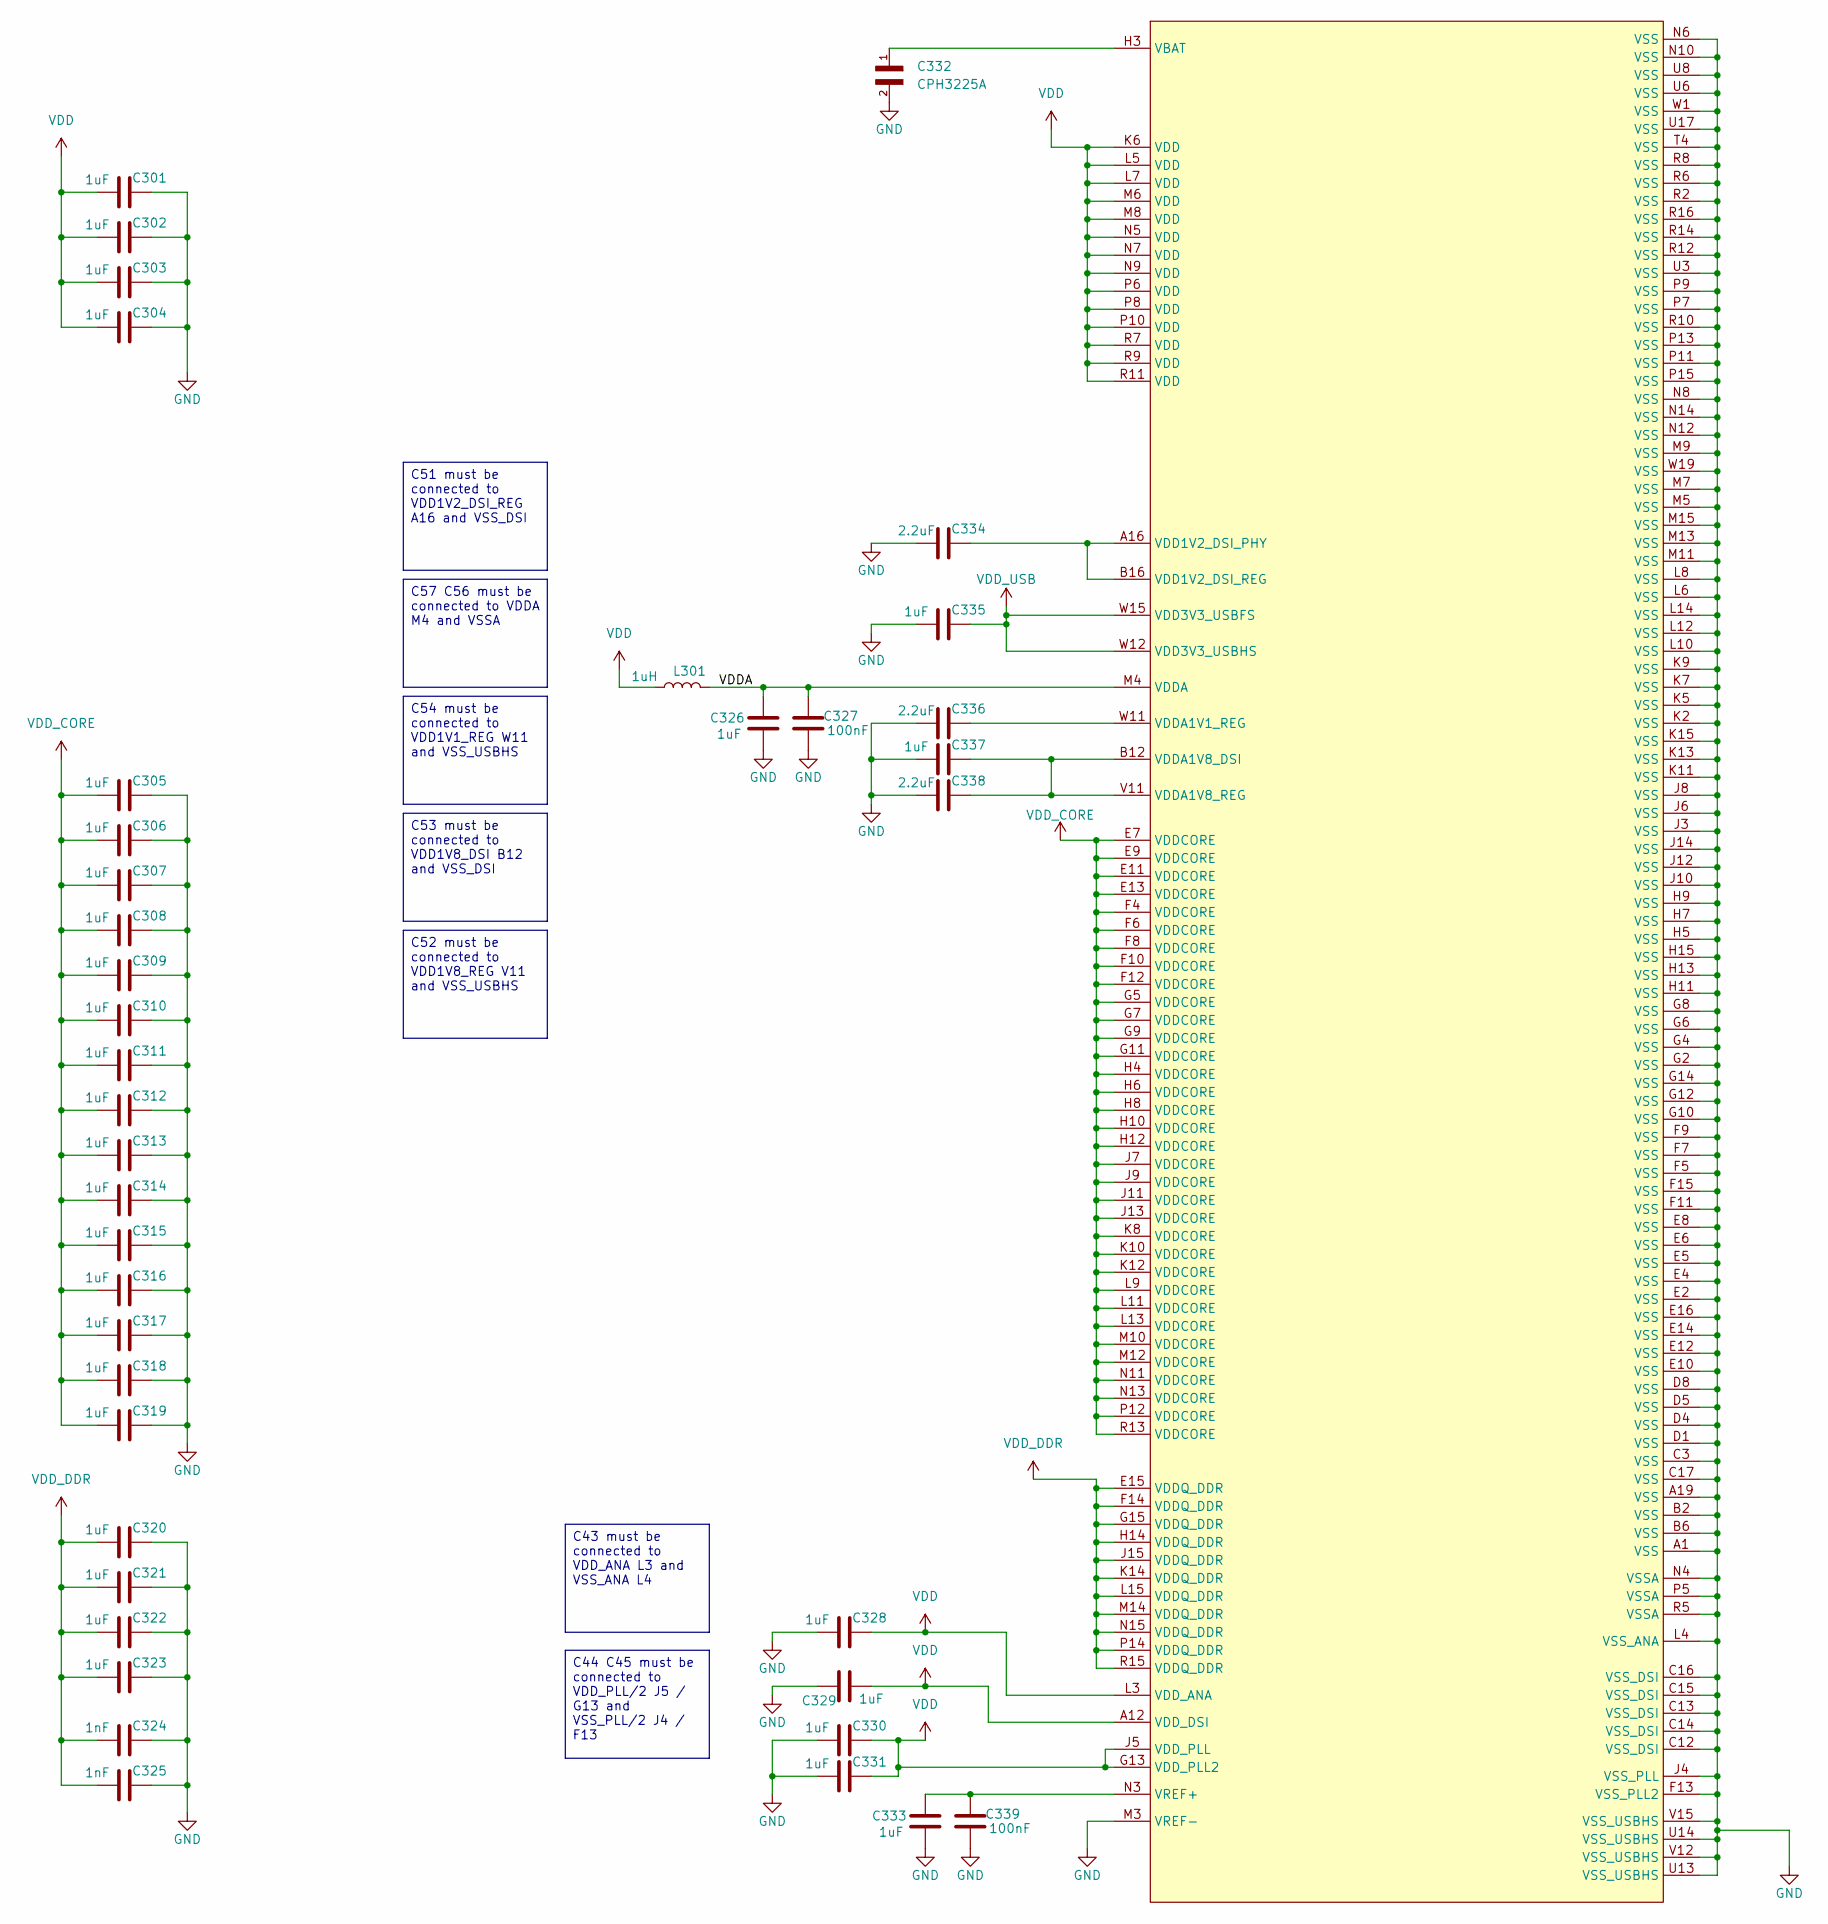
[picture p30: schematic MPU_PWR.kicad_sch]

Parts:
C301, C302, C303, C304, C305, C306, C307, C308, C309, C310, C311, C312, C313, C314, C315, C316, C317, C318, C319, C320, C321, C322, C323, C326, C328, C329, C330, C331, C333, C335, C337: 1uF; C_0402_1005Metric; Mouser P/N 81-GRM155R61E105KA2D
C324, C325: 1nF; C_0402_1005Metric; Mouser P/N 81-GRM155R70J102KA1D
C327, C339: 100nF; C_0402_1005Metric; Mouser P/N 81-GRM155R61E104KA7J
C332: CPH3225A; CAPCP3225X100N
C334, C336, C338: 2.2uF; C_0402_1005Metric; Mouser P/N 81-GRT153R60J225ME3D
L301: 1uH; L_0603_1608Metric; Mouser P/N 810-MLZ1608M4R7WT000
U301: STM32MP157FABx; ST_LFBGA-354_16x16mm_Layout19x19_P0.8mm

Connections:
GND: C301.1, C302.1, C303.1, C304.1, C305.1, C306.1, C307.1, C308.1, C309.1, C310.1, C311.1, C312.1, C313.1, C314.1, C315.1, C316.1, C317.1, C318.1, C319.1, C320.1, C321.1, C322.1, C323.1, C324.1, C325.1, C326.2, C327.2, C328.2, C329.1, C330.2, C331.2, C332.2, C333.2, C334.2, C335.2, C336.2, C337.2, C338.2, C339.2, U301.A1 (VSS), U301.A19 (VSS), U301.B2 (VSS), U301.B6 (VSS), U301.C3 (VSS), U301.C12 (VSS_DSI), U301.C13 (VSS_DSI), U301.C14 (VSS_DSI), U301.C15 (VSS_DSI), U301.C16 (VSS_DSI), U301.C17 (VSS), U301.D1 (VSS), U301.D4 (VSS), U301.D5 (VSS), U301.D8 (VSS), U301.E2 (VSS), U301.E4 (VSS), U301.E5 (VSS), U301.E6 (VSS), U301.E8 (VSS), U301.E10 (VSS), U301.E12 (VSS), U301.E14 (VSS), U301.E16 (VSS), U301.F5 (VSS), U301.F7 (VSS), U301.F9 (VSS), U301.F11 (VSS), U301.F13 (VSS_PLL2), U301.F15 (VSS), U301.G2 (VSS), U301.G4 (VSS), U301.G6 (VSS), U301.G8 (VSS), U301.G10 (VSS), U301.G12 (VSS), U301.G14 (VSS), U301.H5 (VSS), U301.H7 (VSS), U301.H9 (VSS), U301.H11 (VSS), U301.H13 (VSS), U301.H15 (VSS), U301.J3 (VSS), U301.J4 (VSS_PLL), U301.J6 (VSS), U301.J8 (VSS), U301.J10 (VSS), U301.J12 (VSS), U301.J14 (VSS), U301.K2 (VSS), U301.K5 (VSS), U301.K7 (VSS), U301.K9 (VSS), U301.K11 (VSS), U301.K13 (VSS), U301.K15 (VSS), U301.L4 (VSS_ANA), U301.L6 (VSS), U301.L8 (VSS), U301.L10 (VSS), U301.L12 (VSS), U301.L14 (VSS), U301.M3 (VREF-), U301.M5 (VSS), U301.M7 (VSS), U301.M9 (VSS), U301.M11 (VSS), U301.M13 (VSS), U301.M15 (VSS), U301.N4 (VSSA), U301.N6 (VSS), U301.N8 (VSS), U301.N10 (VSS), U301.N12 (VSS), U301.N14 (VSS), U301.P5 (VSSA), U301.P7 (VSS), U301.P9 (VSS), U301.P11 (VSS), U301.P13 (VSS), U301.P15 (VSS), U301.R2 (VSS), U301.R5 (VSSA), U301.R6 (VSS), U301.R8 (VSS), U301.R10 (VSS), U301.R12 (VSS), U301.R14 (VSS), U301.R16 (VSS), U301.T4 (VSS), U301.U3 (VSS), U301.U6 (VSS), U301.U8 (VSS), U301.U13 (VSS_USBHS), U301.U14 (VSS_USBHS), U301.U17 (VSS), U301.V12 (VSS_USBHS), U301.V15 (VSS_USBHS), U301.W1 (VSS), U301.W19 (VSS); also elsewhere on the board
unnamed: C332.1, U301.H3 (VBAT)
unnamed: C334.1, U301.A16 (VDD1V2_DSI_PHY), U301.B16 (VDD1V2_DSI_REG)
unnamed: C336.1, U301.W11 (VDDA1V1_REG)
unnamed: C337.1, C338.1, U301.B12 (VDDA1V8_DSI), U301.V11 (VDDA1V8_REG)
unnamed: C326.1, C327.1, L301.2, U301.M4 (VDDA)
unnamed: C333.1, C339.1, U301.N3 (VREF+)
VDD: C301.2, C302.2, C303.2, C304.2, C328.1, C329.2, C330.1, C331.1, L301.1, U301.A12 (VDD_DSI), U301.G13 (VDD_PLL2), U301.J5 (VDD_PLL), U301.K6 (VDD), U301.L3 (VDD_ANA), U301.L5 (VDD), U301.L7 (VDD), U301.M6 (VDD), U301.M8 (VDD), U301.N5 (VDD), U301.N7 (VDD), U301.N9 (VDD), U301.P6 (VDD), U301.P8 (VDD), U301.P10 (VDD), U301.R7 (VDD), U301.R9 (VDD), U301.R11 (VDD); also elsewhere on the board
VDD_CORE: C305.2, C306.2, C307.2, C308.2, C309.2, C310.2, C311.2, C312.2, C313.2, C314.2, C315.2, C316.2, C317.2, C318.2, C319.2, U301.E7 (VDDCORE), U301.E9 (VDDCORE), U301.E11 (VDDCORE), U301.E13 (VDDCORE), U301.F4 (VDDCORE), U301.F6 (VDDCORE), U301.F8 (VDDCORE), U301.F10 (VDDCORE), U301.F12 (VDDCORE), U301.G5 (VDDCORE), U301.G7 (VDDCORE), U301.G9 (VDDCORE), U301.G11 (VDDCORE), U301.H4 (VDDCORE), U301.H6 (VDDCORE), U301.H8 (VDDCORE), U301.H10 (VDDCORE), U301.H12 (VDDCORE), U301.J7 (VDDCORE), U301.J9 (VDDCORE), U301.J11 (VDDCORE), U301.J13 (VDDCORE), U301.K8 (VDDCORE), U301.K10 (VDDCORE), U301.K12 (VDDCORE), U301.L9 (VDDCORE), U301.L11 (VDDCORE), U301.L13 (VDDCORE), U301.M10 (VDDCORE), U301.M12 (VDDCORE), U301.N11 (VDDCORE), U301.N13 (VDDCORE), U301.P12 (VDDCORE), U301.R13 (VDDCORE); also elsewhere on the board
VDD_DDR: C320.2, C321.2, C322.2, C323.2, C324.2, C325.2, U301.E15 (VDDQ_DDR), U301.F14 (VDDQ_DDR), U301.G15 (VDDQ_DDR), U301.H14 (VDDQ_DDR), U301.J15 (VDDQ_DDR), U301.K14 (VDDQ_DDR), U301.L15 (VDDQ_DDR), U301.M14 (VDDQ_DDR), U301.N15 (VDDQ_DDR), U301.P14 (VDDQ_DDR), U301.R15 (VDDQ_DDR); also elsewhere on the board
VDD_USB: C335.1, U301.W12 (VDD3V3_USBHS), U301.W15 (VDD3V3_USBFS); also elsewhere on the board

Notes on the sheet:
C43 must be connected to VDD_ANA L3 and VSS_ANA L4
C54 must be connected to VDD1V1_REG W11 and VSS_USBHS
C51 must be connected to VDD1V2_DSI_REG A16 and VSS_DSI
C57 C56 must be connected to VDDA M4 and VSSA
C52 must be connected to VDD1V8_REG V11 and VSS_USBHS
C53 must be connected to VDD1V8_DSI B12 and VSS_DSI
C44 C45 must be connected to VDD_PLL/2 J5 / G13 and VSS_PLL/2 J4 / F13

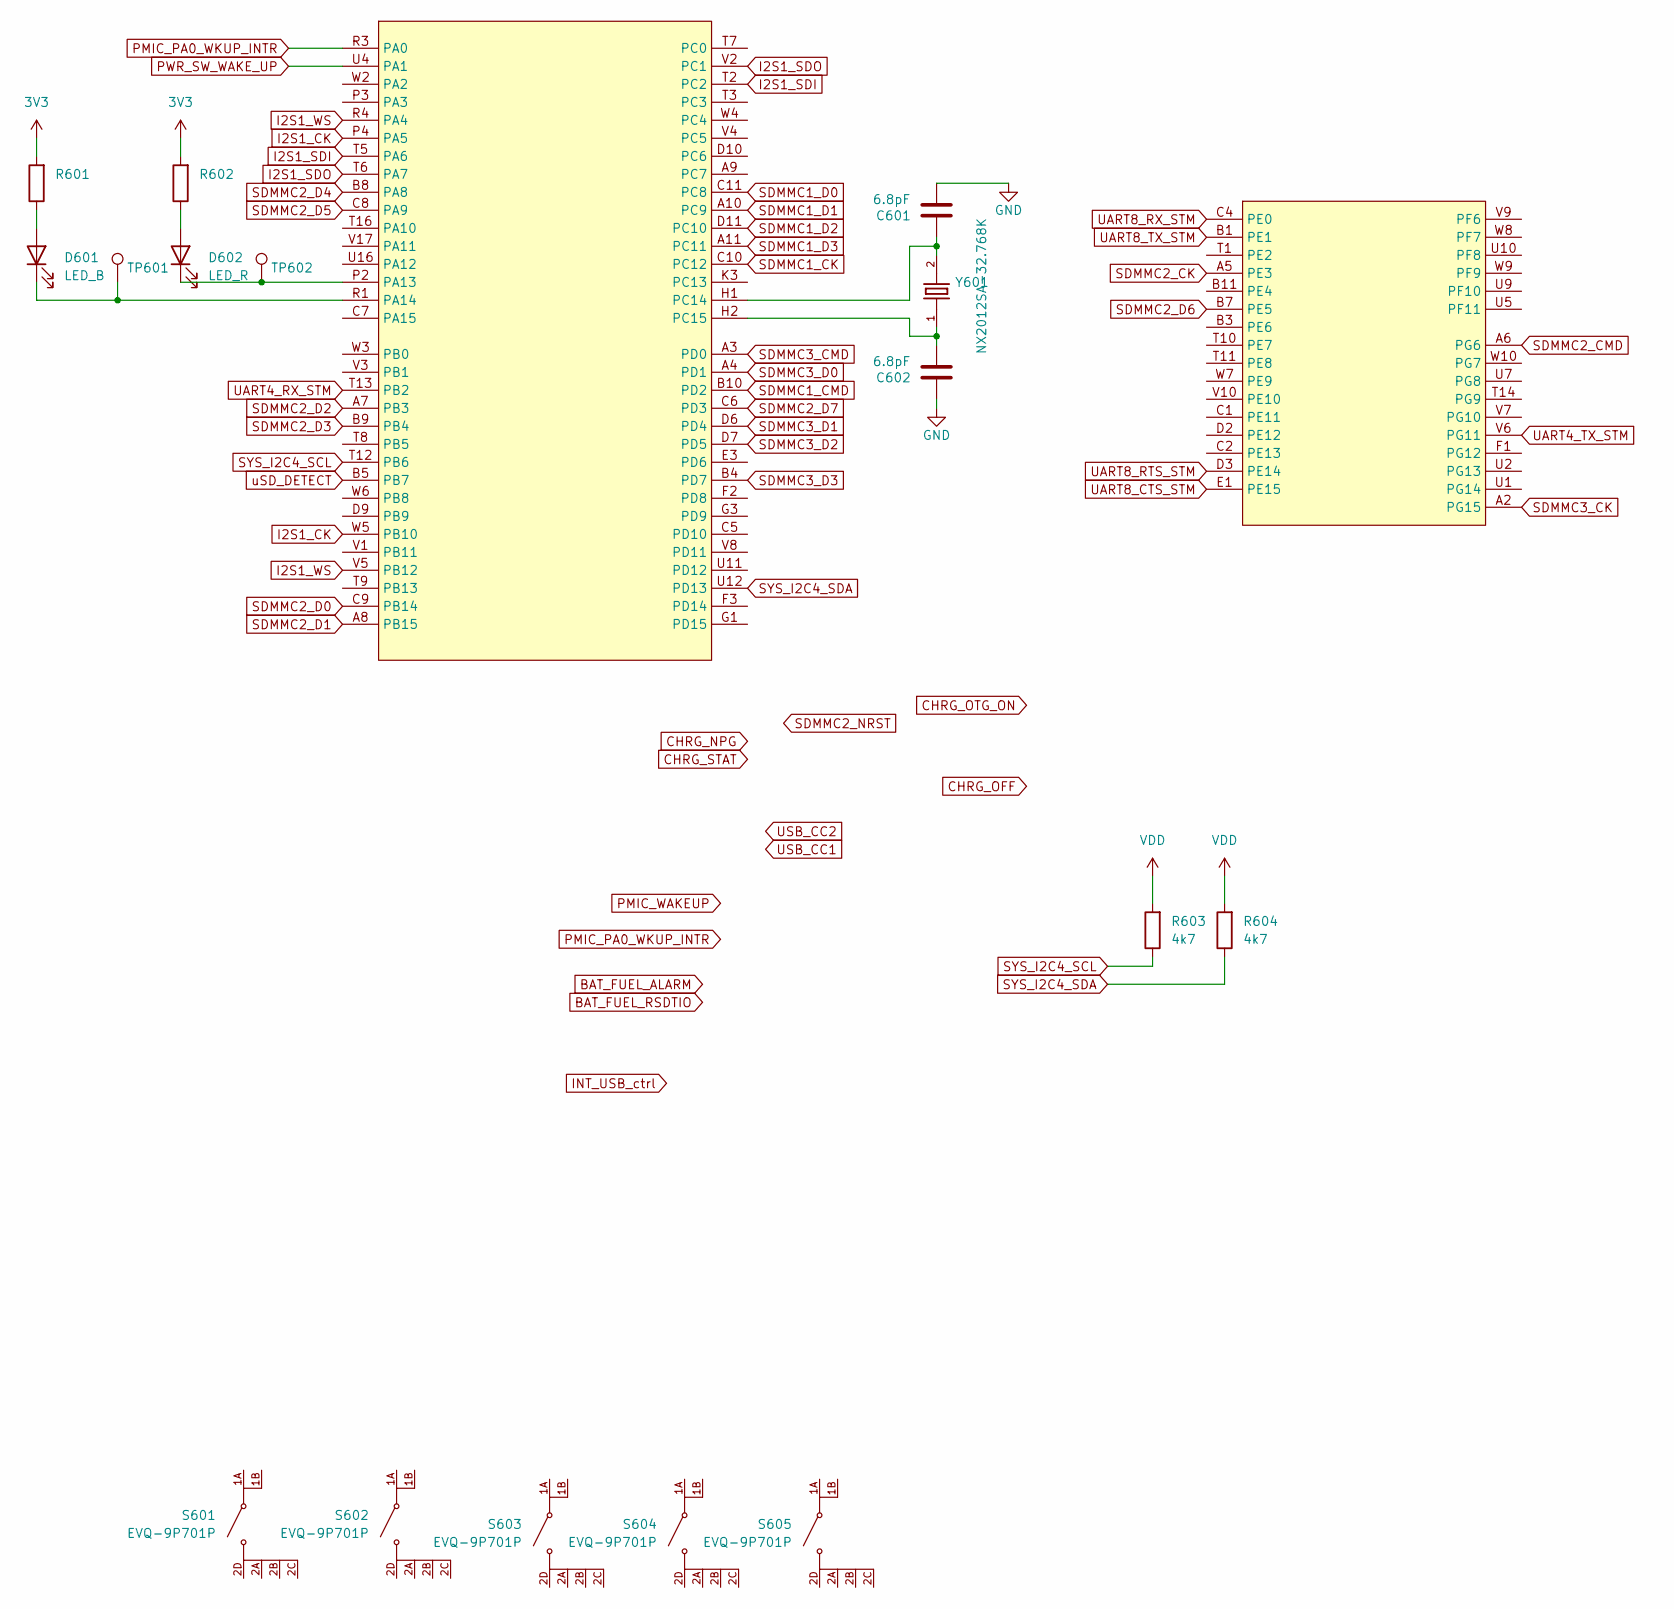
[picture p31: schematic IO_Perph_Conn.kicad_sch]

Parts:
C601, C602: 6.8pF; C_0402_1005Metric
D601: LED_B; LED_0402_1005Metric
D602: LED_R; LED_0402_1005Metric
R601, R602: R_0402_1005Metric
R603, R604: 4k7; R_0402_1005Metric
S601, S602, S603, S604, S605: EVQ-9P701P; SW_EVQ-9P701P; PARTREV N/A
TP601, TP602: TestPoint; TP_0.5mm
U301: STM32MP157FABx; ST_LFBGA-354_16x16mm_Layout19x19_P0.8mm
Y601: NX2012SA-32.768K; XTAL_NX2012SA-32.768K-STD-MUB-1

Connections:
3V3: R601.2, R602.2; also elsewhere on the board
GND: C601.1, C602.2; also elsewhere on the board
I2S1_CK: U301.P4 (PA5), U301.W5 (PB10); also elsewhere on the board
I2S1_SDI: U301.T2 (PC2), U301.T5 (PA6); also elsewhere on the board
I2S1_SDO: U301.T6 (PA7), U301.V2 (PC1); also elsewhere on the board
I2S1_WS: U301.R4 (PA4), U301.V5 (PB12); also elsewhere on the board
unnamed: D601.2 (A), R601.1
unnamed: D601.1 (K), TP601.1, U301.R1 (PA14)
unnamed: D602.2 (A), R602.1
unnamed: D602.1 (K), TP602.1, U301.P2 (PA13)
unnamed: C601.2, U301.H1 (PC14), Y601.2
unnamed: C602.1, U301.H2 (PC15), Y601.1
PMIC_PA0_WKUP_INTR: U301.R3 (PA0); also elsewhere on the board
PWR_SW_WAKE_UP: U301.U4 (PA1); also elsewhere on the board
SDMMC1_CK: U301.C10 (PC12); also elsewhere on the board
SDMMC1_CMD: U301.B10 (PD2); also elsewhere on the board
SDMMC1_D0: U301.C11 (PC8); also elsewhere on the board
SDMMC1_D1: U301.A10 (PC9); also elsewhere on the board
SDMMC1_D2: U301.D11 (PC10); also elsewhere on the board
SDMMC1_D3: U301.A11 (PC11); also elsewhere on the board
SDMMC2_CK: U301.A5 (PE3); also elsewhere on the board
SDMMC2_CMD: U301.A6 (PG6); also elsewhere on the board
SDMMC2_D0: U301.C9 (PB14); also elsewhere on the board
SDMMC2_D1: U301.A8 (PB15); also elsewhere on the board
SDMMC2_D2: U301.A7 (PB3); also elsewhere on the board
SDMMC2_D3: U301.B9 (PB4); also elsewhere on the board
SDMMC2_D4: U301.B8 (PA8); also elsewhere on the board
SDMMC2_D5: U301.C8 (PA9); also elsewhere on the board
SDMMC2_D6: U301.B7 (PE5); also elsewhere on the board
SDMMC2_D7: U301.C6 (PD3); also elsewhere on the board
SDMMC3_CK: U301.A2 (PG15); also elsewhere on the board
SDMMC3_CMD: U301.A3 (PD0); also elsewhere on the board
SDMMC3_D0: U301.A4 (PD1); also elsewhere on the board
SDMMC3_D1: U301.D6 (PD4); also elsewhere on the board
SDMMC3_D2: U301.D7 (PD5); also elsewhere on the board
SDMMC3_D3: U301.B4 (PD7); also elsewhere on the board
SYS_I2C4_SCL: R603.1, U301.T12 (PB6); also elsewhere on the board
SYS_I2C4_SDA: R604.1, U301.U12 (PD13); also elsewhere on the board
UART4_RX_STM: U301.T13 (PB2); also elsewhere on the board
UART4_TX_STM: U301.V6 (PG11); also elsewhere on the board
UART8_CTS_STM: U301.E1 (PE15); also elsewhere on the board
UART8_RTS_STM: U301.D3 (PE14); also elsewhere on the board
UART8_RX_STM: U301.C4 (PE0); also elsewhere on the board
UART8_TX_STM: U301.B1 (PE1); also elsewhere on the board
VDD: R603.2, R604.2; also elsewhere on the board
uSD_DETECT: U301.B5 (PB7); also elsewhere on the board
