KirillYatsenko/tbd/PCB/MPU_MOD.kicad_pcb

## KiCad design PCB/MPU_MOD.kicad_pcb (continued)

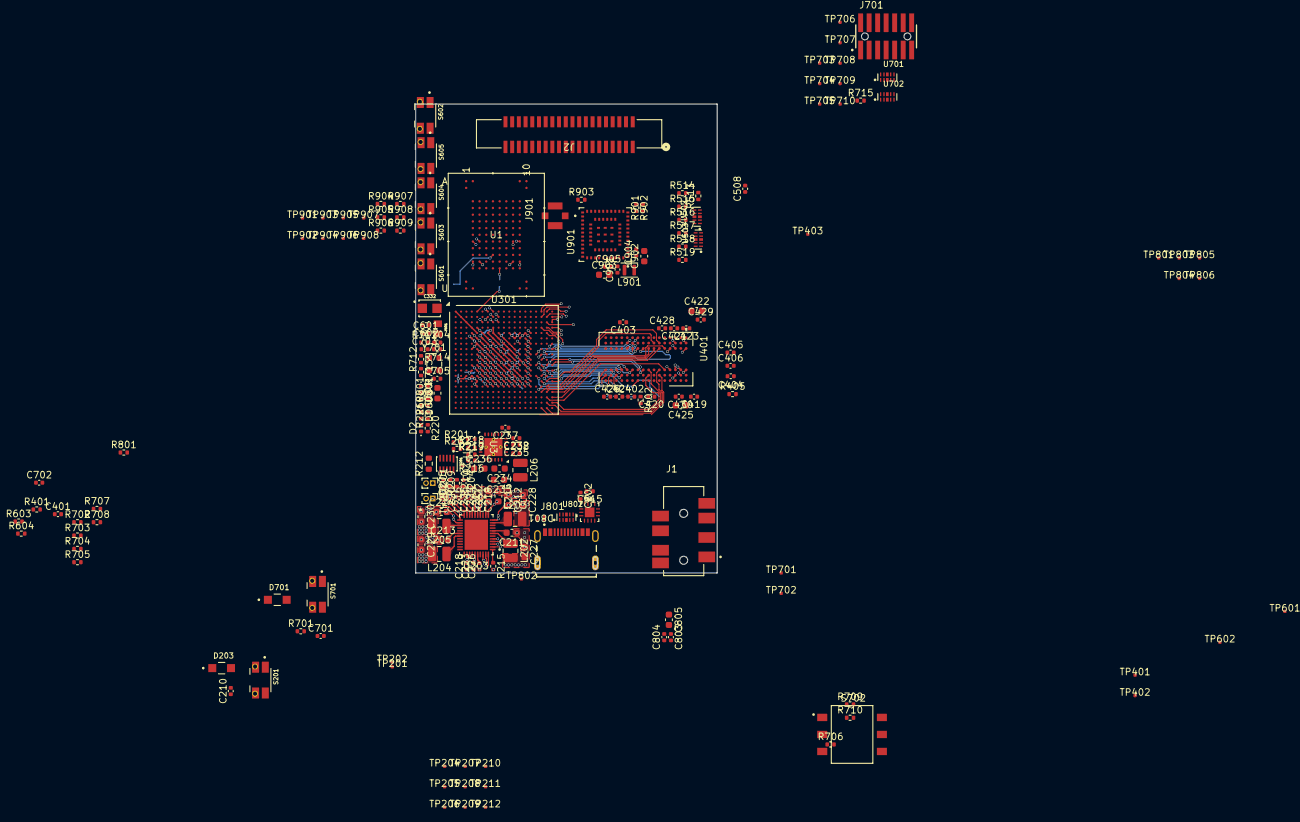
[picture p32: board MPU_MOD.kicad_pcb from above]

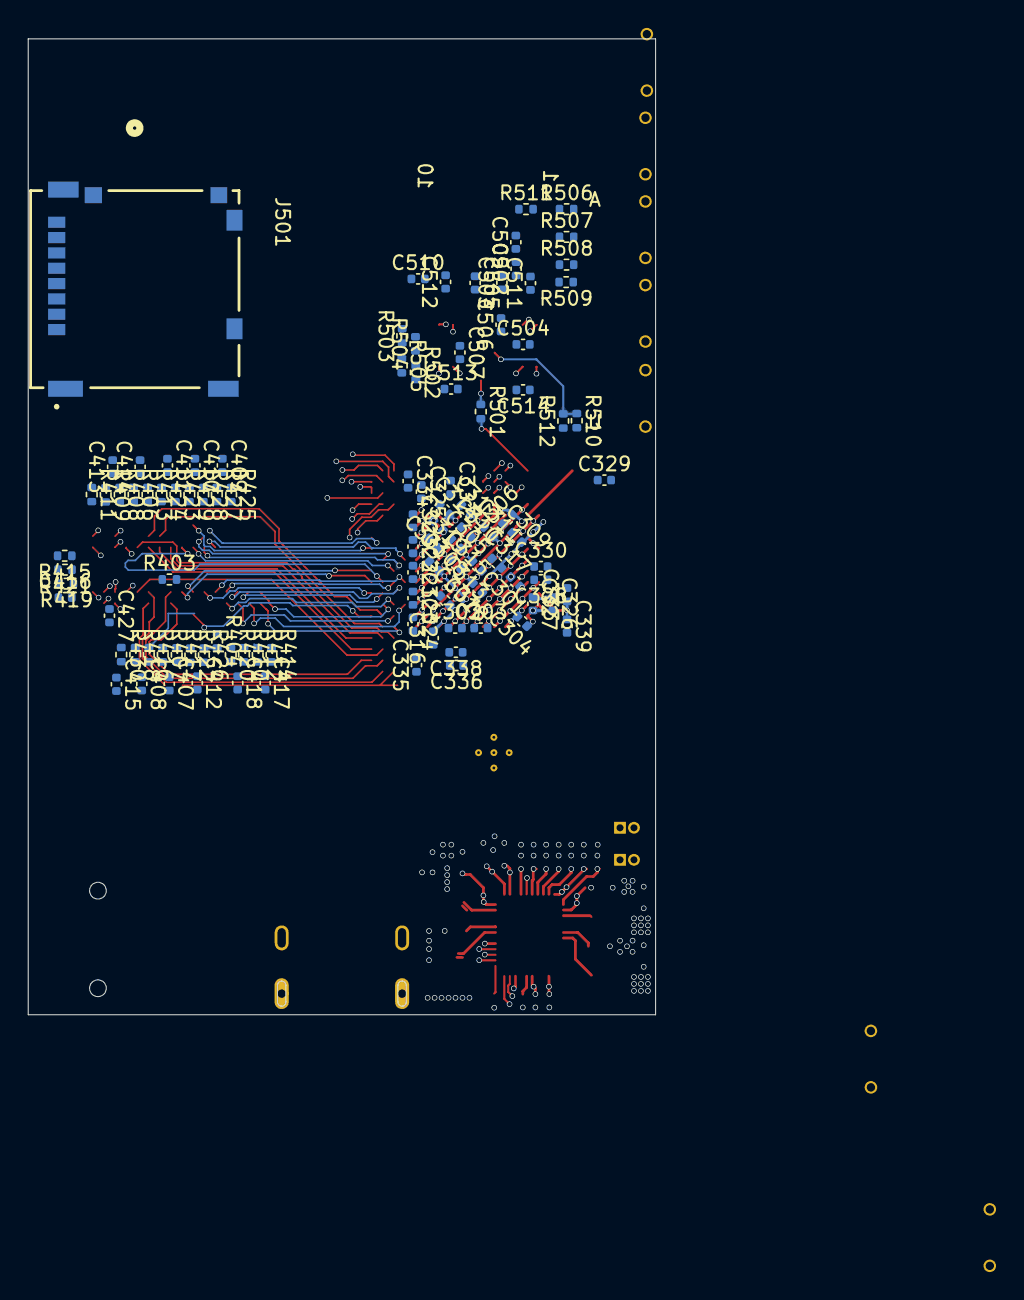
[picture p33: board MPU_MOD.kicad_pcb from below]

Board: 8 copper layers, 45.0 x 70.0 mm, 305 parts (103 on the bottom side), 176 nets.
