KirillYatsenko/tbd/cube/cube.ioc

Mcu.UserName=STM32MP157FABx
PA0.Signal=PWR_WKUP1
PA13.Signal=RCC_MCO_1
PA2.Signal=PWR_WKUP2
PA4.Signal=I2S1_WS
PA5.Signal=I2S1_CK
PA6.Signal=I2S1_SDI
PA7.Signal=I2S1_SDO
PA8.Signal=SDMMC2_D4
PA9.Signal=SDMMC2_D5
PB10.Signal=I2S2_CK
PB12.Signal=I2S2_WS
PB14.Signal=SDMMC2_D0
PB15.Signal=SDMMC2_D1
PB2.Signal=UART4_RX
PB3.Signal=SDMMC2_D2
PB4.Signal=SDMMC2_D3
PB6.Signal=I2C4_SCL
PC1.Signal=I2S2_SDO
PC10.Signal=SDMMC1_D2
PC11.Signal=SDMMC1_D3
PC12.Signal=SDMMC1_CK
PC14-OSC32_IN.Signal=RCC_OSC32_IN
PC15-OSC32_OUT.Signal=RCC_OSC32_OUT
PC2.Signal=I2S2_SDI
PC8.Signal=SDMMC1_D0
PC9.Signal=SDMMC1_D1
PD0.Signal=SDMMC3_CMD
PD1.Signal=SDMMC3_D0
PD13.Signal=I2C4_SDA
PD2.Signal=SDMMC1_CMD
PD3.Signal=SDMMC2_D7
PD4.Signal=SDMMC3_D1
PD5.Signal=SDMMC3_D2
PD7.Signal=SDMMC3_D3
PE0.Signal=UART8_RX
PE1.Signal=UART8_TX
PE14.Signal=UART8_RTS
PE15.Signal=UART8_CTS
PE3.Signal=SDMMC2_CK
PE5.Signal=SDMMC2_D6
PG11.Signal=UART4_TX
PG15.Signal=SDMMC3_CK
PG6.Signal=SDMMC2_CMD
PH0-OSC_IN.Signal=RCC_OSC_IN
PH1-OSC_OUT.Signal=RCC_OSC_OUT
