KirillYatsenko/tbd/(commit log)

2025-04-17 added pcb repo. MPU sumbol, rev doc
    [MPU_MOD.kicad_pcb, MPU_MOD.kicad_sch]
2025-04-17 pcb update
2025-04-22 PCB_UPDATE. PWR DONE, DDR STARTED
    [DDR.kicad_sch, MPU_MOD.kicad_pcb, MPU_MOD.kicad_sch, MPU_PWR.kicad_sch, PWR.kicad_sch]
2025-04-23 added Dustin's review pdf for MMU power
2025-04-23 Look like MPU done
    [FLASH_SD.kicad_sch, IO_Perph_Conn.kicad_sch, PWR.kicad_sch, RCC_BOOT_RST_DEBUG.kicad_sch]
2025-04-29 added eMMC
    [DDR.kicad_sch, FLASH_SD.kicad_sch, IO_Perph_Conn.kicad_sch, PWR.kicad_sch, RCC_BOOT_RST_DEBUG.kicad_sch]
2025-05-02 wifi done
    [DAC.kicad_sch, IO_Perph_Conn.kicad_sch, MPU_MOD.kicad_pcb, PWR.kicad_sch, RCC_BOOT_RST_DEBUG.kicad_sch, WIFI_BLE.kicad_sch]
2025-05-10 ADDED PCB FROM STM
    [1DDR3L_16bits.SchDoc, AUDIO.SchDoc, DDR3L_Memory_length_equalization_in_mm_for_STM32MP15XXAB_B01.xls, DDR3_16bits.SchDoc, DSI_LCD.SchDoc, Ethernet.SchDoc, GPIO_&_Arduino_ Connectors.SchDoc, HDMI.SchDoc]
2025-06-14 PSB_ADAPTER UPDATE
    [LCD_Adapter.kicad_pcb, LCD_Adapter.kicad_sch]
